Sheen-Cao/Ballooance/Pics/image 47.png

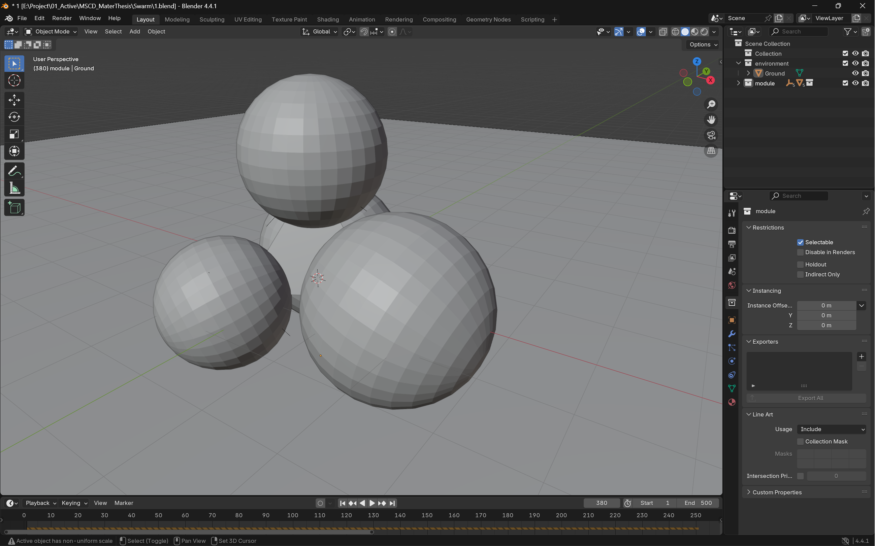
Pics/image 47.png
