Sheen-Cao/Ballooance/Pics/bg_sr_1.jpg

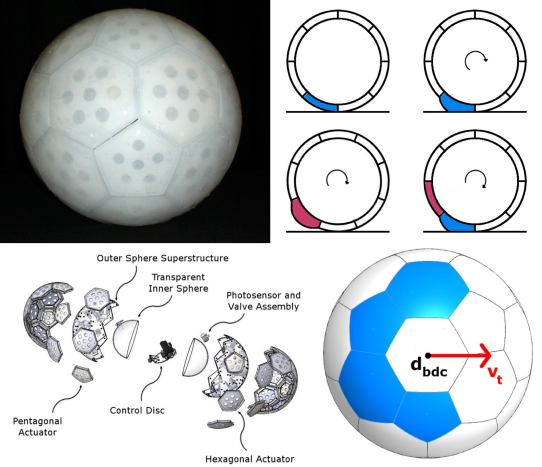
Pics/bg_sr_1.jpg
