Sheen-Cao/Ballooance/README.md

# Ballooance
This this the developing repo for my thesis research project of the inflatable modular robot
