Sheen-Cao/Ballooance/paper_notes/wait_2010_spherical_pneumatic_rolling.md

# Wait, Jackson, Smoot 2010 — Self Locomotion of a Spherical Rolling Robot Using a Novel Deformable Pneumatic Method

**Type:** Conference paper, *2010 IEEE International Conference on Robotics and Automation (ICRA)*
**Authors:** Keith W. Wait (Vanderbilt), Philip J. Jackson, Lanny S. Smoot (**Disney Research**)
**Citation key:** `waitSelfLocomotionSpherical2010`

## Core Claim

A spherical rolling robot whose outer surface is composed of **many individually inflatable rubber bladders** (specifically, a truncated icosahedron with 20 hexagonal + 12 pentagonal cells = 32 segments — soccer-ball topology). Locomotion is achieved by inflating cells near the contact point with the ground, creating a moment that rolls the sphere.

## Critical Correction to Initial §2.1 Draft

My §2.1 v1 said: *"a spherical robot covered with many individually inflatable rubber bladders rolls by shifting its center of mass through selective inflation."*

**This is partially wrong.** The actual mechanism is described in the paper as:

> "Deforming the robot's surface close to its point of contact with the substrate provides the motive force." (Abstract / Introduction)

> "The segment deforms radially outward so that, in addition to touching the ground, it also exerts a moment about the instantaneous center of rotation of the device. This moment causes the tire to begin to rotate." (Sec. II)

So the primary mechanism is **local surface deformation at the contact point creating a rolling moment**, not CoM shift through asymmetric inflation. (CoM may shift slightly as a secondary effect.) When citing in §2.1, replace "shifting its center of mass" with "deforming its surface at the contact point to apply a rolling moment" — or more loosely, "inflating bladders near the ground produces local contact deformation that rolls the sphere."

## Key Technical Details

- **32 inflatable cells** in truncated-icosahedron arrangement (the same topology as a soccer ball / Buckminsterfullerene)
- **3D requires inflating multiple cells**: "Inflation of a single face... results in an indeterminate direction of motion because of the metastability of the resulting deformed geometry." So the controller inflates a *collection* of cells semi-encircling bottom dead center.
- **Steering criteria**: cells are inflated based on geometric criteria involving the displacement vector to bottom dead center and the desired travel direction (Eqs. 1, 2 in paper).
- **Approximate diameter**: 30 cm.
- **Optical commutation**: a passively rolling inner vehicle with a directional remote light source triggers valves housed within the sphere → bladders inflate based on light signal — clever but specific to this implementation.

## Quotable Passages

> "The proposed actuation system consists of a large number of individually inflatable rubber bladders covering a sphere. Inflation of one or more of these bladders imparts a moment to the sphere and coordinated inflation results in a directed motion." (Abstract)

> "All of the propulsive force must somehow be generated by components all of whom are confined within a spherical shape." (Introduction)

> "While in the two-dimensional example... a single inflated segment was sufficient for both locomotion and stability, this is not true for the three-dimensional case." (Sec. II) — *useful for arguing that geometric configuration matters even for inflation-based locomotion.*

## Relevance Per Section

### §2.1 (Soft + Pneumatic) — *primary citation here*
- Demonstrates that pneumatic inflation of soft surfaces can drive locomotion of an entire robot body — even one as constrained-shape as a sphere.
- Shows that **selecting which inflatable cells to actuate** is itself a control decision, separate from how each cell behaves. (This is a small but important precursor to the user's "configuration as design variable" argument.)
- Use as the **second** specific system in §2.1 (after Kim's vibration tripod), because the locomotion mechanism is more topologically interesting than Kim's, with multiple cells coordinated.

### §2.2 (Morphological computation / shape) — *secondary*
- The truncated icosahedron is a **fixed polyhedral topology** — Wait et al. don't compare different polyhedra. Mention them as a precedent for "polyhedron + pneumatic = locomotion" but emphasize they did *not* treat configuration as a variable.

### §2.3 (Modular reconfigurable robotics) — *NOT a primary fit*
- The 32 cells are *not* swappable modules in the MRR sense — they are integral to a single rigid spherical superstructure. Don't cite as MRR.

### §2.4 (Emergence / bottom-up) — *not relevant*
- Control is fully top-down: based on bottom dead center + desired travel direction, the controller computes which cells to inflate. No emergent collective behavior.

## Distinction from the Thesis Work

| | Wait 2010 | This thesis |
|---|---|---|
| Body type | Single spherical shell with embedded cells | Discrete inflated modules forming a polyhedral skeleton |
| Cell role | Surface-deformation actuator on a fixed sphere | Vertex module that defines the body's geometry |
| Geometric variability | Fixed truncated icosahedron, no comparison | Cospherical family (tetra/octa/cube...) systematically compared |
| Controller | Top-down: select cells based on direction vector | Bottom-up CA-style local rules |

**Strong positioning move:** Wait's robot is a *single body with inflation embedded in its surface*. The thesis is *modules whose inflation defines the body itself*. Use this contrast to highlight the qualitative difference between "inflation as actuator on a body" and "inflation as the body."

## Watch out for / Nuances

1. The paper is a **conference paper from 2010** — older context. It precedes the modern soft robotics framing (Rus & Tolley 2015 etc.) and doesn't use that vocabulary.
2. The mechanism is *contact-driven moment*, not CoM shift — be precise in §2.1.
3. The Disney Research affiliation is interesting context (entertainment robotics roots) but not load-bearing for the argument.
4. Wait et al. explicitly note their design "can be easily amended to instead use other linear actuators such as voice coils, electric DC motors with ball screw transmissions" — i.e., they don't see pneumatic as essential to the *principle*, just to *their* implementation. This is a useful disclaimer to cite if anyone challenges the claim that "pneumatic actuation is special" — Wait et al. would mostly disagree.
