Sheen-Cao/Ballooance/ch2_zotero_extract.md

# Ch.2 Background — Zotero Library Extract

Source: `C:\Users\Sheen\Zotero\zotero.sqlite` (snapshot 2026-04-29)

---

## Collection: Emergence and Control (16 items)

### [1] Bio-Inspired Distributed Neural Locomotion Controller (D-NLC) for Robust Locomotion and Emergent Behaviors ()
- **Authors:** Zhang, Zhikai; Guo, Siqi; Kou, Henry; Shikhare, Ishayu et al.
- **Venue:** —
- **Abstract:** Despite having fewer neurons than more complex life forms, insects are still capable of producing astonishing locomotive behaviors, such as traversing diverse environments and making rapid gait adaptations after extreme injury or autotomy. Biologists attribute this to a chain of segmental neuron clusters (ganglia) within insect nervous systems, which act as distributed self-organizing sensorimotor control units. Inspired by the neural structure of the Carausius morosus, the common stick insect, this work introduces the Distributed Neural Locomotion Controller (D-NLC), a modular control framewo...

### [2] From Natural to Arti cial Swarm Intelligence (1999)
- **Authors:** Bonabeau, Eric; Dorigo, Marco; Theraulaz, Guy
- **Venue:** —

### [3] Complex behaviors from local rules in modular self-reconfigurable robots (2001)
- **Authors:** Kubica, J.; Casal, A.; Hogg, T.
- **Venue:** 2001 ICRA. IEEE International Conference on Robotics and Automation (Cat. No.01CH37164)
- **Abstract:** We demonstrate how simple local rules, inspired by social insects, produce complex dynamic behaviors required for locomotion and navigation in modular self-reconfigurable robots. We show how systems made up of many modules respond dynamically to their environment, such as obstacles during navigation. We present control algorithms tested on simulation experiments of TeleCube, a new modular robot developed at Xerox PARC.

### [4] Self-Organization in Biological Systems (2001)
- **Authors:** Camazine, Scott; Deneubourg, Jean-Louis; Franks, Nigel R.; Sneyd, James et al.
- **Venue:** Princeton University Press
- **Abstract:** The synchronized flashing of fireflies at night. The spiraling patterns of an aggregating slime mold. The anastomosing network of army-ant trails. The coordinated movements of a school of fish. Researchers are finding in such patterns--phenomena that have fascinated naturalists for centuries--a fertile new approach to understanding biological systems: the study of self-organization. This book, a primer on self-organization in biological systems for students and other enthusiasts, introduces readers to the basic concepts and tools for studying self-organization and then examines numerous exampl...

### [5] An Information-Theoretic Primer on Complexity, Self-Organisation and Emergence (2006)
- **Authors:** Prokopenko, Mikhail; Boschetti, Fabio; Ryan, Alex
- **Venue:** Complexity
- **Abstract:** Complex Systems Science aims to understand concepts like complexity, self-organization, emergence and adaptation, among others. The inherent fuzziness in complex systems definitions is complicated by the unclear relation among these central processes: does self-organisation emerge or does it set the preconditions for emergence? Does complexity arise by adaptation or is complexity necessary for adaptation to arise? The inevitable consequence of the current impasse is miscommunication among scientists within and across disciplines. We propose a set of concepts, together with their information- t...

### [6] How emergence arises (2006)
- **Authors:** de Haan, J.
- **Venue:** Ecological Complexity
- **Abstract:** The concept of emergence is used in a variety of scientific fields and disciplines to denote an even wider variety of phenomena. This has resulted in a plethora of perspectives and treatments. The diversity of phenomena going under the moniker of emergence raises the question of what these phenomena have in common and whether different types of emergence can be distinguished on general grounds. Since emergence is recognised in so many different fields as a relevant concept, it would be useful to have a general conceptual framework that allows a treatment of emergence without explicit reference...

### [7] How the body shapes the way we think: a new view of intelligence (2007)
- **Authors:** Pfeifer, Rolf; Bongard, Josh
- **Venue:** MIT Press

### [8] Complexity: a guided tour (2011)
- **Authors:** Mitchell, Melanie
- **Venue:** Oxford University Press

### [9] Emergent complex behaviors for swarm robotic systems by local rules (2011)
- **Authors:** Chatty, Abdelhak; Kallel, Ilhem; Gaussier, Philippe; Alimi, Adel M.
- **Venue:** 2011 IEEE Workshop on Robotic Intelligence In Informationally Structured Space
- **Abstract:** This paper describes a clustering process taking inspiration from the cemetery organization of ants. The goal of this paper is (i) to show the importance of the local interactions which allow to produces complex and emergent behavior. (ii) To propose a multi-robot systems in the field of clustering objects allowing optimization of: time of convergence, rate of occupation of the objects in the environment and final number of the clusters. And finally (iii) to propose another system with the use of cognitive robots instead of reactive robots in the same field of clustering objects with generic r...

### [10] What is a complex system? (2013)
- **Authors:** Ladyman, James; Lambert, James; Wiesner, Karoline
- **Venue:** European Journal for Philosophy of Science
- **Abstract:** Complex systems research is becoming ever more important in both the natural and social sciences. It is commonly implied that there is such a thing as a complex system across the disciplines. However, there is no concise definition of a complex system, let alone a definition that all disciplines agree on. We review various attempts to characterize a complex system, and consider a core set of features that are widely associated with complex systems by scientists in the field. We argue that some of these features are neither necessary nor sufficient for complexity, and that some of them are too ...

### [11] Programmable self-assembly in a thousand-robot swarm (2014)
- **Authors:** Rubenstein, Michael; Cornejo, Alejandro; Nagpal, Radhika
- **Venue:** Science
- **Abstract:** Self-assembly enables nature to build complex forms, from multicellular organisms to complex animal structures such as flocks of birds, through the interaction of vast numbers of limited and unreliable individuals. Creating this ability in engineered systems poses challenges in the design of both algorithms and physical systems that can operate at such scales. We report a system that demonstrates programmable self-assembly of complex two-dimensional shapes with a thousand-robot swarm. This was enabled by creating autonomous robots designed to operate in large groups and to cooperate through lo...

### [12] Programmable self-assembly (2015)
- **Authors:** Cademartiri, Ludovico; Bishop, Kyle J. M.
- **Venue:** Nature Materials
- **Abstract:** Two conceptual strategies for encoding information into self-assembling building blocks highlight opportunities and challenges in the realization of programmable colloidal nanostructures.

### [13] The Surprising Creativity of Digital Evolution: A Collection of Anecdotes from the Evolutionary Computation and Artificial Life Research Communities (2020)
- **Authors:** Lehman, Joel; Clune, Jeff; Misevic, Dusan; Adami, Christoph et al.
- **Venue:** Artificial Life
- **Abstract:** Evolution provides a creative fount of complex and subtle adaptations that often surprise the scientists who discover them. However, the creativity of evolution is not limited to the natural world: Artificial organisms evolving in computational environments have also elicited surprise and wonder from the researchers studying them. The process of evolution is an algorithmic process that transcends the substrate in which it occurs. Indeed, many researchers in the field of digital evolution can provide examples of how their evolving algorithms and organisms have creatively subverted their expecta...

### [14] Learning Modular Robot Control Policies (2023)
- **Authors:** Whitman, Julian; Travers, Matthew; Choset, Howie
- **Venue:** IEEE Transactions on Robotics
- **Abstract:** Modular robots can be rearranged into a new design, perhaps each day, to handle a wide variety of tasks by forming a customized robot for each new task. However, reconfiguring just the mechanism is not sufficient: each design also requires its own unique control policy. One could craft a policy from scratch for each new design, but such an approach is not scalable, especially given the large number of designs that can be generated from even a small set of modules. Instead, we create a modular policy framework where the policy structure is conditioned on the hardware arrangement, and use just o...

### [15] Robo-Matter towards reconfigurable multifunctional smart materials (2024)
- **Authors:** Wang, Jing; Wang, Gao; Chen, Huaicheng; Liu, Yanping et al.
- **Venue:** Nature Communications
- **Abstract:** Maximizing materials utilization efficiency via enhancing their reconfigurability and multifunctionality offers a promising avenue in addressing the global challenges in sustainability. To this end, significant efforts have been made in developing reconfigurable multifunctional smart materials, which can exhibit remarkable behaviors such as morphing and self-healing. However, the difficulty in efficiently manipulating and controlling matter at the building block level with manageable cost and complexity, which is crucial to achieving superior responsiveness to environmental clues and stimuli, ...

### [16] Discovery and Deployment of Emergent Robot Swarm Behaviors via Representation Learning and Real2Sim2Real Transfer (2025)
- **Authors:** Mattson, Connor; Raveendra, Varun; Vega, Ricardo; Nowzari, Cameron et al.
- **Venue:** International Foundation for Autonomous Agents and Multiagent Systems
- **Abstract:** Given a swarm of limited-capability robots, we seek to automatically discover the set of possible emergent behaviors. Prior approaches to behavior discovery rely on human feedback or hand-crafted behavior metrics to represent and evolve behaviors and only discover behaviors in simulation, without testing or considering the deployment of these new behaviors on real robot swarms. In this work, we present Real2Sim2Real Behavior Discovery via Self-Supervised Representation Learning, which combines representation learning and novelty search to discover possible emergent behaviors automatically in s...

---

## Collection: Robotic Embodiment (32 items)

### [1] Agile legged locomotion in reconfigurable modular robots ()
- **Authors:** —
- **Venue:** —

### [2] Multifunctional Fluidic Units for Emergent, Responsive Robotic Behaviors ()
- **Authors:** Mousa, Mostafa; Comoretto, Alberto; Overvelde, Johannes T.B.; Forte, Antonio E.
- **Venue:** Advanced Materials
- **Abstract:** Fluidic circuits have shown significant promise in enabling complex functionality in soft robots with a minimal number of input signals. However, implementing complex behaviors typically involves numerous specialized components, resulting in intricate and nonversatile circuits. To address this challenge, a multifunctional fluidic unit designed to operate flexibly as a valve, sensor, or actuator is introduced. This unit provides an extensive design space that allows precise tuning to achieve the desired functionality. In particular, one configuration integrates all three functions simultaneousl...

### [3] troubleshooting_translator_issues [Zotero Documentation] ()
- **Authors:** —
- **Venue:** —

### [4] New Robotics: Design Principles for Intelligent Systems (2005)
- **Authors:** Pfeifer, Rolf; Iida, Fumiya; Bongard, Josh
- **Venue:** Artificial life
- **Abstract:** New robotics is an approach to robotics that, in contrast to traditional robotics, employs ideas and principles from biology. While in the traditional approach there are generally accepted methods (e. g., from control theory), designing agents in the new robotics approach is still largely considered an art. In recent years, we have been developing a set of heuristics, or design principles, that on the one hand capture theoretical insights about intelligent (adaptive) behavior, and on the other provide guidance in actually designing and building systems. In this article we provide an overview o...

### [5] Self locomotion of a spherical rolling robot using a novel deformable pneumatic method (2010)
- **Authors:** Wait, Keith W.; Jackson, Philip J.; Smoot, Lanny S.
- **Venue:** 2010 IEEE International Conference on Robotics and Automation
- **Abstract:** The authors have designed and constructed a new type of actuation for a spherical robot. The proposed actuation system consists of a large number of individually inflatable rubber bladders covering a sphere. Inflation of one or more of these bladders imparts a moment to the sphere and coordinated inflation results in a directed motion. Further, the authors introduce a scheme for steering the robot by correctly selecting the proper bladders to inflate so that motive force is developed in a specified direction. The control scheme utilizes a passively rolling inner vehicle with a directional, rem...

### [6] Design, fabrication and control of soft robots (2015)
- **Authors:** Rus, Daniela; Tolley, Michael T.
- **Venue:** Nature
- **Abstract:** Conventionally, engineers have employed rigid materials to fabricate precise, predictable robotic systems, which are easily modeled as rigid members connected at discrete joints. Natural systems, however, often match or exceed the performance of robotic systems with deformable bodies. Cephalopods, for example, achieve amazing feats of manipulation and locomotion without a skeleton; even vertebrates like humans achieve dynamic gaits by storing elastic energy in their compliant bones and soft tissues. Inspired by nature, engineers have begun to explore the design and control of soft-bodied robot...

### [7] Modular robotic systems: Methods and algorithms for abstraction, planning, control, and synchronization (2015)
- **Authors:** Ahmadzadeh, Hossein; Masehian, Ellips
- **Venue:** Artificial Intelligence
- **Abstract:** While expected applications of Modular Robotic Systems (MRS) span various workspaces, scales, and structures, practical implementations of such systems lag behind their potentials in performing real-world tasks. Challenges of enhancing MRS capabilities not only are limited to designing reliable, responsive, and robust hardware, but also include developing software and algorithms that can effectively fulfill tasks through performing fundamental functions like shape-formation, locomotion, manipulation, etc. Thus, MRS solution methods must be able to resolve problems arising from the tightly-coup...

### [8] A review on locomotion robophysics: the study of movement at the intersection of robotics, soft matter and dynamical systems (2016)
- **Authors:** Aguilar, Jeffrey; Zhang, Tingnan; Qian, Feifei; Kingsbury, Mark et al.
- **Venue:** Reports on Progress in Physics
- **Abstract:** In this review we argue for the creation of a physics of moving systems -- a locomotion "robophysics" -- which we define as the pursuit of the discovery of principles of self generated motion. Robophysics can provide an important intellectual complement to the discipline of robotics, largely the domain of researchers from engineering and computer science. The essential idea is that we must complement study of complex robots in complex situations with systematic study of simplified robophysical devices in controlled laboratory settings and simplified theoretical models. We must thus use the met...

### [9] TEI 2016 Studio: Inflated Curiosity (2016)
- **Authors:** Ou, Jifei; Heibeck, Felix; Ishii, Hiroshi
- **Venue:** Association for Computing Machinery
- **Abstract:** This studio introduces methods of making and controlling inflatable fabric. We provide materials and simple fabrication processes that enable designers to rapidly prototype inflatables with simple hinging transformations or texture change. Furthermore, we introduce a customized hardware that enables designers to rapidly prototype inflatable fabric. The goal of this studio is to provide hands-on experiences of designing inflatable fabric as shape-changing materials and research on shape-changing artifacts. Basic knowledge of programming in Arduino is required. Participants should bring their ow...

### [10] 3D printing of robotic soft actuators with programmable bioinspired architectures (2018)
- **Authors:** Schaffner, Manuel; Faber, Jakob A.; Pianegonda, Lucas; Rühs, Patrick A. et al.
- **Venue:** Nature Communications
- **Abstract:** Soft actuation allows robots to interact safely with humans, other machines, and their surroundings. Full exploitation of the potential of soft actuators has, however, been hindered by the lack of simple manufacturing routes to generate multimaterial parts with intricate shapes and architectures. Here, we report a 3D printing platform for the seamless digital fabrication of pneumatic silicone actuators exhibiting programmable bioinspired architectures and motions. The actuators comprise an elastomeric body whose surface is decorated with reinforcing stripes at a well-defined lead angle. Simila...

### [11] M-Blocks : three dimensional modular self-reconfigurable robots (2018)
- **Authors:** Romanishin, John (John William)
- **Venue:** —
- **Abstract:** This thesis details the development of the 3D M-Blocks modular robot system. Modular self-reconfigurable robots (MSRR) are robotic systems which contain many modules that can form and break connections with other modules, and move on a lattice of other modules in order to form different configurations. The 3D M-Blocks is a new system which attempts to investigate the feasibility of using inertial actuation from reaction wheels in order to pivot modules on a 3D lattice. Many existing systems described in related literature are able to exhibit reconfiguration, but usually these systems are only ...

### [12] A Simple Tripod Mobile Robot Using Soft Membrane Vibration Actuators (2019)
- **Authors:** Kim, DongWook; Kim, Jae In; Park, Yong-Lae
- **Venue:** IEEE Robotics and Automation Letters
- **Abstract:** Recent research on mobile robots has focused on increasing their adaptability to unpredictable and unstructured environments using soft materials and structures, and pneumatic actuators have been widely used in soft mobile robots. In spite of their advantages, existing pneumatic actuators have limitations with regard to control and speed. We propose soft membrane vibration actuators for a simple tripod robot. The proposed actuators are composed of a rigid housing and a soft membrane that creates vibration based on the input air pressure. The mobile robot proposed here has three vibration actua...

### [13] FifoBots: Foldable Soft Robots for Flipping Locomotion (2019)
- **Authors:** Wang, Jiangbei; Fei, Yanqiong; Liu, Zhaoyu
- **Venue:** Soft Robotics
- **Abstract:** In this work, we design a type of soft robots for flipping locomotion, called the FifoBots. Different from most of the current soft robots that perform crawling, rolling, or jumping locomotion, the proposed FifoBots can flip forward and backward like a piece of self-foldable paper. The FifoBots have simple actuation and avoid complicated balance control. This article presents the principle and analysis of the flipping locomotion as well as the prototypes and experiments of the FifoBots. Two schemes of the flipping locomotion are proposed, and each scheme has the linear and quadrilateral morpho...

### [14] Particle robotics based on statistical mechanics of loosely coupled components (2019)
- **Authors:** Li, Shuguang; Batra, Richa; Brown, David; Chang, Hyun-Dong et al.
- **Venue:** Nature
- **Abstract:** Biological organisms achieve robust high-level behaviours by combining and coordinating stochastic low-level components1–3. By contrast, most current robotic systems comprise either monolithic mechanisms4,5 or modular units with coordinated motions6,7. Such robots require explicit control of individual components to perform specific functions, and the failure of one component typically renders the entire robot inoperable. Here we demonstrate a robotic system whose overall behaviour can be successfully controlled by exploiting statistical mechanics phenomena. We achieve this by incorporating ma...

### [15] ShapeBots: Shape-changing Swarm Robots (2019)
- **Authors:** Suzuki, Ryo; Zheng, Clement; Kakehi, Yasuaki; Yeh, Tom et al.
- **Venue:** Association for Computing Machinery
- **Abstract:** We introduce shape-changing swarm robots. A swarm of self-transformable robots can both individually and collectively change their configuration to display information, actuate objects, act as tangible controllers, visualize data, and provide physical affordances. ShapeBots is a concept prototype of shape-changing swarm robots. Each robot can change its shape by leveraging small linear actuators that are thin (2.5 cm) and highly extendable (up to 20cm) in both horizontal and vertical directions. The modular design of each actuator enables various shapes and geometries of self-transformation. W...

### [16] An untethered isoperimetric soft robot (2020)
- **Authors:** Usevitch, Nathan S.; Hammond, Zachary M.; Schwager, Mac; Okamura, Allison M. et al.
- **Venue:** Science Robotics
- **Abstract:** For robots to be useful for real-world applications, they must be safe around humans, be adaptable to their environment, and operate in an untethered manner. Soft robots could potentially meet these requirements; however, existing soft robotic architectures are limited by their ability to scale to human sizes and operate at these scales without a tether to transmit power or pressurized air from an external source. Here, we report an untethered, inflated robotic truss, composed of thin-walled inflatable tubes, capable of shape change by continuously relocating its joints, while its total edge l...

### [17] Surface Actuation and Sensing of a Tensegrity Structure Using Robotic Skins (2021)
- **Authors:** Booth, Joran W.; Cyr-Choinière, Olivier; Case, Jennifer C.; Shah, Dylan et al.
- **Venue:** Soft Robotics
- **Abstract:** Tensegrity robots comprising solid rods connected by tensile cables are of interest due to their flexible and robust nature, which potentially makes them suitable for uneven and unpredictable environments where traditional robots often struggle. Much progress has been made toward attaining locomotion with tensegrity robots. However, measuring the shape of a dynamic tensegrity without the use of external hardware remains a challenge. Here we show how robotic skins may be attached around the exterior of a tensegrity structure, to both control and measure its shape from its surface. The robotic s...

### [18] FreeSN: A Freeform Strut-node Structured Modular Self-reconfigurable Robot - Design and Implementation (2022)
- **Authors:** Tu, Yuxiao; Liang, Guanqi; Lam, Tin Lun
- **Venue:** 2022 International Conference on Robotics and Automation (ICRA)
- **Abstract:** This paper proposes a novel freeform strut-node structured modular self-reconfigurable robot (MSRR) called FreeSN, consisting of strut and node modules. A node module is mainly a low-carbon steel spherical shell. A strut module contains two freeform connectors, which provide strong magnetic connections and flexible spherical motions. The FreeSN system shares the benefits of freeform connection and strut-node structures. The freeform connection brings good adaptability to the environment. The triangle substructures inside the system configuration significantly improve the structural stability. ...

### [19] Modular Robot Design Optimization with Generative Adversarial Networks (2022)
- **Authors:** Hu, Jiaheng; Whitman, Julian; Travers, Matthew; Choset, Howie
- **Venue:** 2022 International Conference on Robotics and Automation (ICRA)
- **Abstract:** Modular robots are made up of a set of components which can be configured and reconfigured to form customized robots for a wide range of tasks. Fully utilizing the flexibility of modular robots is challenging, as it requires the identification of optimal modular designs for each given task, often with limited computation and time. Previous works in design automation achieve efficient run-times by utilizing machine learning to create a one-to-one mapping from task to design. However, the problem of robot design is often multimodal, where multiple distinct designs can be similarly or equally goo...

### [20] New programmable materials can sense their own movements (2022)
- **Authors:** admin
- **Venue:** —
- **Abstract:** MIT researchers have developed a method for 3D printing materials with tunable mechanical properties, that sense how they are moving and interacting with the environment. The researchers create these sensing structures using just one material and a single run on a 3D printer. To accomplish this, the researchers began with 3D-printed lattice materials and incorporated […]

### [21] PneuBots: Modular Inflatables for Playful Exploration of Soft Robotics (2022)
- **Authors:** Youn, Hye Jun; Shtarbanov, Ali
- **Venue:** Association for Computing Machinery
- **Abstract:** PneuBots is a modular soft robotics construction kit consisting of seven types of self-foldable segments with high tensile strength, three types of pneumatic connectors and splitters, and a custom-designed box. The kit enables various assemblies to be made with the modular pieces, allowing creators to explore the world of soft robotics in playful ways. When combined with a FlowIO device, PneuBots allows seamless programmability of the different assemblies, enabling artists, designers, engineers, and makers to create dynamic, shape-changing, and interactive works that can be used for education,...

### [22] A Method for 3D Printing and Rapid Prototyping of Fieldable Untethered Soft Robots (2023)
- **Authors:** Patterson, Zach J.; Patel, Dinesh K.; Bergbreiter, Sarah; Yao, Lining et al.
- **Venue:** Soft Robotics
- **Abstract:** Because they are made of elastically deformable and compliant materials, soft robots can passively change shape and conform to their environment, providing potential advantages over traditional robotics approaches. However, existing manufacturing workflows are often labor intensive and limited in their ability to create highly integrated three-dimensional (3D) heterogeneous material systems. In this study, we address this with a streamlined workflow to produce field-deployable soft robots based on 3D printing with digital light processing (DLP) of silicone-like soft materials. DLP-based 3D pri...

### [23] Flipper-Style Locomotion Through Strong Expanding Modular Robots (2023)
- **Authors:** Chin, Lillian; Burns, Max; Xie, Gregory; Rus, Daniela
- **Venue:** IEEE Robotics and Automation Letters
- **Abstract:** Volume-changing robotic units presents an exciting pathway for modular robotics. However, current attempts have been relatively limited, requiring tethers, complex fabrication or slow cycle times. In this work, we present AuxBots: an auxetic-based approach to create high force, fast cycle time selfcontained modules. By driving the auxetic shell’s expansion with a motor and leadscrew, these robots are capable of expanding their volume by 274% in 0.8 seconds with a maximum strength to weight ratio of 76x. These force and expansion properties enable us to use these modules in conjunction with ﬂex...

### [24] Function Follows Form: An Exploration of Robotic Embodiment through Geometry (2023)
- **Authors:** Chin, Lillian Tiffany
- **Venue:** —
- **Abstract:** Current robot designers often treat a robot’s body as merely a vessel to transport the brain, limiting the potential scope of “embodied intelligence” that is unique to robotics. This cognitivist approach to robot design is in-line with critiques from disability studies, which argues that assuming a single normative body ignores the diversity of human body-environment interactions, unfairly limiting human potential.

This thesis aims to use framings from disability studies to better inform robotic design practice. By examining interactions between a body and its environment — whether a human bo...

### [25] PneuFab: Designing Low-Cost 3D-Printed Inflatable Structures for Blow Molding Artifacts (2023)
- **Authors:** Wang, Guanyun; Zhu, Kuangqi; Zhou, Lingchuan; Guo, Mengyan et al.
- **Venue:** Association for Computing Machinery
- **Abstract:** Access to computer-aided fabrication tools, such as 3D printing, empowers various craft techniques to democratize the creation of artifacts. To afford new blow molding techniques in the field of Human-Computer Interaction, we make efforts to simplify this challenging handy fabrication and enrich the design space of blow molding by taking advantage of the thermoformability and heat deformability of 3D printed thermoplastics. We propose a novel and democratized blow molding technique, PneuFab, enabled by FDM 3D-printed custom structures and temporal triggering methods. Then we implement and eval...

### [26] Reconfigurable Robot Control Using Flexible Coupling Mechanisms (2023)
- **Authors:** Yi, Sha; Sycara, Katia; Temel, Zeynep
- **Venue:** Robotics: Science and Systems 2023
- **Abstract:** Reconfigurable robot swarms are capable of connecting with each other to form complex structures. Current mechanical or magnetic connection mechanisms can be complicated to manufacture, consume high power, have a limited load-bearing capacity, or can only form rigid structures. In this paper, we present our low-cost soft anchor design that enables flexible coupling and decoupling between robots. Our asymmetric anchor requires minimal force to be pushed into the opening of another robot while having a strong pulling force so that the connection between robots can be secured. To maintain this fl...

### [27] Hexagonal electrohydraulic modules for rapidly reconfigurable high-speed robots (2024)
- **Authors:** Yoder, Zachary; Rumley, Ellen H.; Schmidt, Ingemar; Rothemund, Philipp et al.
- **Venue:** Science Robotics
- **Abstract:** Robots made from reconfigurable modular units feature versatility, cost efficiency, and improved sustainability compared with fixed designs. Reconfigurable modules driven by soft actuators provide adaptable actuation, safe interaction, and wide design freedom, but existing soft modules would benefit from high-speed and high-strain actuation, as well as driving methods well-suited to untethered operation. Here, we introduce a class of electrically actuated robotic modules that provide high-speed (a peak contractile strain rate of 4618% per second, 15.8-hertz bandwidth, and a peak specific power...

### [28] Robo-Matter towards reconfigurable multifunctional smart materials (2024)
- **Authors:** Wang, Jing; Wang, Gao; Chen, Huaicheng; Liu, Yanping et al.
- **Venue:** Nature Communications
- **Abstract:** Maximizing materials utilization efficiency via enhancing their reconfigurability and multifunctionality offers a promising avenue in addressing the global challenges in sustainability. To this end, significant efforts have been made in developing reconfigurable multifunctional smart materials, which can exhibit remarkable behaviors such as morphing and self-healing. However, the difficulty in efficiently manipulating and controlling matter at the building block level with manageable cost and complexity, which is crucial to achieving superior responsiveness to environmental clues and stimuli, ...

### [29] SnapInflatables: Designing Inflatables with Snap-through Instability for Responsive Interaction (2024)
- **Authors:** Yang, Yue; Ren, Lei; Chen, Chuang; Hu, Bin et al.
- **Venue:** Association for Computing Machinery
- **Abstract:** Snap-through instability, like the rapid closure of the Venus flytrap, is gaining attention in robotics and HCI. It offers rapid shape reconfiguration, self-sensing, actuation, and enhanced haptic feedback. However, conventional snap-through structures face limitations in fabrication efficiency, scale, and tunability. We introduce SnapInflatables, enabling safe, multi-scale interaction with adjustable sensitivity and force reactions, utilizing the snap-through instability of inflatables. We designed six types of heat-sealing structures enabling versatile snap-through passive motion of inflatab...

### [30] FluidicSwarm: Embodiment of Swarm Robots Using Fluid Behavior Imitation (2025)
- **Authors:** Eguchi, Michikuni; Yoshida, Shigeo; Nishimura, Mai; Hiraki, Takefumi
- **Venue:** Association for Computing Machinery
- **Abstract:** This paper introduces “FluidicSwarm”, a swarm robot control system that enhances the operability of swarm robots by embodying fluid-like swarm robots as an extension of the user’s body. In FluidicSwarm, users can easily manipulate the characteristics of the fluid through hand movements, changing the shape and flexibility of the swarm robot formation. This capability enables the efficient execution of various tasks, such as obstacle avoidance and object transportation, and simplifies the swarm robot arrangement problem in shape representation. Consequently, users can operate swarm robots with g...

### [31] Embodying physical computing into soft robots (2026)
- **Authors:** Wang, Jun; Zhou, Ziyang; Kahak, Ardalan; Li, Suyi
- **Venue:** Nature Communications
- **Abstract:** Softening and onboarding computers and controllers is one of the final frontiers in soft robotics towards their robustness and intelligence for everyday use. In this regard, embodying soft and physical computing presents exciting potential. Physical computing seeks to encode inputs into a mechanical computing kernel and leverage the internal interactions among this kernel’s constituent elements to compute the output. Moreover, such input-to-output evolution can be re-programmable. This perspective paper proposes a framework for embodying physical computing into soft robots and discusses three ...

### [32] Modular reconfigurable robots: Toward on-demand multifunctional applications (2026)
- **Authors:** Liang, Guanqi; Ijspeert, Auke Jan; Yim, Mark; Lam, Tin Lun
- **Venue:** Science Robotics
- **Abstract:** Modular reconfigurable robot (MRR) systems have attracted growing attention because of their versatility and ability to operate across diverse domains. Research on MRR systems has made notable progress, evolving from laboratory settings to real-world applications. However, a gap remains in aligning MRR technologies with specific needs, and a comprehensive review of challenges in practical applications is still lacking. To address these issues, this Review adopts an application-oriented perspective. Focusing on locomotion, manipulation, and construction, it proposes a previously unreported pers...

---

## Collection: Rubber and Rubber Balloons (9 items)

### [1] 1 Stability of Two Rubber Balloons (2004)
- **Authors:** Müller, Ingo; Strehlow, Peter; Müller, Ingo; Strehlow, Peter
- **Venue:** Rubber and Rubber Balloons: Paradigms of Thermodynamics
- **Abstract:** Rubber balloons, that usually adorn children’s parties, can also enchant the scientist. Indeed, there is much more than fun and games to be had with balloons; they form a suitable subject for mathematical studies and an interesting paradigm of methods of modeling in physics and chemistry.

### [2] 2 Kinetic Theory of Rubber (2004)
- **Authors:** Müller, Ingo; Strehlow, Peter; Müller, Ingo; Strehlow, Peter
- **Venue:** Rubber and Rubber Balloons: Paradigms of Thermodynamics
- **Abstract:** We start by considering an elastic bar of any solid material, be it steel, aluminium, wood - or rubber. The bar is fixed to the bottom at one end and a tensile load Pλis applied to the other end slowly, or as we say, quasistatically. This means that the deformation of the bar caused by the tensile load Pλis homogeneous and that the load itself is always equilibrated by the retractive elastic force of the bar. Accelerations are negligible and so is the kinetic energy of the bar and the dissipation, or entropy production. The undistorted length of the bar is Lλ0 and the deformed length under the...

### [3] 3 Non-linear Elasticity (2004)
- **Authors:** Müller, Ingo; Strehlow, Peter; Müller, Ingo; Strehlow, Peter
- **Venue:** Rubber and Rubber Balloons: Paradigms of Thermodynamics
- **Abstract:** In Fig. 3.1 we illustrate the motion of a body from a stress-free reference state, in which a material particle lies at xi0, to a deformed state, - occupied at time t - where the particle lies at xi. We may describe the motion of the particle by the function xi=xi(xj0,t). (3.1)

### [4] 4 Biaxial Stretching of a Rubber Membrane – A Paradigm of Stability, Symmetry-Breaking, and Hysteresis (2004)
- **Authors:** Müller, Ingo; Strehlow, Peter; Müller, Ingo; Strehlow, Peter
- **Venue:** Rubber and Rubber Balloons: Paradigms of Thermodynamics
- **Abstract:** An elastic bar shortens under compression. But, if the compressive force surpasses a critical value, the bar buckles and so does an elastic sheet. This happens for all elastic materials, also for rubber. We learn about this phenomenon as students in a course usually called Strength of Materials, and we have thus come to associate buckling with compression. In rubber, however, buckling can occur in tension, and that is what we shall investigate in this chapter. The instability of an elastic rubber sheet under tension was first discovered by Kearsley.

### [5] 5 Stability of a Single Balloon (2004)
- **Authors:** Müller, Ingo; Strehlow, Peter; Müller, Ingo; Strehlow, Peter
- **Venue:** Rubber and Rubber Balloons: Paradigms of Thermodynamics
- **Abstract:** We recall the pressure-radius characteristic given in (3.24) and its graph which is represented by the solid curve of Fig. 3.4. We assume the elastic constants to be given by (3.16) - at room temperature - and consider the radius r0 and the membrane thickness to have the values

### [6] 6 Stepwise Inflation of a Balloon (2004)
- **Authors:** Müller, Ingo; Strehlow, Peter; Müller, Ingo; Strehlow, Peter
- **Venue:** Rubber and Rubber Balloons: Paradigms of Thermodynamics
- **Abstract:** When we inflate a balloon in the usual manner, namely by blowing air into it by mouth, we first inhale deeply by expanding our lungs. After that we let the lungs relax, building up pressure, and then we push the compressed air into the balloon. Usually we must repeat the process several times to fill the balloon properly. We rely upon the device of Fig. 5.4leftfor a simulation of the process. However, we consider the piston as weightless; after all, gravity plays no role in the function of the lungs.

### [7] 7 Two Balloons – Revisited (2004)
- **Authors:** Müller, Ingo; Strehlow, Peter; Müller, Ingo; Strehlow, Peter
- **Venue:** Rubber and Rubber Balloons: Paradigms of Thermodynamics
- **Abstract:** Let us consider two identical balloons - with radii r1 and r2 respectively - connected in a manner that they can exchange air; and let them be in equilibrium, so that both have the same pressure. If that pressure is small - smaller than , cf. Fig. 5.1 - both balloons must have the same small radii. Similarly for pressures the balloons must both have the same very large radii.

### [8] 8 Many Balloons – The Emergence of a Pseudoelastic Hysteresis (2004)
- **Authors:** Müller, Ingo; Strehlow, Peter; Müller, Ingo; Strehlow, Peter
- **Venue:** Rubber and Rubber Balloons: Paradigms of Thermodynamics
- **Abstract:** The hysteresis represented in Fig. 7.9 for an inflation-deflation process of two communicating balloons is only the beginning. Figure 8.1 shows the pressure during simultaneous inflation and deflation of 4 balloons versus the equivalent stretch which - for n balloons - is defined by

### [9] 9 Stability of the Spherical Shape (2004)
- **Authors:** Müller, Ingo; Strehlow, Peter; Müller, Ingo; Strehlow, Peter
- **Venue:** Rubber and Rubber Balloons: Paradigms of Thermodynamics
- **Abstract:** Ever so often we observe that a balloon, which is spherical in the undistorted state, becomes elongated upon inflation so that we obtain a rotationally symmetric ellipsoid-like shape with the axis of rotation connecting the nipple and its opposite point, the apex.

---

## Collection: Robotics (57 items)

### [1] (PDF) Robotic concrete surface finishing: a moldless approach to creating thermally tuned surface geometry for architectural building components using Profile-3D-Printing ()
- **Authors:** —
- **Venue:** ResearchGate
- **Abstract:** PDF | This paper focuses on describing a novel hybrid concrete printing/casting process we term Profile-3D-Printing. Profile-3D-Printing is an... | Find, read and cite all the research you need on ResearchGate

### [2] Inkspire- Supporting Design Exploration with Generative AI through Analogical Sketching.pdf ()
- **Authors:** —
- **Venue:** —

### [3] Multifunctional Fluidic Units for Emergent, Responsive Robotic Behaviors ()
- **Authors:** Mousa, Mostafa; Comoretto, Alberto; Overvelde, Johannes T.B.; Forte, Antonio E.
- **Venue:** Advanced Materials
- **Abstract:** Fluidic circuits have shown significant promise in enabling complex functionality in soft robots with a minimal number of input signals. However, implementing complex behaviors typically involves numerous specialized components, resulting in intricate and nonversatile circuits. To address this challenge, a multifunctional fluidic unit designed to operate flexibly as a valve, sensor, or actuator is introduced. This unit provides an extensive design space that allows precise tuning to achieve the desired functionality. In particular, one configuration integrates all three functions simultaneousl...

### [4] Sparsh: Self-supervised touch representations for vision-based tactile sensing ()
- **Authors:** Higuera, Carolina; Sharma, Akash; Bodduluri, Chaithanya Krishna; Fan, Taosha et al.
- **Venue:** —

### [5] StylizedGS: Controllable Stylization for 3D Gaussian Splatting | IEEE Journals & Magazine | IEEE Xplore ()
- **Authors:** —
- **Venue:** —

### [6] Tactile sensing for Robot Learning: Development to Deployment ()
- **Authors:** Bhirangi, Raunaq Mahesh
- **Venue:** —

### [7] SOFT ROBOTICS (2011)
- **Authors:** —
- **Venue:** —
- **Abstract:** SOFT ROBOTICS is a project of IaaC, Institute for Advanced Architecture of Catalonia developed at Master in Advanced Architecture in 2016/2017, for Programming Seminar by: Students:Guoliang Zhang, Nasser Ghannam, Mohamad Alchawa, Dongliang Ye Senior Faculty: Areti Markopoulou Fabrication expert:...

### [8] M-blocks: Momentum-driven, magnetic modular robots (2013)
- **Authors:** Romanishin, John W.; Gilpin, Kyle; Rus, Daniela
- **Venue:** 2013 IEEE/RSJ International Conference on Intelligent Robots and Systems
- **Abstract:** In this paper, we describe a novel self-assembling, self-reconfiguring cubic robot that uses pivoting motions to change its intended geometry. Each individual module can pivot to move linearly on a substrate of stationary modules. The modules can use the same operation to perform convex and concave transitions to change planes. Each module can also move independently to traverse planar unstructured environments. The modules achieve these movements by quickly transferring angular momentum accumulated in a self-contained flywheel to the body of the robot. The system provides a simplified realiza...

### [9] Programmable self-assembly in a thousand-robot swarm (2014)
- **Authors:** Rubenstein, Michael; Cornejo, Alejandro; Nagpal, Radhika
- **Venue:** Science
- **Abstract:** Self-assembly enables nature to build complex forms, from multicellular organisms to complex animal structures such as flocks of birds, through the interaction of vast numbers of limited and unreliable individuals. Creating this ability in engineered systems poses challenges in the design of both algorithms and physical systems that can operate at such scales. We report a system that demonstrates programmable self-assembly of complex two-dimensional shapes with a thousand-robot swarm. This was enabled by creating autonomous robots designed to operate in large groups and to cooperate through lo...

### [10] Design, fabrication and control of soft robots (2015)
- **Authors:** Rus, Daniela; Tolley, Michael T.
- **Venue:** Nature
- **Abstract:** Conventionally, engineers have employed rigid materials to fabricate precise, predictable robotic systems, which are easily modelled as rigid members connected at discrete joints. Natural systems, however, often match or exceed the performance of robotic systems with deformable bodies. Cephalopods, for example, achieve amazing feats of manipulation and locomotion without a skeleton; even vertebrates such as humans achieve dynamic gaits by storing elastic energy in their compliant bones and soft tissues. Inspired by nature, engineers have begun to explore the design and control of soft-bodied r...

### [11] A review on locomotion robophysics: the study of movement at the intersection of robotics, soft matter and dynamical systems (2016)
- **Authors:** Aguilar, Jeffrey; Zhang, Tingnan; Qian, Feifei; Kingsbury, Mark et al.
- **Venue:** Reports on Progress in Physics
- **Abstract:** In this review we argue for the creation of a physics of moving systems -- a locomotion "robophysics" -- which we define as the pursuit of the discovery of principles of self generated motion. Robophysics can provide an important intellectual complement to the discipline of robotics, largely the domain of researchers from engineering and computer science. The essential idea is that we must complement study of complex robots in complex situations with systematic study of simplified robophysical devices in controlled laboratory settings and simplified theoretical models. We must thus use the met...

### [12] Soft robotics: Technologies and systems pushing the boundaries of robot abilities (2016)
- **Authors:** Laschi, Cecilia; Mazzolai, Barbara; Cianchetti, Matteo
- **Venue:** Science Robotics
- **Abstract:** The proliferation of soft robotics research worldwide has brought substantial achievements in terms of principles, models, technologies, techniques, and prototypes of soft robots. Such achievements are reviewed here in terms of the abilities that they provide robots that were not possible before. An analysis of the evolution of this field shows how, after a few pioneering works in the years 2009 to 2012, breakthrough results were obtained by taking seminal technological and scientific challenges related to soft robotics from actuation and sensing to modeling and control. Further progress in so...

### [13] GelSight: High-Resolution Robot Tactile Sensors for Estimating Geometry and Force (2017)
- **Authors:** Yuan, Wenzhen; Dong, Siyuan; Adelson, Edward
- **Venue:** Diversity
- **Abstract:** Tactile sensing is an important perception mode for robots, but the existing tactile technologies have multiple limitations. What kind of tactile information robots need, and how to use the information, remain open questions. We believe a soft sensor surface and high-resolution sensing of geometry should be important components of a competent tactile sensor. In this paper, we discuss the development of a vision-based optical tactile sensor, GelSight. Unlike the traditional tactile sensors which measure contact force, GelSight basically measures geometry, with very high spatial resolution. The ...

### [14] Printflatables: Printing Human-Scale, Functional and Dynamic Inflatable Objects (2017)
- **Authors:** Sareen, Harpreet; Umapathi, Udayan; Shin, Patrick; Kakehi, Yasuaki et al.
- **Venue:** CHI '17: CHI Conference on Human Factors in Computing Systems

### [15] Design of a multi-agent, fiber composite digital fabrication system (2018)
- **Authors:** Kayser, Markus; Cai, Levi; Falcone, Sara; Bader, Christoph et al.
- **Venue:** Science Robotics
- **Abstract:** Swarm-based fabrication of interwoven composite tubes via a fully autonomous, cooperative system can help create architectural-scale structures in effective and efficient ways, including in remote environments.

### [16] GridDrones: A Self-Levitating Physical Voxel Lattice for Interactive 3D Surface Deformations (2018)
- **Authors:** Braley, Sean; Rubens, Calvin; Merritt, Timothy; Vertegaal, Roel
- **Venue:** Association for Computing Machinery
- **Abstract:** We present GridDrones, a self-levitating programmable matter platform that can be used for representing 2.5D voxel grid relief maps capable of rendering unsupported structures and 3D transformations. GridDrones consists of cube-shaped nanocopters that can be placed in a volumetric 1xnxn mid-air grid, which is demonstrated here with 15 voxels. The number of voxels and scale is only limited by the size of the room and budget. Grid deformations can be applied interactively to this voxel lattice by manually selecting a set of voxels, then assigning a continuous topological relationship between vox...

### [17] M-Blocks : three dimensional modular self-reconfigurable robots (2018)
- **Authors:** Romanishin, John (John William)
- **Venue:** —
- **Abstract:** This thesis details the development of the 3D M-Blocks modular robot system. Modular self-reconfigurable robots (MSRR) are robotic systems which contain many modules that can form and break connections with other modules, and move on a lattice of other modules in order to form different configurations. The 3D M-Blocks is a new system which attempts to investigate the feasibility of using inertial actuation from reaction wheels in order to pivot modules on a 3D lattice. Many existing systems described in related literature are able to exhibit reconfiguration, but usually these systems are only ...

### [18] Learning the signatures of the human grasp using a scalable tactile glove (2019)
- **Authors:** Sundaram, Subramanian; Kellnhofer, Petr; Li, Yunzhu; Zhu, Jun-Yan et al.
- **Venue:** Nature
- **Abstract:** Humans can feel, weigh and grasp diverse objects, and simultaneously infer their material properties while applying the right amount of force—a challenging set of tasks for a modern robot1. Mechanoreceptor networks that provide sensory feedback and enable the dexterity of the human grasp2 remain difficult to replicate in robots. Whereas computer-vision-based robot grasping strategies3–5 have progressed substantially with the abundance of visual data and emerging machine-learning tools, there are as yet no equivalent sensing platforms and large-scale datasets with which to probe the use of the ...

### [19] Venous Materials: Towards Interactive Fluidic Mechanisms (2020)
- **Authors:** Mor, Hila; Yu, Tianyu; Nakagaki, Ken; Miller, Benjamin Harvey et al.
- **Venue:** CHI '20: CHI Conference on Human Factors in Computing Systems

### [20] Learning human–environment interactions using conformal tactile textiles (2021)
- **Authors:** Luo, Yiyue; Li, Yunzhu; Sharma, Pratyusha; Shou, Wan et al.
- **Venue:** Nature Electronics
- **Abstract:** Recording, modelling and understanding tactile interactions is important in the study of human behaviour and in the development of applications in healthcare and robotics. However, such studies remain challenging because existing wearable sensory interfaces are limited in terms of performance, flexibility, scalability and cost. Here, we report a textile-based tactile learning platform that can be used to record, monitor and learn human–environment interactions. The tactile textiles are created via digital machine knitting of inexpensive piezoresistive fibres, and can conform to arbitrary three...

### [21] Material characterization of workability and process imaging for robotic concrete finishing (2021)
- **Authors:** Liu, Jingyang; Lee, Yi-chin; Bard, Joshua
- **Venue:** Construction Robotics
- **Abstract:** In this paper, we discuss a robotic-assisted concrete finishing method for fabricating architectural panels. Concrete finishing is an important process for producing architectural elements with acceptable surface quality. It is also a challenging process conventionally relying on skillful laborers. We describe a hybrid framework incorporating both human skill and robotics in the concrete finishing process and a multi-phase sensing strategy to assist in part touch-up and to validate final surface quality. The paper discusses a general approach to finishing from three perspectives: (1) Material ...

### [22] Joint Action, Adaptation, and Entrainment in Human-Robot Interaction (2022)
- **Authors:** Fourie, Christopher; Figueroa, Nadia; Shah, Julie; Bieńkiewicz, Marta et al.
- **Venue:** IEEE Press
- **Abstract:** Research in joint action focuses on the psychological, neurological, and physical mechanisms by which humans collaborate with other agents, and overlaps with several domains related to human-robot interaction. The development of artificial systems that can support or emulate the requisite aspects of joint action could lead to improved human-robot team performance as well as improvements in subjective metrics (e.g., trust). This workshop highlights theoretical and technical considerations about human-robot joint action and real-time adaptation, with a particular focus on socio-motor entrainment...

### [23] Layer by Layer, Patterned Valves Enable Programmable Soft Surfaces (2022)
- **Authors:** Gonzalez, Jesse T.; Hudson, Scott E.
- **Venue:** Proc. ACM Interact. Mob. Wearable Ubiquitous Technol.
- **Abstract:** Programmable surfaces, which can be instructed to alter their shape or texture, may one day serve as a platform for tangible interfaces and adaptive environments. But so far, these structures have been constrained in scale by a challenging fabrication process, as the numerous constituent actuators must be built and assembled individually. We look towards emerging trends in mechanical engineering and consider an alternate framework --- layer-driven design, which enables the production of dynamic, discretely-actuated surfaces at multiple scales. By centering the construction around patterning an...

### [24] PneuBots: Modular Inflatables for Playful Exploration of Soft Robotics (2022)
- **Authors:** Youn, Hye Jun; Shtarbanov, Ali
- **Venue:** Association for Computing Machinery
- **Abstract:** PneuBots is a modular soft robotics construction kit consisting of seven types of self-foldable segments with high tensile strength, three types of pneumatic connectors and splitters, and a custom-designed box. The kit enables various assemblies to be made with the modular pieces, allowing creators to explore the world of soft robotics in playful ways. When combined with a FlowIO device, PneuBots allows seamless programmability of the different assemblies, enabling artists, designers, engineers, and makers to create dynamic, shape-changing, and interactive works that can be used for education,...

### [25] Autonomous self-burying seed carriers for aerial seeding (2023)
- **Authors:** Luo, Danli; Maheshwari, Aditi; Danielescu, Andreea; Li, Jiaji et al.
- **Venue:** Nature
- **Abstract:** Aerial seeding can quickly cover large and physically inaccessible areas1 to improve soil quality and scavenge residual nitrogen in agriculture2, and for postfire reforestation3–5 and wildland restoration6,7. However, it suffers from low germination rates, due to the direct exposure of unburied seeds to harsh sunlight, wind and granivorous birds, as well as undesirable air humidity and temperature1,8,9. Here, inspired by Erodium seeds10–14, we design and fabricate self-drilling seed carriers, turning wood veneer into highly stiff (about 4.9 GPa when dry, and about 1.3 GPa when wet) and hygromo...

### [26] Computational Design of Closed-Chain Linkages: Hopping Robot Driven by Morphological Computation (2023)
- **Authors:** Nasonov, Kirill V.; Ivolga, Dmitriy V.; Borisov, Ivan I.; Kolyubin, Sergey A.
- **Venue:** 2023 IEEE International Conference on Robotics and Automation (ICRA)
- **Abstract:** The main advantages of legged robots over wheeled ones are their abilities to traverse on uneven terrain due to the use of intermittent contacts and an ability to shift the center of mass relative to the contact location. A robot's leg design can be implemented by using an open-chain mechanism actuated with high-density torque actuators though this solution needs a vast energy budget. An alternative way to design a leg mechanism is the application of morphological computation principle. According to the principle, most of the desired robot's behavior can be delegated to the mechanics with mini...

### [27] Exploring Shape Designs for Soft Robotics and Users’ Associations with Them (2023)
- **Authors:** Brocker, Anke; Nedorubkova, Ekaterina; Voelker, Simon; Borchers, Jan
- **Venue:** Association for Computing Machinery
- **Abstract:** Soft robotics provides flexible structures and materials that move in natural and organic ways. They facilitate creating safe and tolerant mechanisms for human–machine interaction. This makes soft robotics attractive for tasks that rigid robots are unable to carry out. Users may also display a higher acceptance of soft robots compared to rigid robots because their natural way of movement helps users to relate to scenarios they know from everyday life, making the interaction with the soft robot feel more intuitive. However, the variety of soft robotics shape designs, and how to integrate them i...

### [28] Function Follows Form: An Exploration of Robotic Embodiment through Geometry (2023)
- **Authors:** Chin, Lillian Tiffany
- **Venue:** —
- **Abstract:** Current robot designers often treat a robot’s body as merely a vessel to transport the brain, limiting the potential scope of “embodied intelligence” that is unique to robotics. This cognitivist approach to robot design is in-line with critiques from disability studies, which argues that assuming a single normative body ignores the diversity of human body-environment interactions, unfairly limiting human potential.

This thesis aims to use framings from disability studies to better inform robotic design practice. By examining interactions between a body and its environment — whether a human bo...

### [29] Industry 5.0: Enhancing Human-Robot Collaboration through Collaborative Robots – A Review (2023)
- **Authors:** R, Raffik; Sathya, Rithish Ramamoorthy; V, Vaishali; S, Balavedhaa et al.
- **Venue:** 2023 2nd International Conference on Advancements in Electrical, Electronics, Communication, Computing and Automation (ICAECA)
- **Abstract:** Modern production systems are currently changing, moving from mass production to mass customization logic, as described in Industry 5.0. The aim of Industry 5.0 is to outperform conventional manufacturing techniques by creating interconnected systems that include everything from machinery, robots, and workers to goods and consumers. This is accomplished by fully integrating the physical and virtual worlds. It focuses on building intelligent hybrid workspaces where robots share labour-intensive duties to increase productivity and safety in a range of industrial sectors. Cobots, or collaborative...

### [30] Machine learning–driven self-discovery of the robot body morphology (2023)
- **Authors:** Díaz Ledezma, Fernando; Haddadin, Sami
- **Venue:** Science Robotics
- **Abstract:** The morphology of a robot is typically assumed to be known, and data from external measuring devices are used mainly for its kinematic calibration. In contrast, we take an agent-centric perspective and ponder the vaguely explored question of whether a robot could learn elements of its morphology by itself, relying on minimal prior knowledge and depending only on unorganized proprioceptive signals. To answer this question, we propose a mutual information–based representation of the relationships between the proprioceptive signals of a robot, which we call proprioceptive information graphs (π-gr...

### [31] Robots That Ask For Help: Uncertainty Alignment for Large Language Model Planners (2023)
- **Authors:** Ren, Allen Z.; Dixit, Anushri; Bodrova, Alexandra; Singh, Sumeet et al.
- **Venue:** —
- **Abstract:** Large language models (LLMs) exhibit a wide range of promising capabilities -- from step-by-step planning to commonsense reasoning -- that may provide utility for robots, but remain prone to confidently hallucinated predictions. In this work, we present KnowNo, which is a framework for measuring and aligning the uncertainty of LLM-based planners such that they know when they don't know and ask for help when needed. KnowNo builds on the theory of conformal prediction to provide statistical guarantees on task completion while minimizing human help in complex multi-step planning settings. Experim...

### [32] A Playground for Soft Robot Design (2024)
- **Authors:** Boer, Laurens; Bewley, Harvey
- **Venue:** Association for Computing Machinery
- **Abstract:** Human-Robot Interaction researchers and design researchers increasingly recognize that they can benefit from each other's tools, methods, and approaches. However, there are practical and epistemological barriers to productively do so. In this demonstration we show how we, as design researchers, developed a playground for making distinctive soft robotic surfaces that can quickly be assembled and experienced first-hand. As such, the playground and our process serves as an exemplar of a designerly way of working with HRI.

### [33] Advanced Design of Soft Robots with Artificial Intelligence (2024)
- **Authors:** Cao, Ying; Xu, Bingang; Li, Bin; Fu, Hong
- **Venue:** Nano-Micro Letters
- **Abstract:** A comprehensive review focused on the whole systems of the soft robotics with artificial intelligence, which can feel, think, react and interact with humans, is presented.The design strategies concerning about various aspects of the soft robotics, like component materials, device structures, prepared technologies, integrated method, and potential applications, are summarized.A broad outlook on the future considerations for the soft robots is proposed.

### [34] An agile monopedal hopping quadcopter with synergistic hybrid locomotion (2024)
- **Authors:** Bai, Songnan; Pan, Qiqi; Ding, Runze; Jia, Huaiyuan et al.
- **Venue:** Science Robotics
- **Abstract:** Nature abounds with examples of superior mobility through the fusion of aerial and ground movement. Drawing inspiration from such multimodal locomotion, we introduce a high-performance hybrid hopping and flying robot. The proposed robot seamlessly integrates a nano quadcopter with a passive telescopic leg, overcoming limitations of previous jumping mechanisms that rely on stance phase leg actuation. Based on the identified dynamics, a thrust-based control method and detachable active aerodynamic surfaces were devised for the robot to perform continuous jumps with and without position feedback....

### [35] AnySkin: Plug-and-play Skin Sensing for Robotic Touch (2024)
- **Authors:** Bhirangi, Raunaq; Pattabiraman, Venkatesh; Erciyes, Enes; Cao, Yifeng et al.
- **Venue:** —
- **Abstract:** While tactile sensing is widely accepted as an important and useful sensing modality, its use pales in comparison to other sensory modalities like vision and proprioception. AnySkin addresses the critical challenges that impede the use of tactile sensing -- versatility, replaceability, and data reusability. Building on the simplistic design of ReSkin, and decoupling the sensing electronics from the sensing interface, AnySkin simplifies integration making it as straightforward as putting on a phone case and connecting a charger. Furthermore, AnySkin is the first uncalibrated tactile-sensor with...

### [36] Doodlebot: An Educational Robot for Creativity and AI Literacy (2024)
- **Authors:** Williams, Randi; Ali, Safinah; Alcantara, Raúl; Burghleh, Tasneem et al.
- **Venue:** Association for Computing Machinery
- **Abstract:** Today, Artificial Intelligence (AI) is prevalent in everyday life, with emerging technologies like AI companions, autonomous vehicles, and AI art tools poised to significantly transform the future. The development of AI curricula that shows people how AI works and what they can do with it is a powerful way to prepare everyone, and especially young learners, for an increasingly AI-driven world. Educators often employ robotic toolkits in the classroom to boost engagement and learning. However, these platforms are generally unsuitable for young learners and learners without programming expertise....

### [37] Hexagonal electrohydraulic modules for rapidly reconfigurable high-speed robots (2024)
- **Authors:** Yoder, Zachary; Rumley, Ellen H.; Schmidt, Ingemar; Rothemund, Philipp et al.
- **Venue:** Science Robotics
- **Abstract:** Robots made from reconfigurable modular units feature versatility, cost efficiency, and improved sustainability compared with fixed designs. Reconfigurable modules driven by soft actuators provide adaptable actuation, safe interaction, and wide design freedom, but existing soft modules would benefit from high-speed and high-strain actuation, as well as driving methods well-suited to untethered operation. Here, we introduce a class of electrically actuated robotic modules that provide high-speed (a peak contractile strain rate of 4618% per second, 15.8-hertz bandwidth, and a peak specific power...

### [38] Multi-agent robotic systems and exploration algorithms: Applications for data collection in construction sites (2024)
- **Authors:** Prieto, Samuel A.; Giakoumidis, Nikolaos; Soto, Borja Garcia de
- **Venue:** Journal of Field Robotics
- **Abstract:** The construction industry has been notoriously slow to adopt new technology and embrace automation. This has resulted in lower efficiency and productivity compared to other industries where automation has been widely adopted. However, recent advancements in robotics and artificial intelligence offer a potential solution to this problem. In this study, a methodology is proposed to integrate multi-robotic systems in construction projects with the aim of increasing efficiency and productivity. The proposed approach involves the use of multiple robot and human agents working collaboratively to com...

### [39] Multimodal Human–Robot Interaction for Human-Centric Smart Manufacturing: A Survey (2024)
- **Authors:** Wang, Tian; Zheng, Pai; Li, Shufei; Wang, Lihui
- **Venue:** Advanced Intelligent Systems
- **Abstract:** Human–robot interaction (HRI) has escalated in notability in recent years, and multimodal communication and control strategies are necessitated to guarantee a secure, efficient, and intelligent HRI experience. In spite of the considerable focus on multimodal HRI, comprehensive disquisitions delineating various modalities and intricately analyzing their combinations remain elusive, consequently limiting holistic understanding and future advancements. This article aspires to bridge this inadequacy by conducting a profound exploration of multimodal HRI, predominantly concentrating on four princip...

### [40] Recent Trends of Multi-Agent AI Systems in Robotics Control (2024)
- **Authors:** Swarms
- **Venue:** —
- **Abstract:** As we delve deeper into the intersection of artificial intelligence (AI) and robotics, we are faced with an array of complex challenges…

### [41] Robotic Metamaterials: A Modular System for Hands-On Configuration of Ad-Hoc Dynamic Applications (2024)
- **Authors:** Cui, Zhitong; Wang, Shuhong; Han, Violet Yinuo; Rae-Grant, Tucker et al.
- **Venue:** Association for Computing Machinery
- **Abstract:** We propose augmenting initially passive structures built from simple repeated cells, with novel active units to enable dynamic, shape-changing, and robotic applications. Inspired by metamaterials that can employ mechanisms, we build a framework that allows users to configure cells of this passive structure to allow it to perform complex tasks. A key benefit is that our structures can be repeatedly (re)configured by users inserting our configuration units to turn the passive material into, e.g., locomotion robots, integrated motion platforms, or interactive interfaces, as we demonstrate in this...

### [42] The Heart and the Chip: Our Bright Future with Robots Download (2024)
- **Authors:** Daniela Rus, Gregory Mone
- **Venue:** —
- **Abstract:** Download Book "The Heart and the Chip: Our Bright Future with Robots" by Author "Daniela Rus" in [PDF] [EPUB]. Original Title ISBN # "9781324050230" and ASIN # "1324050233" published on "March 5, 2024" in Edition Language: "English". Get Full eBook File name "The_Heart_and_the_Chip_Our_Bright_Future_with_Robots_-_Daniela_rus.pdf .epub" Format Complete Free. Genres: "Artificial Intelligence, Business, Nonfiction, Science, Technology".

### [43] Universal Manipulation Interface: In-The-Wild Robot Teaching Without In-The-Wild Robots (2024)
- **Authors:** Chi, Cheng; Xu, Zhenjia; Pan, Chuer; Cousineau, Eric et al.
- **Venue:** Robotics: Science and Systems 2024
- **Abstract:** We present Universal Manipulation Interface (UMI) – a data collection and policy learning framework that allows direct skill transfer from in-the-wild human demonstrations to deployable robot policies. UMI employs hand-held grippers coupled with careful interface design to enable portable, lowcost, and information-rich data collection for challenging bimanual and dynamic manipulation demonstrations. To facilitate deployable policy learning, UMI incorporates a carefully designed policy interface with inference-time latency matching and a relative-trajectory action representation. The resulting ...

### [44] Using 3-D LiDAR Data for Safe Physical Human-Robot Interaction (2024)
- **Authors:** Arora, Sarthak; Subramanian, Karthik; Adamides, Odysseus; Sahin, Ferat
- **Venue:** —
- **Abstract:** This paper explores the use of 3D lidar in a physical Human-Robot Interaction (pHRI) scenario. To achieve the aforementioned, experiments were conducted to mimic a modern shop-floor environment. Data was collected from a pool of seventeen participants while performing pre-determined tasks in a shared workspace with the robot. To demonstrate an end-to-end case; a perception pipeline was developed that leverages reflectivity, signal, near-infrared, and point-cloud data from a 3-D lidar. This data is then used to perform safety based control whilst satisfying the speed and separation monitoring (...

### [45] ASAP: Aligning Simulation and Real-World Physics for Learning Agile Humanoid Whole-Body Skills (2025)
- **Authors:** He, Tairan; Gao, Jiawei; Xiao, Wenli; Zhang, Yuanhang et al.
- **Venue:** —
- **Abstract:** Humanoid robots hold the potential for unparalleled versatility in performing human-like, whole-body skills. However, achieving agile and coordinated whole-body motions remains a significant challenge due to the dynamics mismatch between simulation and the real world. Existing approaches, such as system identification (SysID) and domain randomization (DR) methods, often rely on labor-intensive parameter tuning or result in overly conservative policies that sacrifice agility. In this paper, we present ASAP (Aligning Simulation and Real-World Physics), a two-stage framework designed to tackle th...

### [46] Acrobatics at the insect scale: A durable, precise, and agile micro–aerial robot (2025)
- **Authors:** Kim, Suhan; Hsiao, Yi-Hsuan; Ren, Zhijian; Huang, Jiashu et al.
- **Venue:** Science Robotics
- **Abstract:** Aerial insects are exceptionally agile and precise owing to their small size and fast neuromotor control. They perform impressive acrobatic maneuvers when evading predators, recovering from wind gust, or landing on moving objects. Flapping-wing propulsion is advantageous for flight agility because it can generate large changes in instantaneous forces and torques. During flapping-wing flight, wings, hinges, and tendons of pterygote insects endure large deformation and high stress hundreds of times each second, highlighting the outstanding flexibility and fatigue resistance of biological structu...

### [47] Bridging hard and soft: Mechanical metamaterials enable rigid torque transmission in soft robots (2025)
- **Authors:** Carton, Molly; Kowalewski, Jakub F.; Guo, Jiani; Alpert, Jacob F. et al.
- **Venue:** Science Robotics
- **Abstract:** Torque and continuous rotation are fundamental methods of actuation and manipulation in rigid robots. Soft robot arms use soft materials and structures to mimic the passive compliance of biological arms that bend and extend. This use of compliance prevents soft arms from continuously transmitting and exerting torques to interact with their environment. Here, we show how relying on patterning structures instead of inherent material properties allows soft robotic arms to remain compliant while continuously transmitting torque to their environment. We demonstrate a soft robotic arm made from a pa...

### [48] CompAct: Designing Interconnected Compliant Mechanisms with Targeted Actuation Transmissions (2025)
- **Authors:** Yang, Humphrey; Shen, I-Chao; Martelaro, Nikolas; Zhu, Bo et al.
- **Venue:** Association for Computing Machinery
- **Abstract:** Compliant mechanisms enable the creation of compact and easy-to-fabricate devices for tangible interaction. This work explores interconnected compliant mechanisms consisting of multiple joints and rigid bodies to transmit and process displacements as signals that result from physical interactions. As these devices are difficult to design due to their vast and complex design space, we developed a graph-based design algorithm and computational tool to help users program and customize such computational functions and procedurally model physical designs. When combined with active materials with ac...

### [49] FluidicSwarm: Embodiment of Swarm Robots Using Fluid Behavior Imitation (2025)
- **Authors:** Eguchi, Michikuni; Yoshida, Shigeo; Nishimura, Mai; Hiraki, Takefumi
- **Venue:** Association for Computing Machinery
- **Abstract:** This paper introduces “FluidicSwarm”, a swarm robot control system that enhances the operability of swarm robots by embodying fluid-like swarm robots as an extension of the user’s body. In FluidicSwarm, users can easily manipulate the characteristics of the fluid through hand movements, changing the shape and flexibility of the swarm robot formation. This capability enables the efficient execution of various tasks, such as obstacle avoidance and object transportation, and simplifies the swarm robot arrangement problem in shape representation. Consequently, users can operate swarm robots with g...

### [50] Hybrid locomotion at the insect scale: Combined flying and jumping for enhanced efficiency and versatility (2025)
- **Authors:** Hsiao, Yi-Hsuan; Bai, Songnan; Guan, Zhongtao; Kim, Suhan et al.
- **Venue:** Science Advances
- **Abstract:** Insect-scale robots face two major locomotive challenges: constrained energetics and large obstacles that far exceed their size. Terrestrial locomotion is efficient yet mostly limited to flat surfaces. In contrast, flight is versatile for overcoming obstacles but requires high power to stay aloft. Here, we present a hopping design that combines a subgram flapping-wing robot with a telescopic leg. Our robot can hop continuously while controlling jump height and frequency in the range of 1.5 to 20 centimeters and 2 to 8.4 hertz. The robot can follow positional set points, overcome tall obstacles...

### [51] LLM-driven agent for speech-enabled control of industrial robots: A case study in snow-crab quality inspection (2025)
- **Authors:** Kadri, Ibrahim; Selouani, Sid Ahmed; Ghribi, Mohsen; Ghali, Rayen et al.
- **Venue:** Results in Engineering
- **Abstract:** This study investigates the integration of large language models (LLMs) into a voice- and vision-based robotic control system in autonomous industrial applications. The main objective is to demonstrate that an LLM-based agent can interpret natural instructions, dynamically plan movements, and execute robotic actions without domain-specific supervised learning, thereby enabling autonomous robotic planning. The proposed system relies on a voice interface, an LLM agent, and tools for real-time robot control. A dedicated communication module was developed to ensure the full control of a KUKA indus...

### [52] Large-Expansion Bi-Layer Auxetics Create Compliant Cellular Motion (2025)
- **Authors:** Chin, Lillian; Xie, Gregory; Lipton, Jeffrey; Rus, Daniela
- **Venue:** 2025 IEEE International Conference on Robotics and Automation (ICRA)
- **Abstract:** There is significant interest in creating compliant modular robots that can change their volume. Inspired by how biological cells move, these systems can potentially combine the resilience of modular robotics with the increased environmental interactions of soft robotics. However, current versions have limited speed, expansion, and portability. In this paper, we address these concerns through AuxSwarm, a compliant system composed of auxetic-based robotic voxels. These voxels control their volume through a scissor-like bi-layer auxetic design, growing up to 1.57 times their original size in 0.2...

### [53] Multi-Agent Systems for Robotic Autonomy with LLMs (2025)
- **Authors:** Chen, Junhong; Yang, Ziqi; Xu, Haoyuan G.; Zhang, Dandan et al.
- **Venue:** —
- **Abstract:** Since the advent of Large Language Models (LLMs), various research based on such models have maintained significant academic attention and impact, especially in AI and robotics. In this paper, we propose a multi-agent framework with LLMs to construct an integrated system for robotic task analysis, mechanical design, and path generation. The framework includes three core agents: Task Analyst, Robot Designer, and Reinforcement Learning Designer. Outputs are formatted as multimodal results, such as code files or technical reports, for stronger understandability and usability. To evaluate generali...

### [54] Multi-Robot Motion Planning with Diffusion Models (2025)
- **Authors:** Shaoul, Yorai; Mishani, Itamar; Vats, Shivam; Li, Jiaoyang et al.
- **Venue:** —
- **Abstract:** Diffusion models have recently been successfully applied to a wide range of robotics applications for learning complex multi-modal behaviors from data. However, prior works have mostly been confined to single-robot and small-scale environments due to the high sample complexity of learning multi-robot diffusion models. In this paper, we propose a method for generating collision-free multi-robot trajectories that conform to underlying data distributions while using only single-robot data. Our algorithm, Multi-robot Multi-model planning Diffusion (MMD), does so by combining learned diffusion mode...

### [55] Text to Robotic Assembly of Multi Component Objects using 3D Generative AI and Vision Language Models (2025)
- **Authors:** Kyaw, Alexander Htet; Gupta, Richa; Shah, Dhruv; Sinha, Anoop et al.
- **Venue:** —
- **Abstract:** Advances in 3D generative AI have enabled the creation of physical objects from text prompts, but challenges remain in creating objects involving multiple component types. We present a pipeline that integrates 3D generative AI with vision-language models (VLMs) to enable the robotic assembly of multi-component objects from natural language. Our method leverages VLMs for zero-shot, multi-modal reasoning about geometry and functionality to decompose AI-generated meshes into multi-component 3D models using predefined structural and panel components. We demonstrate that a VLM is capable of determi...

### [56] eFlesh: Highly customizable Magnetic Touch Sensing using Cut-Cell Microstructures (2025)
- **Authors:** Pattabiraman, Venkatesh; Huang, Zizhou; Panozzo, Daniele; Zorin, Denis et al.
- **Venue:** —
- **Abstract:** If human experience is any guide, operating effectively in unstructured environments -- like homes and offices -- requires robots to sense the forces during physical interaction. Yet, the lack of a versatile, accessible, and easily customizable tactile sensor has led to fragmented, sensor-specific solutions in robotic manipulation -- and in many cases, to force-unaware, sensorless approaches. With eFlesh, we bridge this gap by introducing a magnetic tactile sensor that is low-cost, easy to fabricate, and highly customizable. Building an eFlesh sensor requires only four components: a hobbyist 3...

### [57] Electrofluidic fiber muscles (2026)
- **Authors:** Afsar, O. K.; Pupillo, G.; Vitucci, G.; Babatain, W. et al.
- **Venue:** Science Robotics
- **Abstract:** Actuators are to robots what muscles are to humans. They enable motion and determine strength and dexterity. The fiber form factor makes skeletal muscles modular, scalable, and densely integrated (50% of human body weight). In contrast, servo motors that drive today’s robots lack the flexibility and modularity of muscle fibers, limiting integration and dexterity. Here, we report electrofluidic fiber muscles, soft artificial muscles for robotic applications with power density comparable to skeletal muscles (50 watts per kilogram), contraction strains of 20%, and response time of 0.3 second. The...

---

## Collection: Policy Learning (4 items)

### [1] Agile legged locomotion in reconfigurable modular robots ()
- **Authors:** —
- **Venue:** —

### [2] Bio-Inspired Distributed Neural Locomotion Controller (D-NLC) for Robust Locomotion and Emergent Behaviors ()
- **Authors:** Zhang, Zhikai; Guo, Siqi; Kou, Henry; Shikhare, Ishayu et al.
- **Venue:** —
- **Abstract:** Despite having fewer neurons than more complex life forms, insects are still capable of producing astonishing locomotive behaviors, such as traversing diverse environments and making rapid gait adaptations after extreme injury or autotomy. Biologists attribute this to a chain of segmental neuron clusters (ganglia) within insect nervous systems, which act as distributed self-organizing sensorimotor control units. Inspired by the neural structure of the Carausius morosus, the common stick insect, this work introduces the Distributed Neural Locomotion Controller (D-NLC), a modular control framewo...

### [3] Modular Robot Design Optimization with Generative Adversarial Networks (2022)
- **Authors:** Hu, Jiaheng; Whitman, Julian; Travers, Matthew; Choset, Howie
- **Venue:** 2022 International Conference on Robotics and Automation (ICRA)
- **Abstract:** Modular robots are made up of a set of components which can be configured and reconfigured to form customized robots for a wide range of tasks. Fully utilizing the flexibility of modular robots is challenging, as it requires the identification of optimal modular designs for each given task, often with limited computation and time. Previous works in design automation achieve efficient run-times by utilizing machine learning to create a one-to-one mapping from task to design. However, the problem of robot design is often multimodal, where multiple distinct designs can be similarly or equally goo...

### [4] Learning Modular Robot Control Policies (2023)
- **Authors:** Whitman, Julian; Travers, Matthew; Choset, Howie
- **Venue:** IEEE Transactions on Robotics
- **Abstract:** Modular robots can be rearranged into a new design, perhaps each day, to handle a wide variety of tasks by forming a customized robot for each new task. However, reconfiguring just the mechanism is not sufficient: each design also requires its own unique control policy. One could craft a policy from scratch for each new design, but such an approach is not scalable, especially given the large number of designs that can be generated from even a small set of modules. Instead, we create a modular policy framework where the policy structure is conditioned on the hardware arrangement, and use just o...
