Sheen-Cao/Ballooance/doc/thesis_Milestone_1.pdf

# Milestone 1

Checkbox

# Breathing Intelligence: Morphological Computation in Inflatable Robot Systems

Sheen Cao

Advisors: Daragh Byrne, Paul Pangaro

## Context and background

Dialectics conceptual mapping (principles)

Milestone 1 | 1

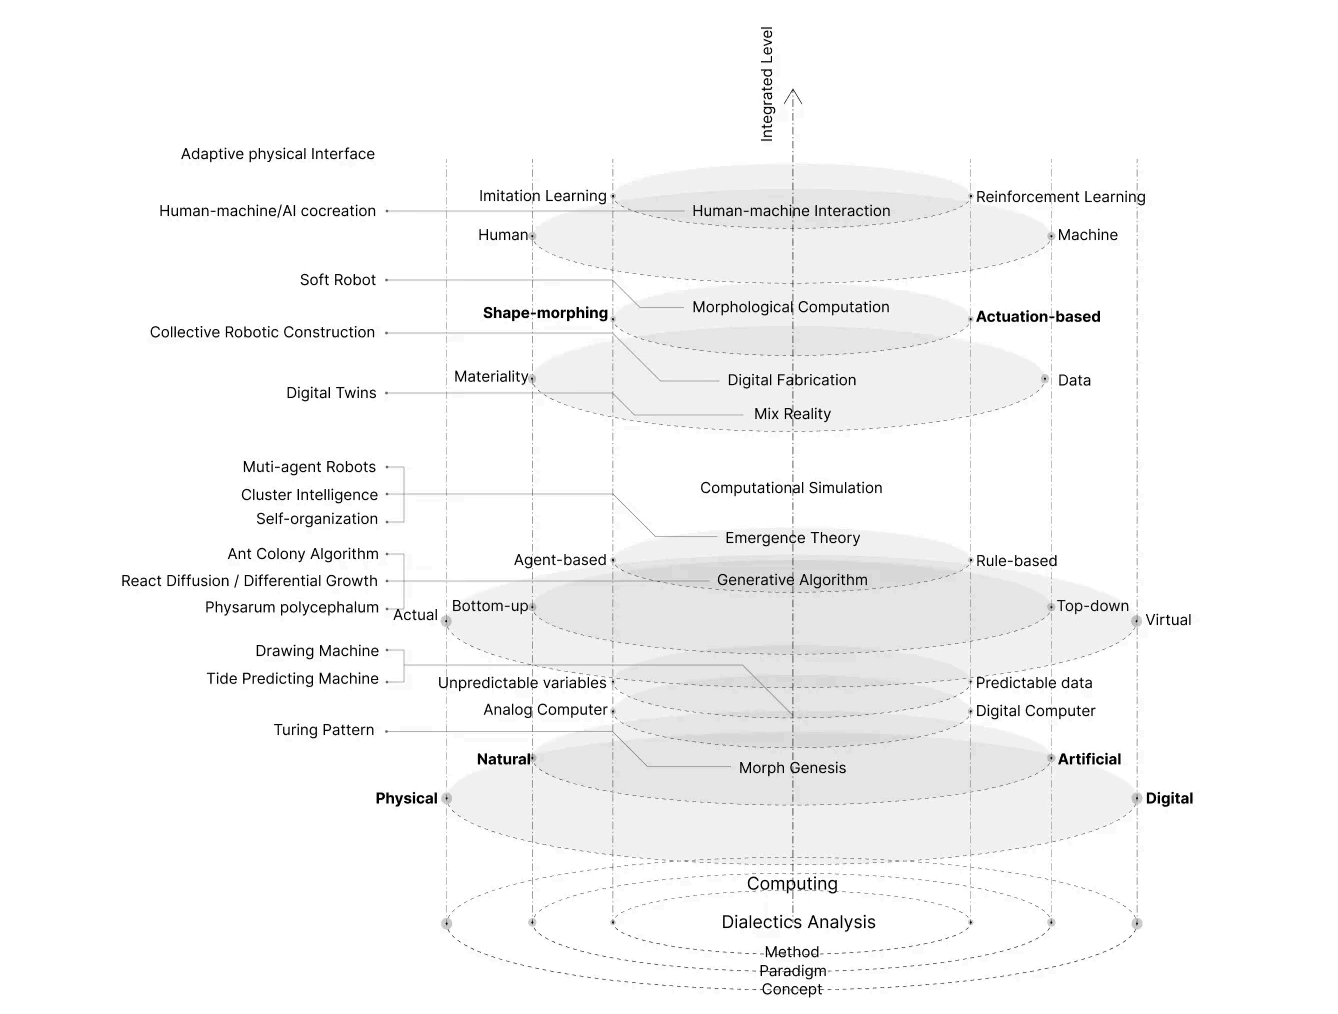
[picture p26: figure]

### Impact Model

Robot —— Behavior

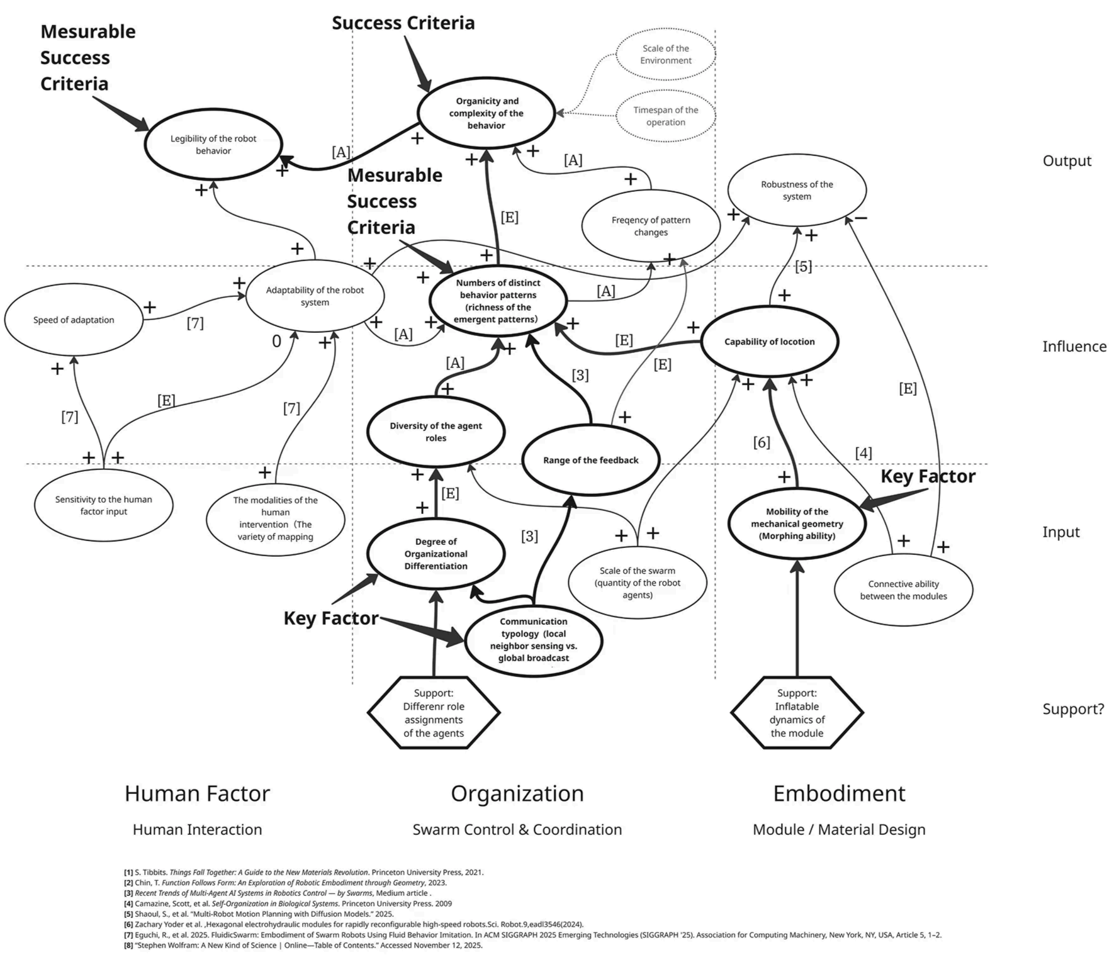
[picture p27: figure]

Factor clusters — From the center to the peripheral

Exploration steps

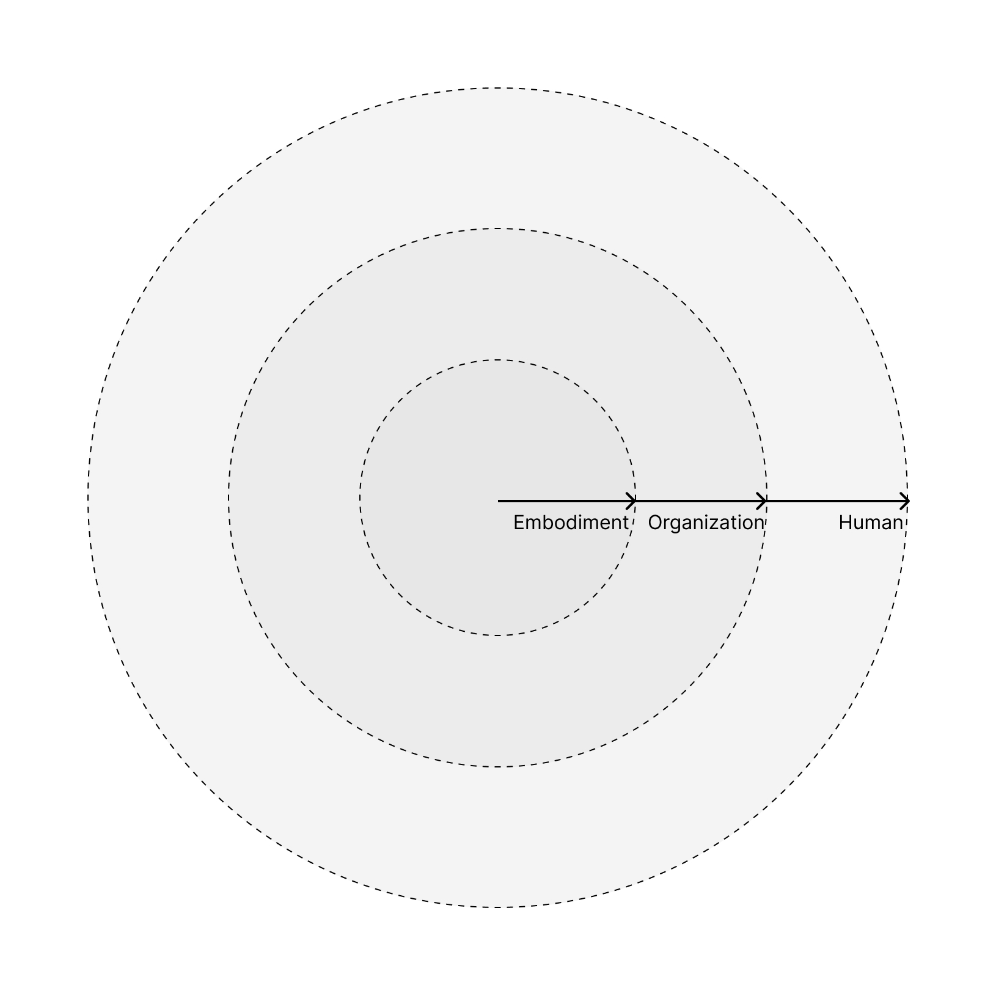
[picture p28: figure]

## Research Questions:

High Level:

Take the soft robot as the “site”, research on the process from simplicity to complexity, from the single to the plural…

Implemental:

How to design a modular robot system that can locomote by deforming?

How to coordinate/control the robot system to enrich the behavior patterns?

Not problem-driven but more experiment oriented?

——>The experiment that I have been working on.

## Simulation as an initial validation

### Low fidelity simulation in Blender:

1. Overall robot module
design:
2. Shape-changing mechanism

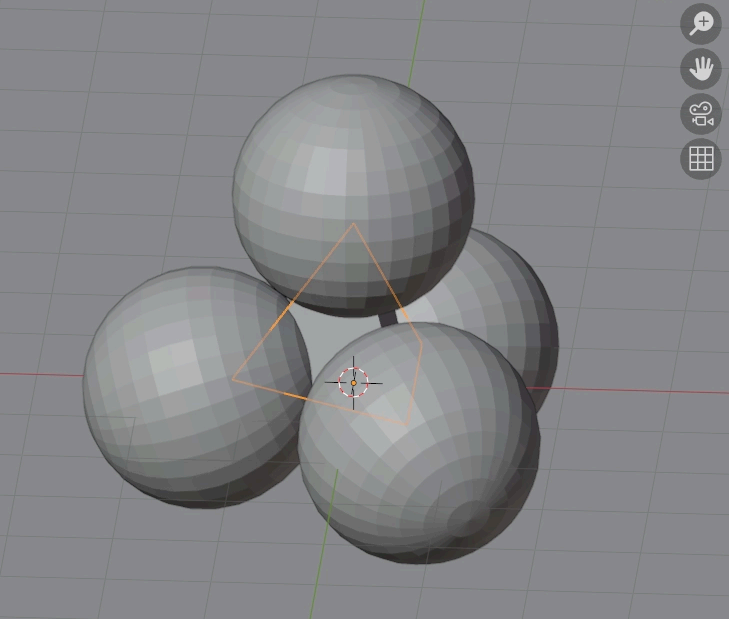
[picture p29: figure]

## Variables to play with

The geometry of the core

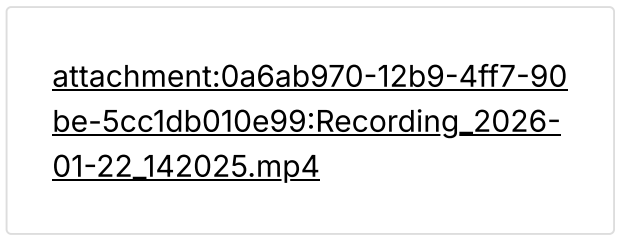
[picture p30: figure]
attachment:0a6ab970-12b9-4ff7-90 be-5cc1db010e99:Recording_2026- 01-22_142025.mp4

How many inflatable modules can be combined - the core connector can be tetrahedron, cube, etc.

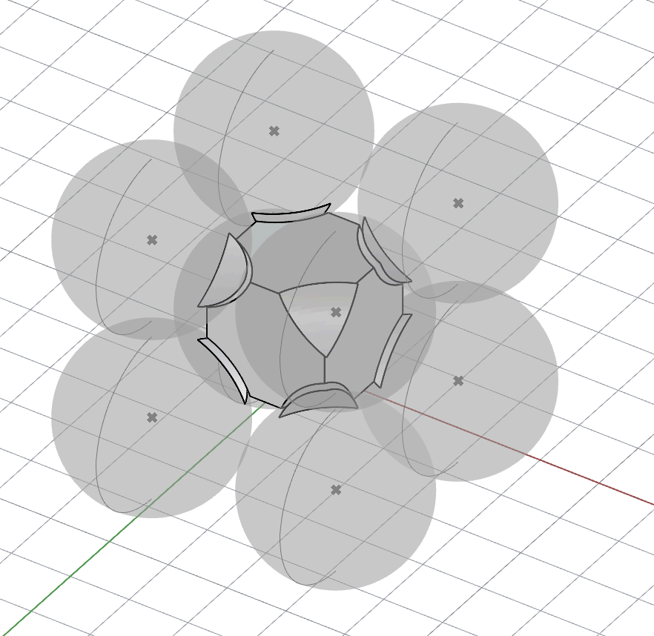
[picture p31: figure]

Shape-changing control mechanism


Learning based or timesteps/speed of the deflating and inflating, phase difference between the inflatable patches - now the demo using sine function to control the changing phases

Configurability (connections conditions)

reconfigurable structure - multiple units can be connected to each other opening up the space for different types of movement and behavior.

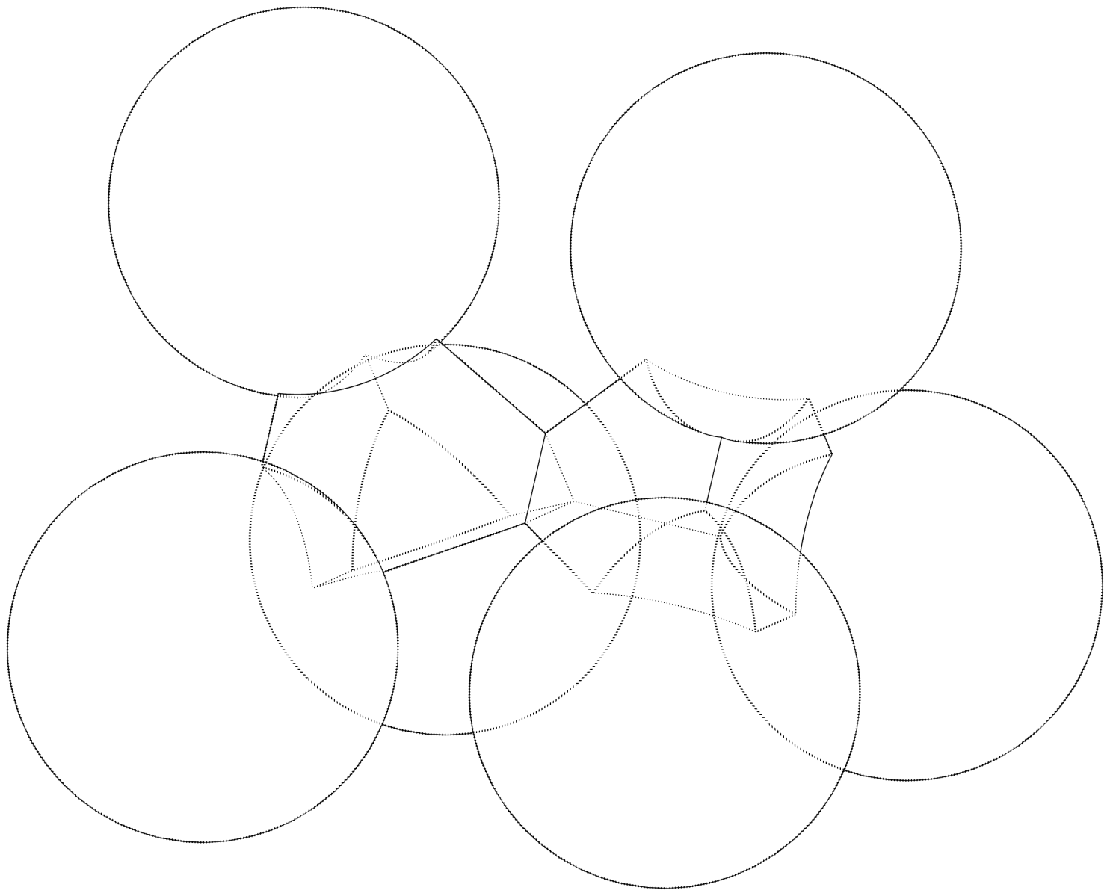
[picture p32: figure]

Weight

Balancing states - liquid pumped into different sections can change the center of the gravity.

Scale

How large the module can be?

Material

The material such as silicone gel or polyethylene plastics has unique attributes that can contribute to the deforming process of the inflatable shape-changing parts.

## Physical Prototype

### Structure Design

inflatable modular holder plate:

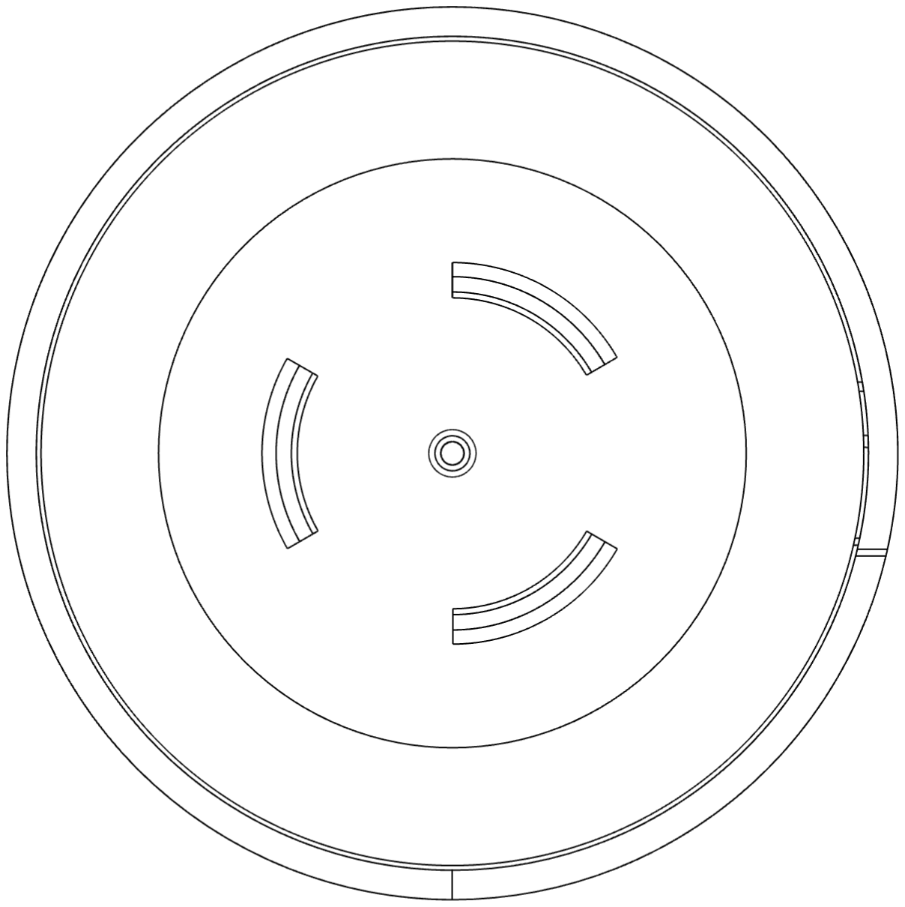
[picture p33: figure]
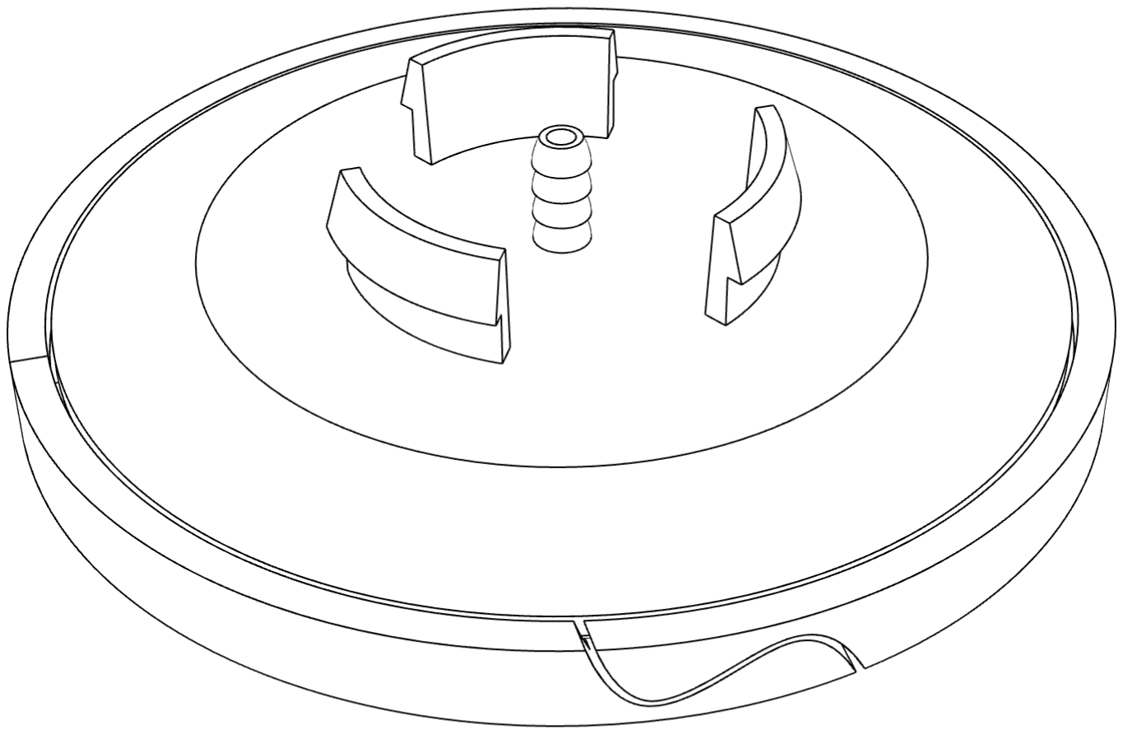
[picture p34: figure]

Snap Fit Joint Design:

https://www.clarwe.com/blog/g to-snap-fit-joints-typesdesign-andmanufacturing.html (https://www.clarwe.com/blog/guide-to-snap-fit-joints-types-design-and-manufacturing.html)

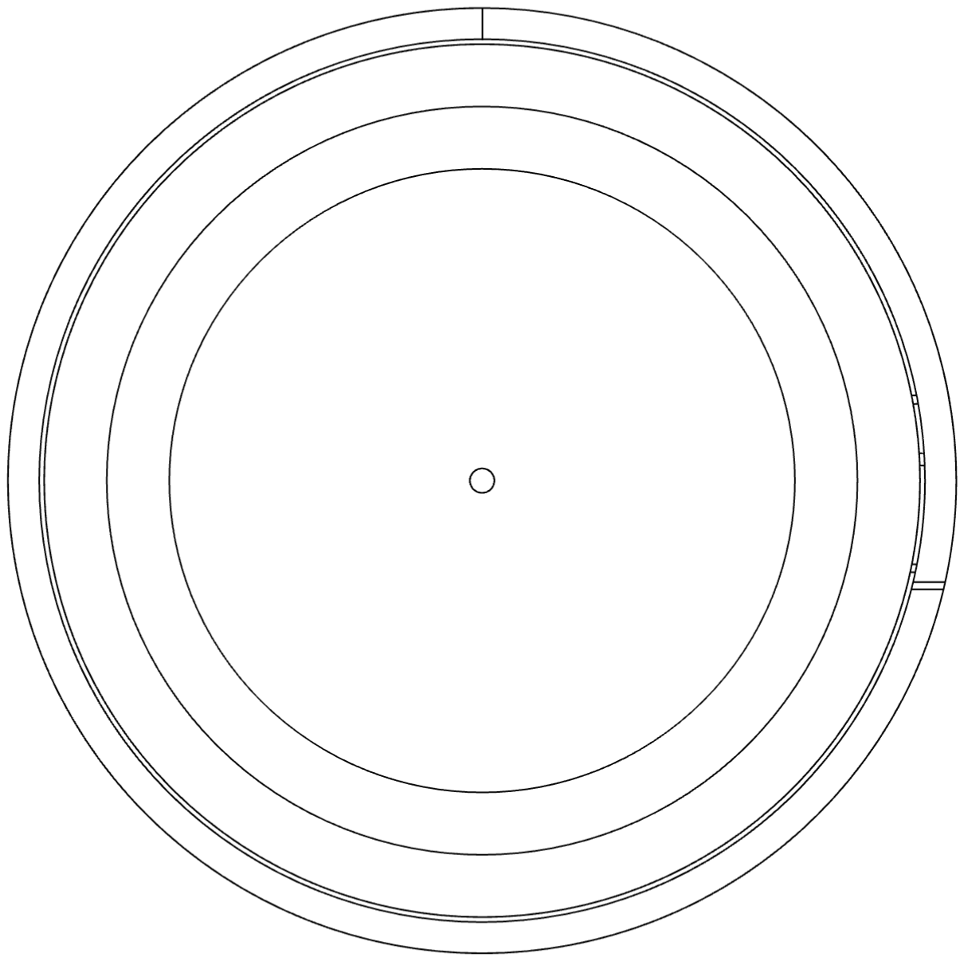
[picture p35: figure]
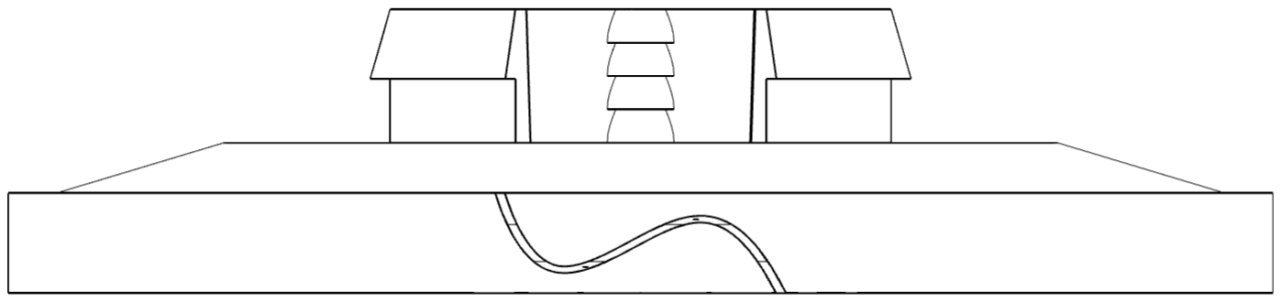
[picture p36: figure]

https://hackaday.io/project/173560/logssort=newest&page=2 (https://hackaday.io/project/173560/logs?sort=newest&page=2)

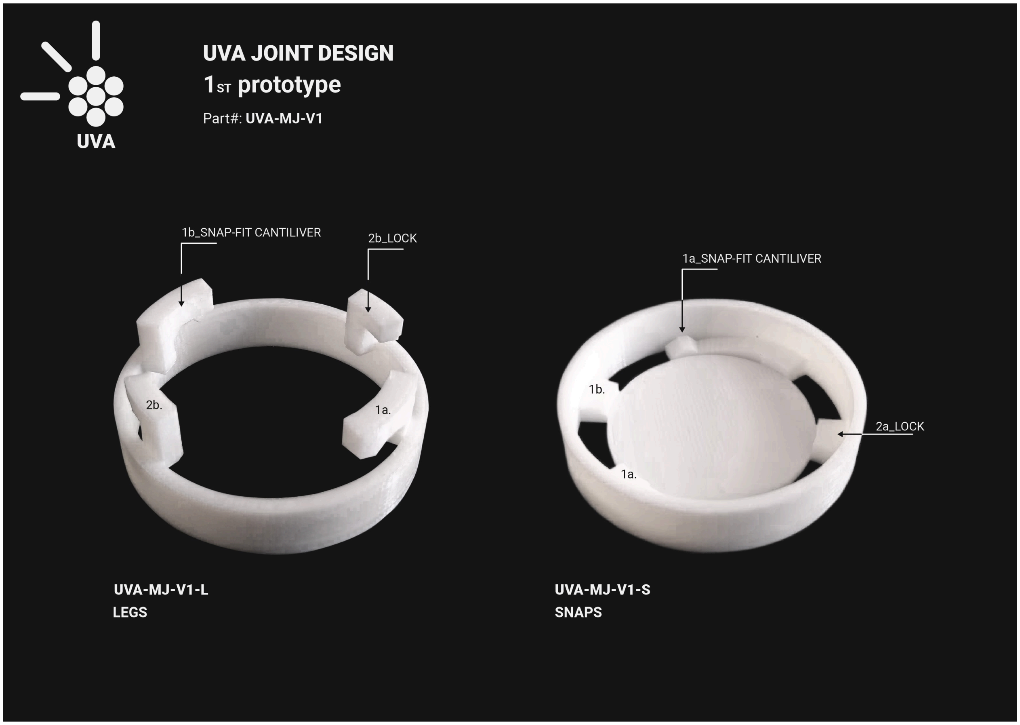
[picture p37: figure]

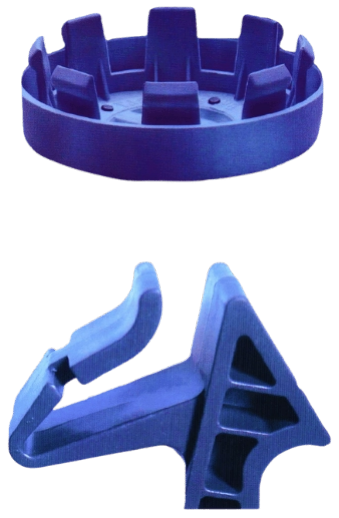
[picture p38: figure]

https://www.madearia.com/blog/snap-fit-design/

https://www.china-machining.com/blog/snap-fit-design-101/

Asembled structure example:

Removable
modular design

Asembled structure example:

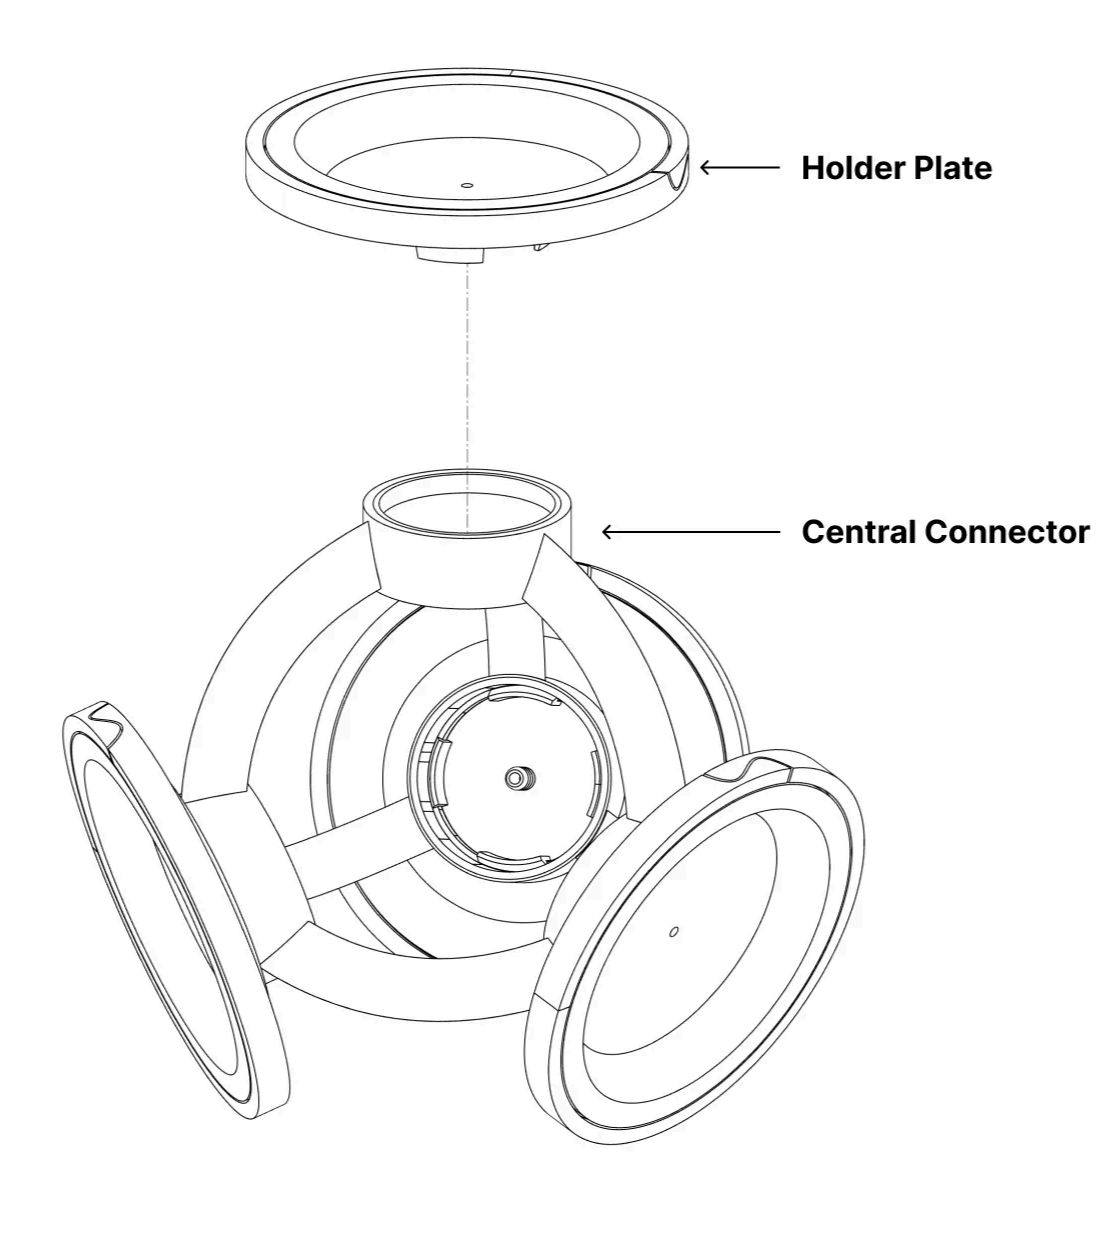
[picture p39: figure]

Removable
modular design

allowing
developing
components
separately

allowing
developing
components
separately

### Preliminary findings:

1. There exists a maximum size the balloon can reach - the maximum inflated scale of the balloon compared to the whole skeleton
2. Active vacuum or
passive leaking -
deflating speed
without additional
active suction

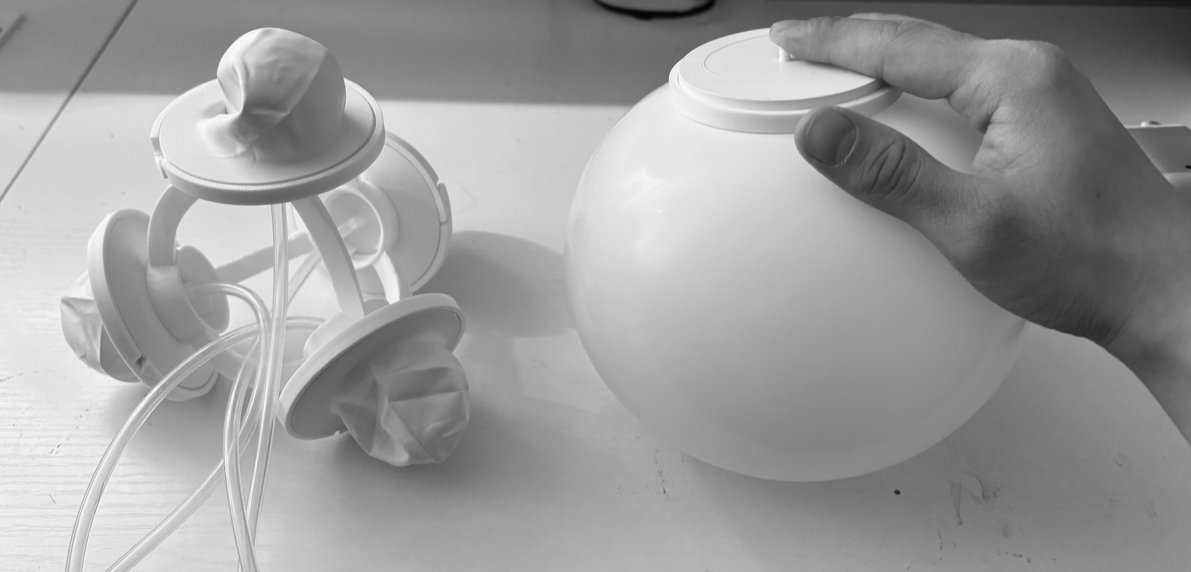
[picture p40: figure]

attachment:737a
d729-b0a6-46c
d-9d28-15a562e
e5fed:IMG_8364.
mov (https://www.notion.so/signed/attachment%3A737ad729-b0a6-46cd-9d28-15a562ee5fed%3AIMG_8364.mov?table=block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)

### Problem Findings:

1. Sealing problem - the air is easy to leak out on the edge and the tube connector
Solution or the 3d printed shell has some tiny unnoticeable cracks if it is too thin
2. Uneven inflating speed - fast in the beginning and gets slower proportionally as it inflates.
The time needed to reach the maximum size is around 40s.

attachment:786080be-72
9b-4b2f-b3ae-66157b16a
9d1:IMG_8445.mov (https://www.notion.so/signed/attachment%3A786080be-729b-4b2f-b3ae-66157b16a9d1%3AIMG_8445.mov?table=block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)

attachment:93b65a47-7a
5a-40f2-b2ab-1cb578bb9
a83:IMG_8450.mov (https://www.notion.so/signed/attachment%3A93b65a47-7a5a-40f2-b2ab-1cb578bb9a83%3AIMG_8450.mov?table=block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)

## Iteration

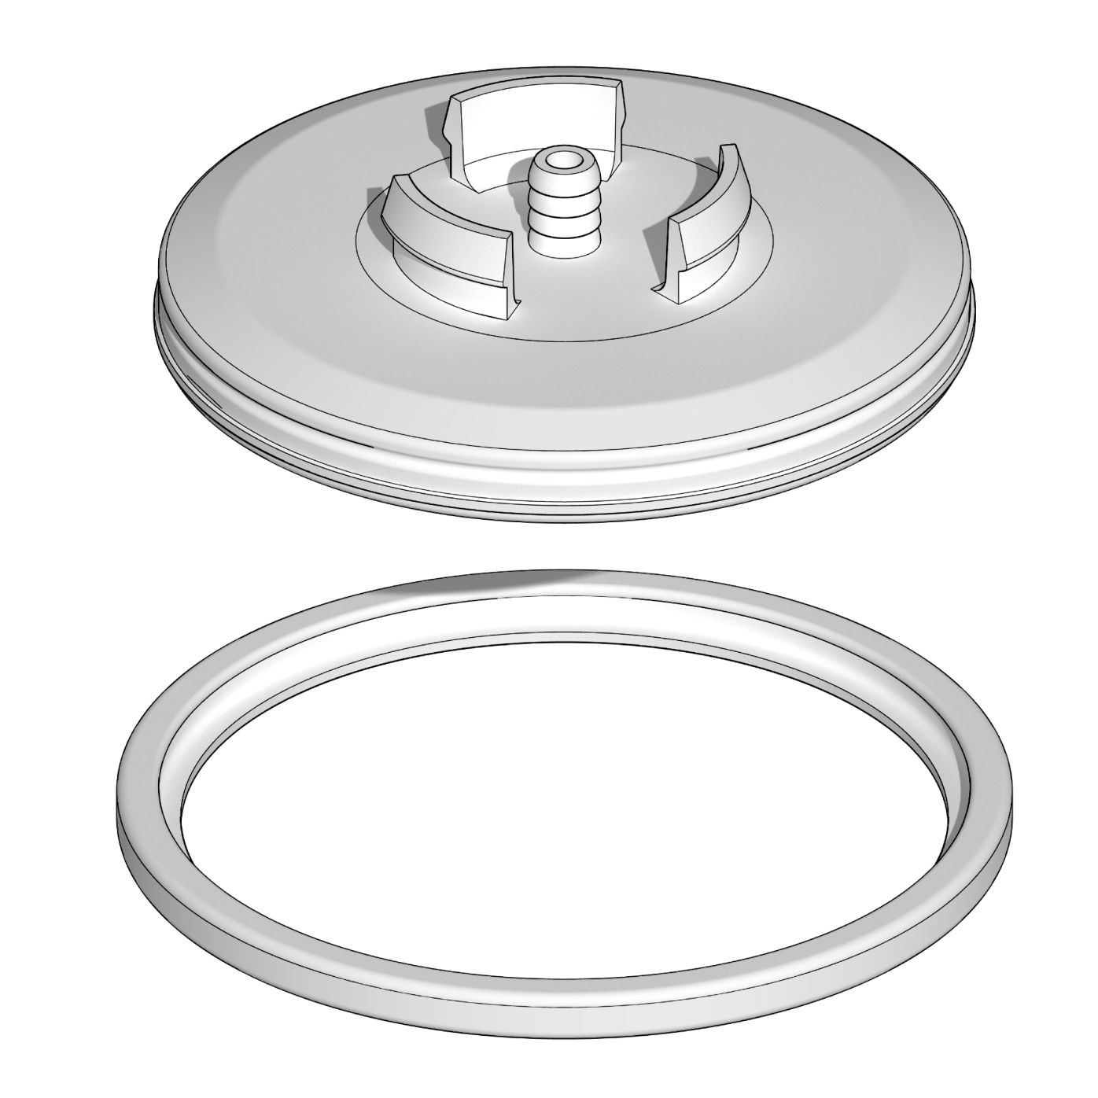
[picture p41: figure]
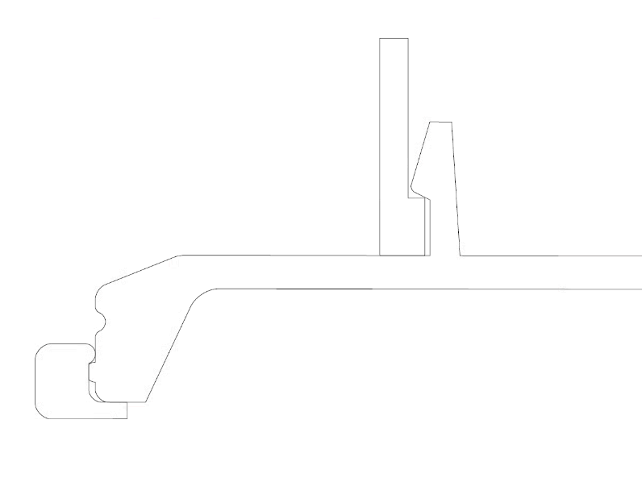
[picture p42: figure]

Snap fit joint - from ring to cap | Better air tightness

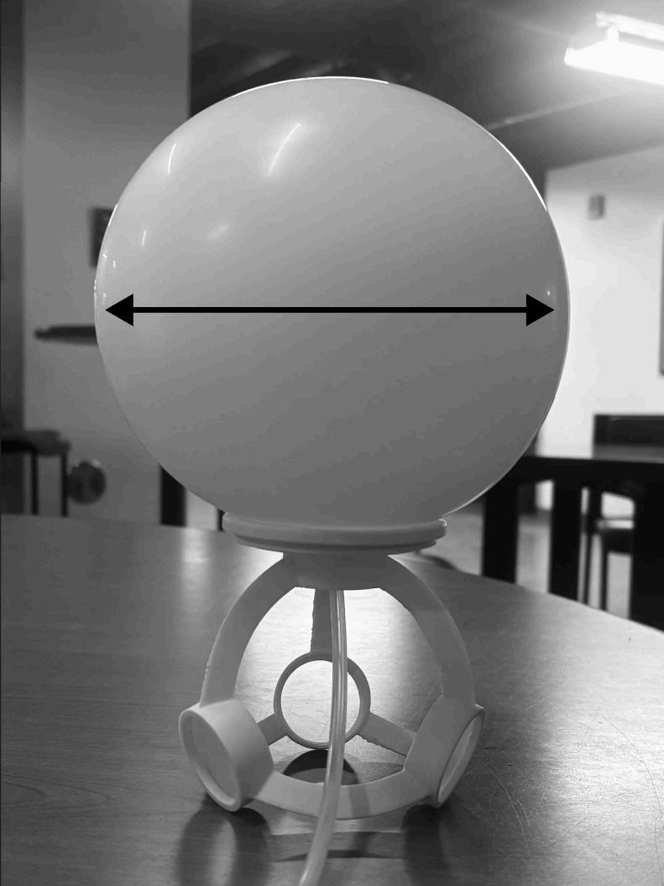
[picture p43: figure]

Wriggle or Flip:

Vectors of the expanding - Horizontal expanding matters more than the vertical for flipping
(The size proportion between the central connector and the maximum inflated size.)

Internal balance:

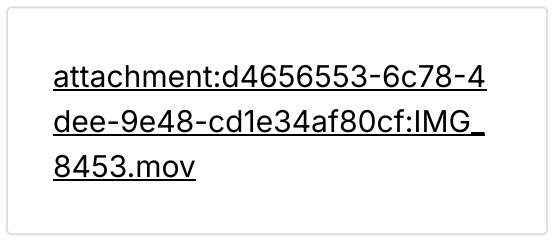
[picture p44: figure]
attachment:d4656553-6c78-4 dee-9e48-cd1e34af80cf:IMG_ 8453.mov

The balloon has a tipping point. At the beginning, the rubber resists expansion and requires additional energy to stretch. Once one balloon passes this tipping point, it becomes easier for it to expand further.

As a result, the airflow follows the path of least resistance and preferentially flows into the balloon that has already expanded past the tipping point.

—Breathing Intelligence?

—Separate the air tubing channels to eliminate the influences?

### Next Steps:

1. Go back to the simulation with higher fidelity to test out the different scale proportions of the inflatable modules and central structure. Verify the parameters that enable flipping gait.
2. Add constraint onto the inflatable module - morphological structure and shape-changing mechanism.
3. On-board vs. off-board

### Questions:

Any other variables in this inflatable robot system you think I missed or value to experiment on?

Balloon, which is made out of elastic material (latex), has inflatable capacity, can be considered as a material and physic-based computational unit. By defining, controlling the connectability, constraints, the system ha

Hypothesis:
By controlling or setting up different connect
