Sheen-Cao/Ballooance/frames_1/frame_0.00s.png

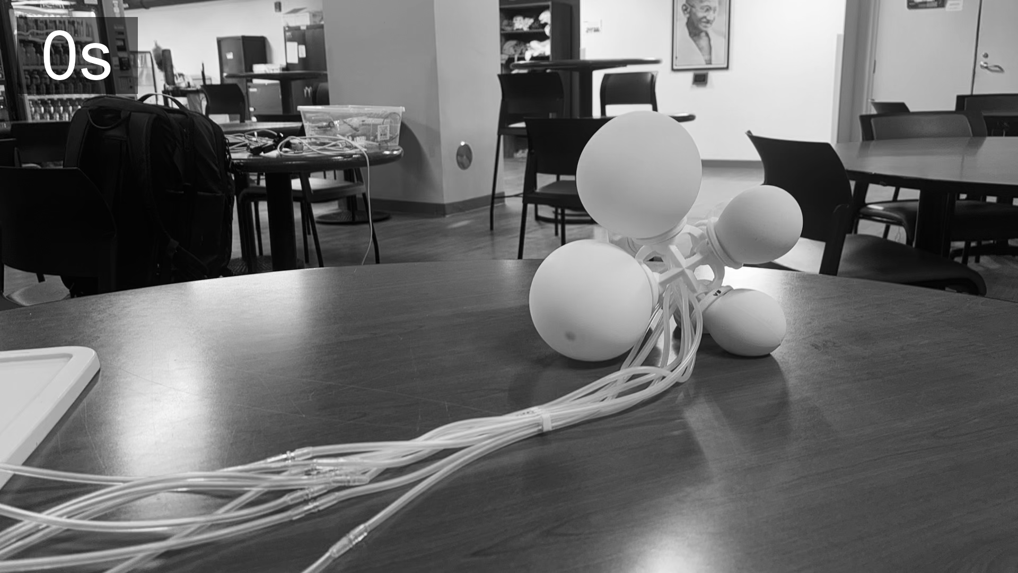
frames_1/frame_0.00s.png
