Sheen-Cao/Ballooance/frames_1/frame_15.00s.png

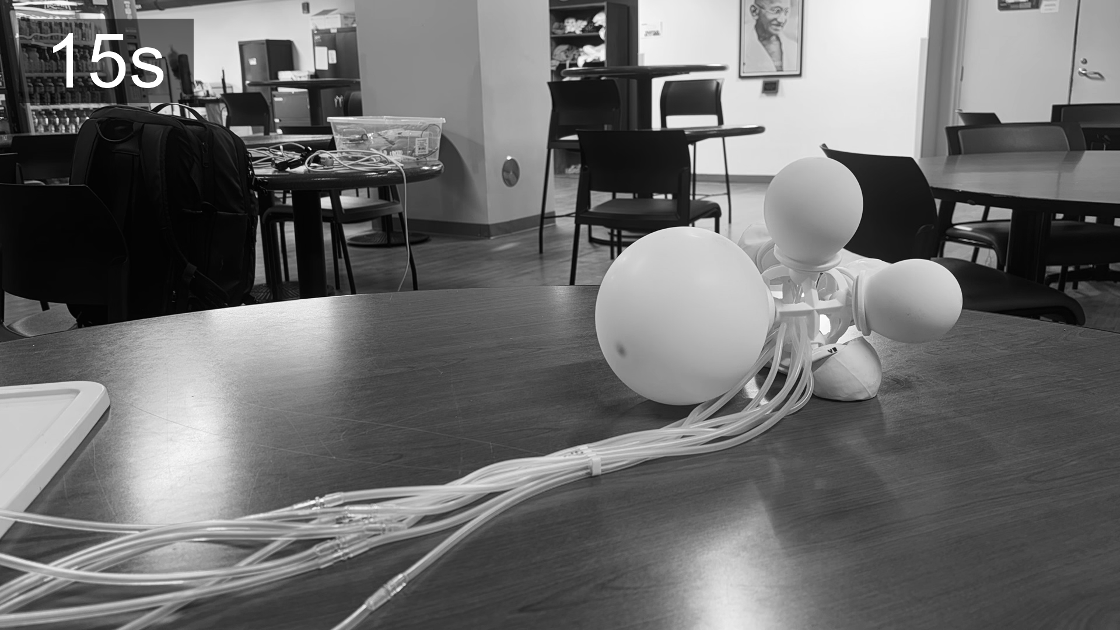
frames_1/frame_15.00s.png
