Sheen-Cao/Ballooance/frames_1/frame_30.00s.png

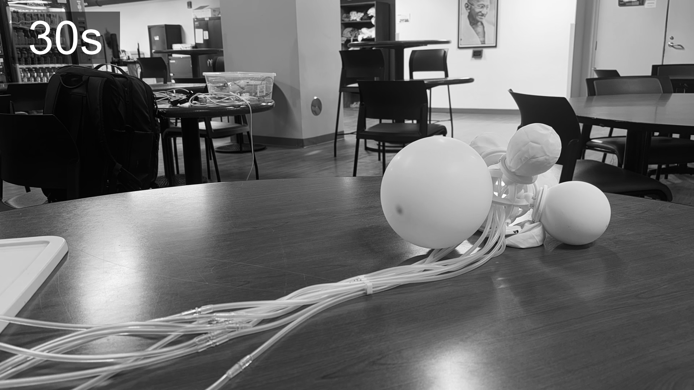
frames_1/frame_30.00s.png
