Sheen-Cao/Ballooance/frames_1/frame_60.00s.png

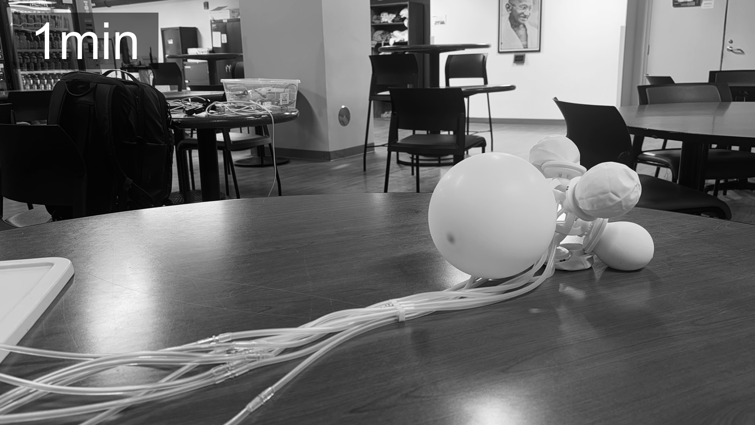
frames_1/frame_60.00s.png
