Sheen-Cao/Ballooance/frames_1/frame_75.00s.png

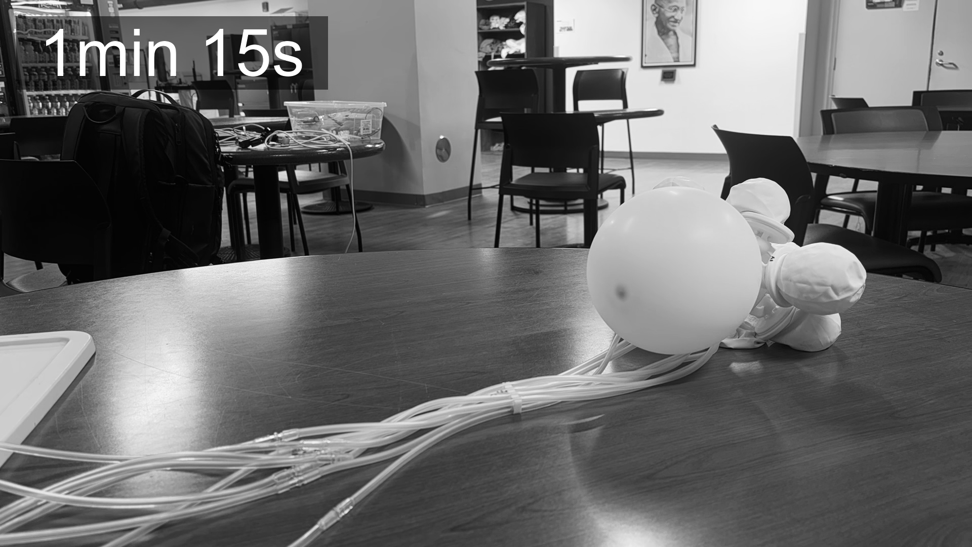
frames_1/frame_75.00s.png
