Sheen-Cao/Ballooance/frames_1/frame_165.00s.png

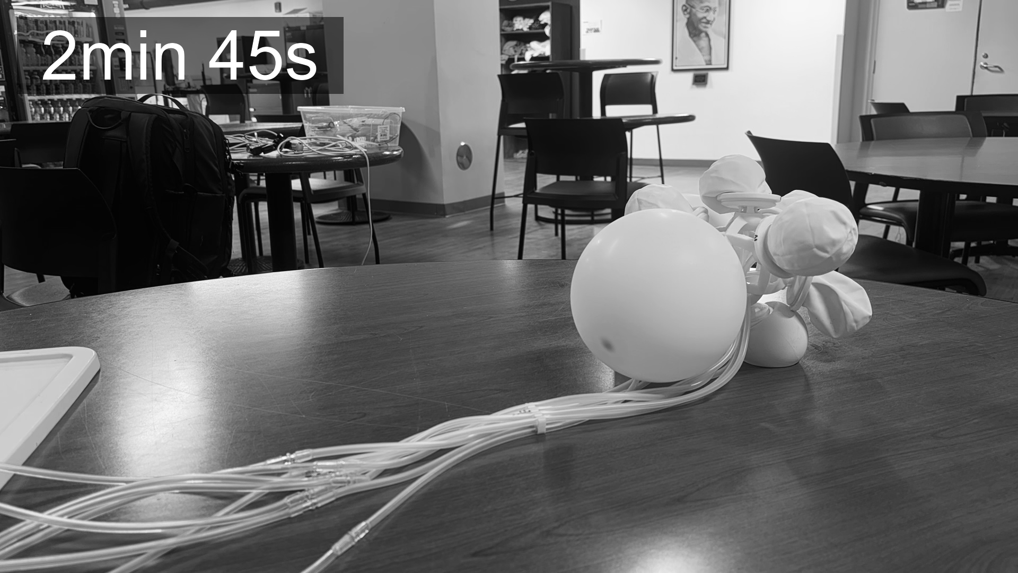
frames_1/frame_165.00s.png
