Sheen-Cao/Ballooance/frames_1/frame_210.00s.png

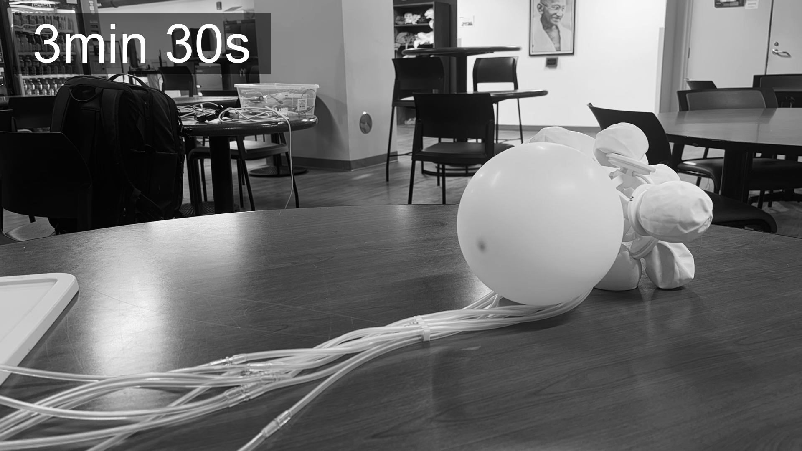
frames_1/frame_210.00s.png
