Sheen-Cao/Ballooance/frames_1/frame_225.00s.png

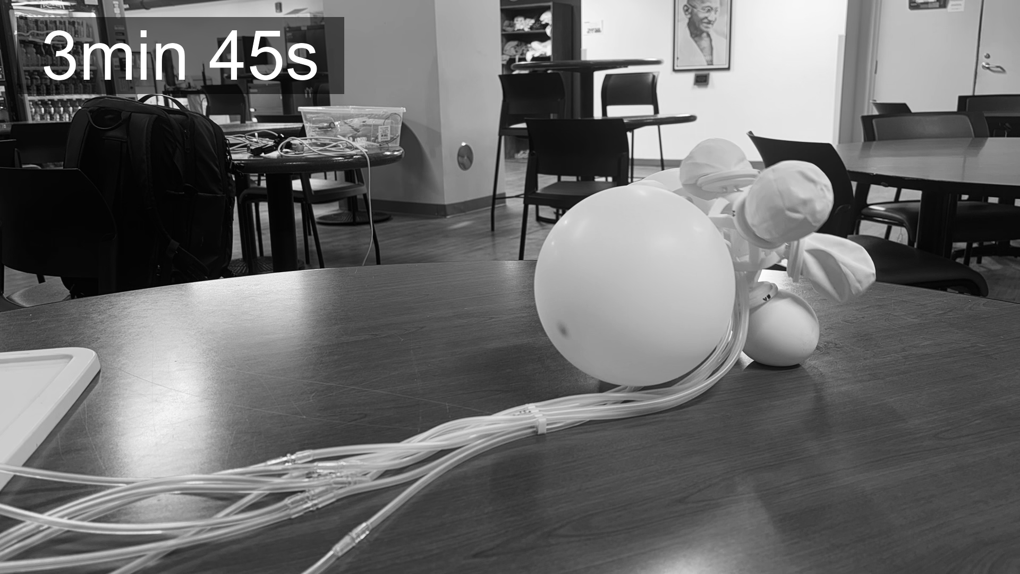
frames_1/frame_225.00s.png
