Sheen-Cao/Ballooance/frames_1/frame_240.00s.png

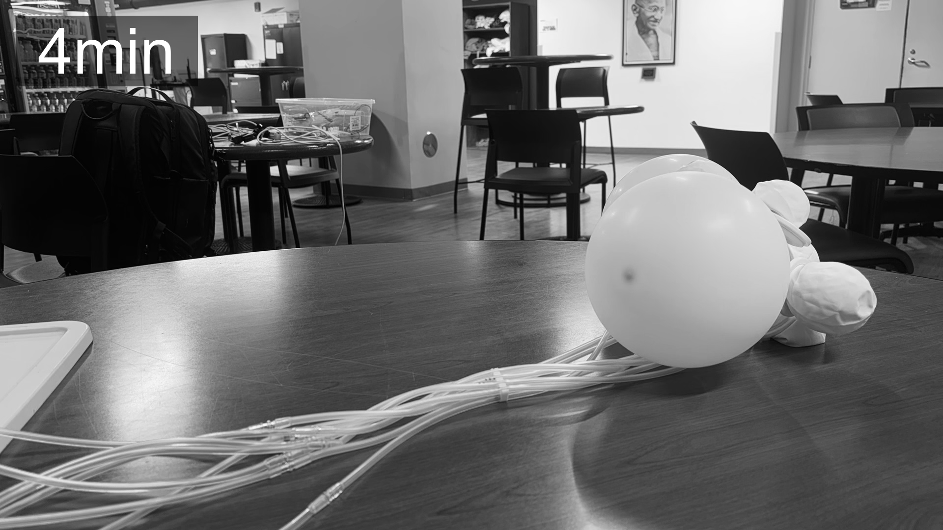
frames_1/frame_240.00s.png
