Sheen-Cao/Ballooance/frames_1/frame_270.00s.png

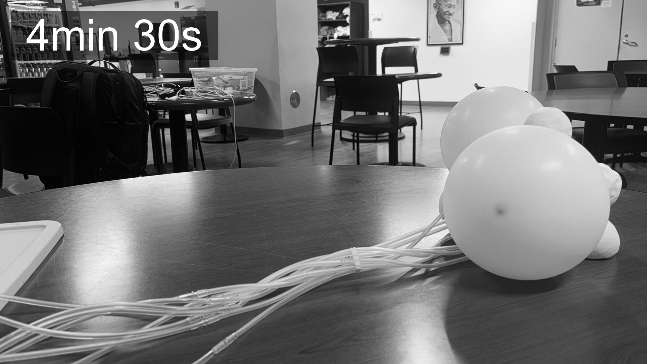
frames_1/frame_270.00s.png
