Sheen-Cao/Ballooance/frames_1/frame_300.00s.png

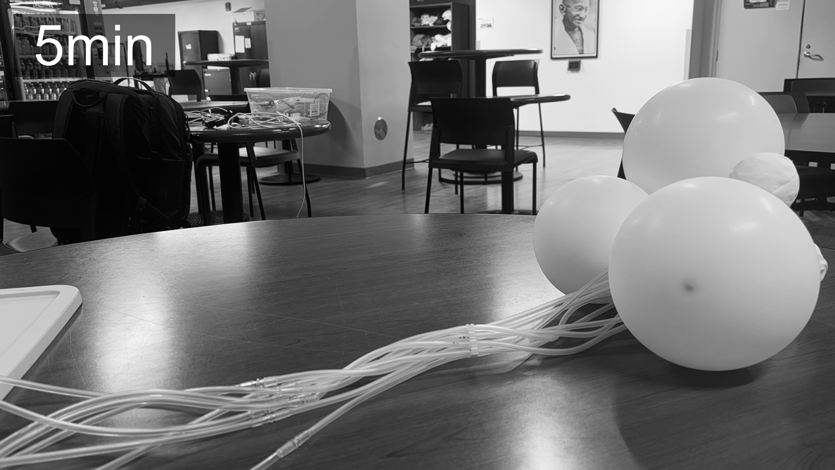
frames_1/frame_300.00s.png
