Sheen-Cao/Ballooance/frames_1/frame_330.00s.png

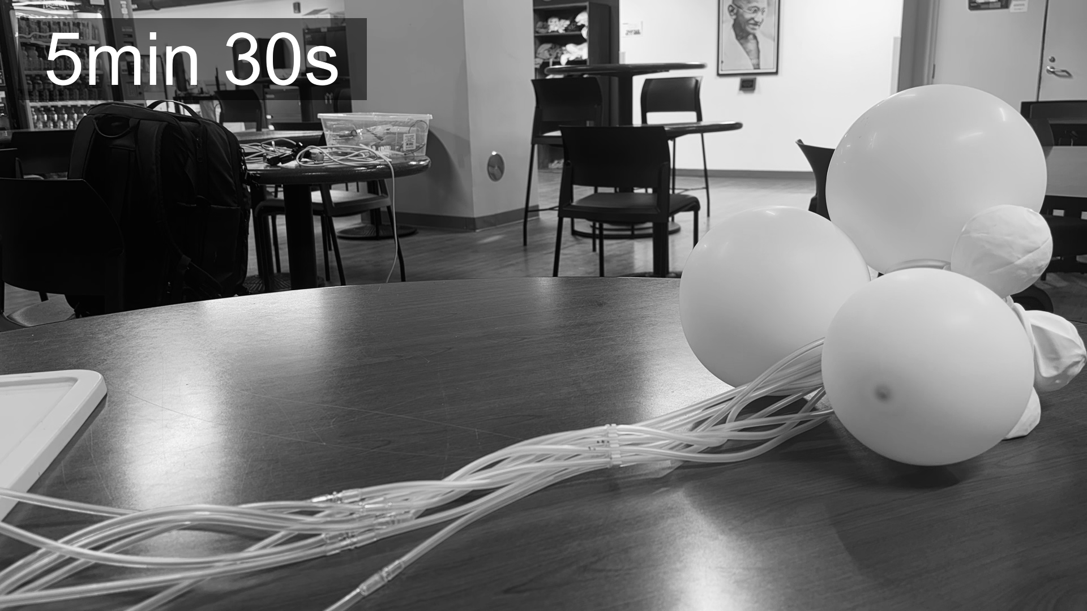
frames_1/frame_330.00s.png
