Sheen-Cao/Ballooance/frames_1/frame_345.00s.png

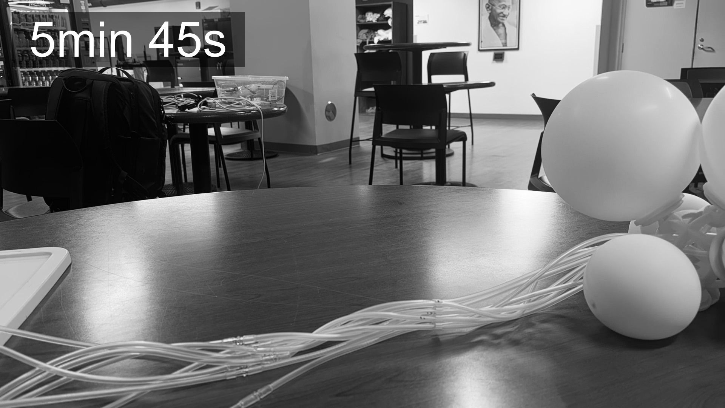
frames_1/frame_345.00s.png
