Sheen-Cao/Ballooance/frames_1/frame_360.00s.png

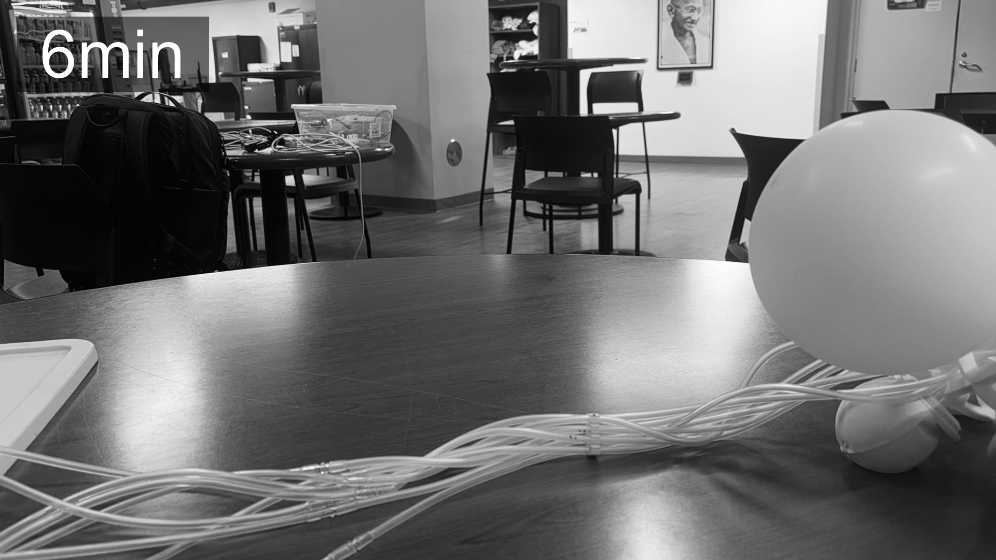
frames_1/frame_360.00s.png
