Sheen-Cao/Ballooance/frames_2/frame_0.00s.png

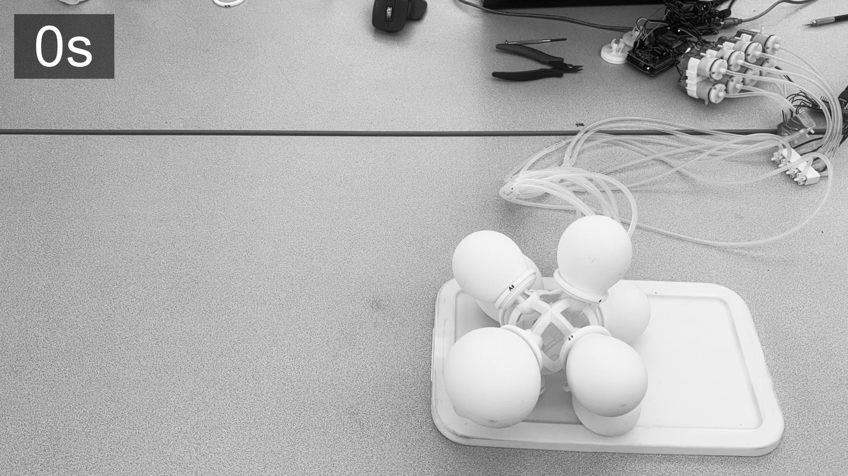
frames_2/frame_0.00s.png
