Sheen-Cao/Ballooance/frames_2/frame_15.00s.png

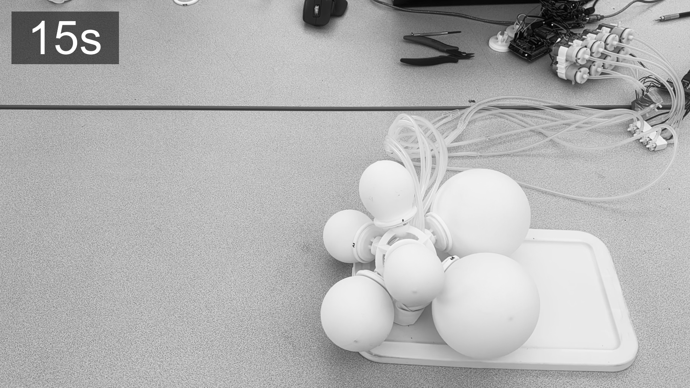
frames_2/frame_15.00s.png
