Sheen-Cao/Ballooance/frames_2/frame_30.00s.png

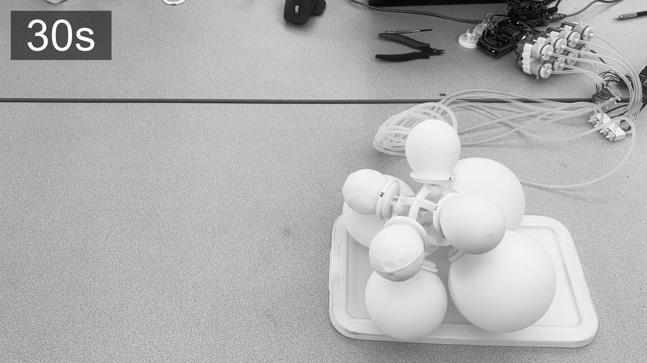
frames_2/frame_30.00s.png
