Sheen-Cao/Ballooance/frames_2/frame_45.00s.png

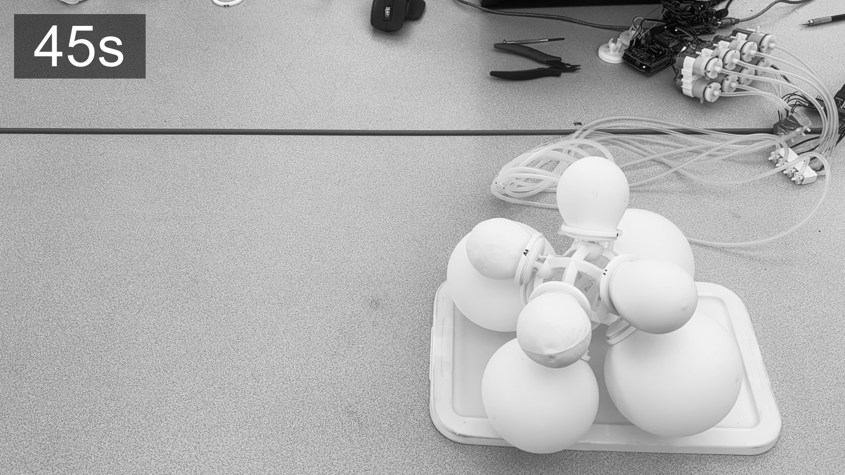
frames_2/frame_45.00s.png
