Sheen-Cao/Ballooance/frames_2/frame_60.00s.png

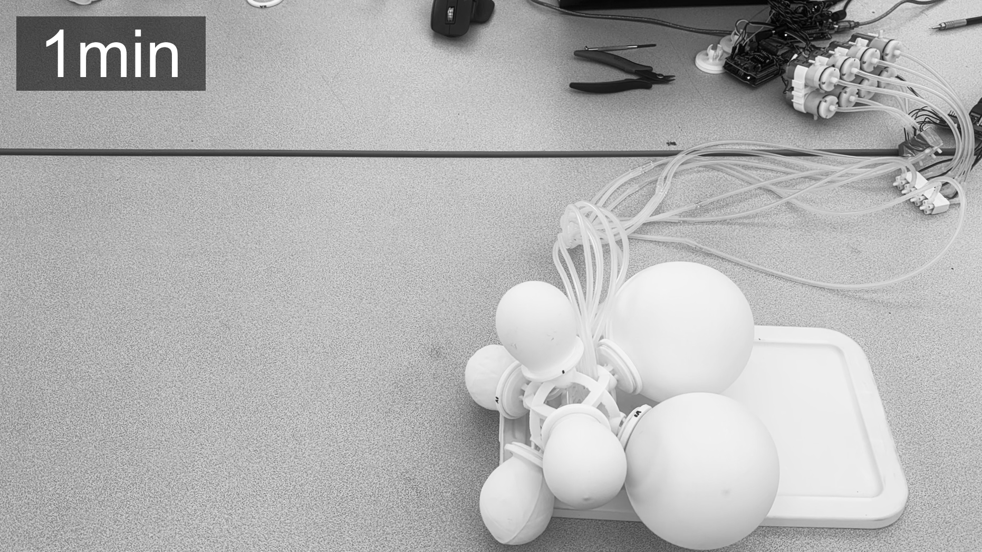
frames_2/frame_60.00s.png
