Sheen-Cao/Ballooance/frames_2/frame_75.00s.png

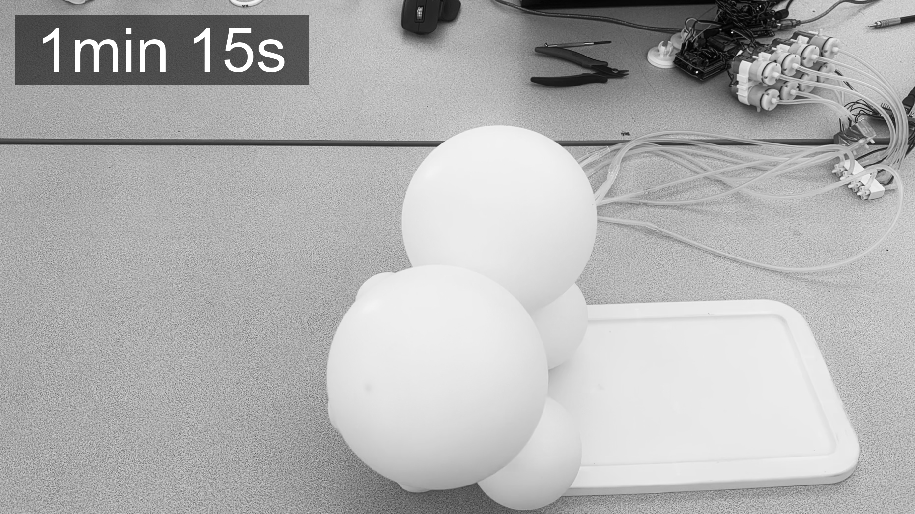
frames_2/frame_75.00s.png
