Sheen-Cao/Ballooance/frames_2/frame_90.00s.png

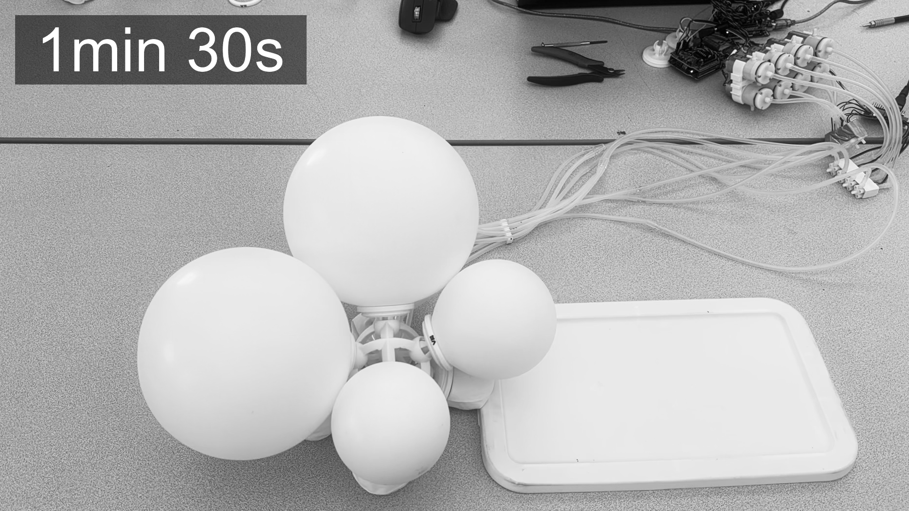
frames_2/frame_90.00s.png
