Sheen-Cao/Ballooance/frames_2/frame_105.00s.png

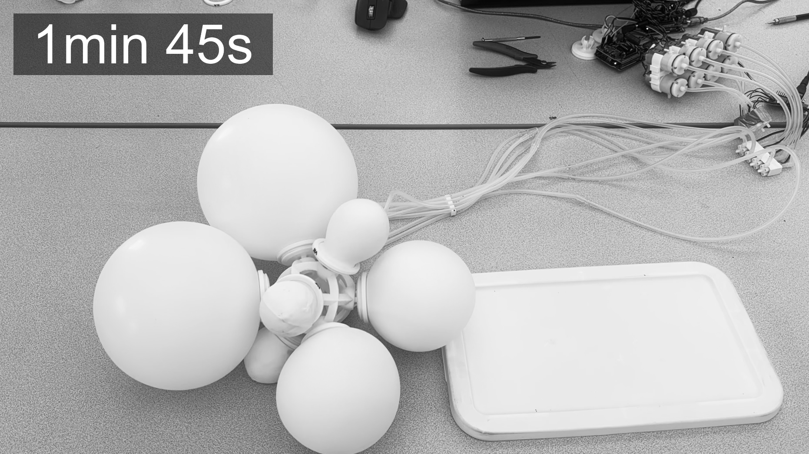
frames_2/frame_105.00s.png
