Sheen-Cao/Ballooance/frames_2/frame_120.00s.png

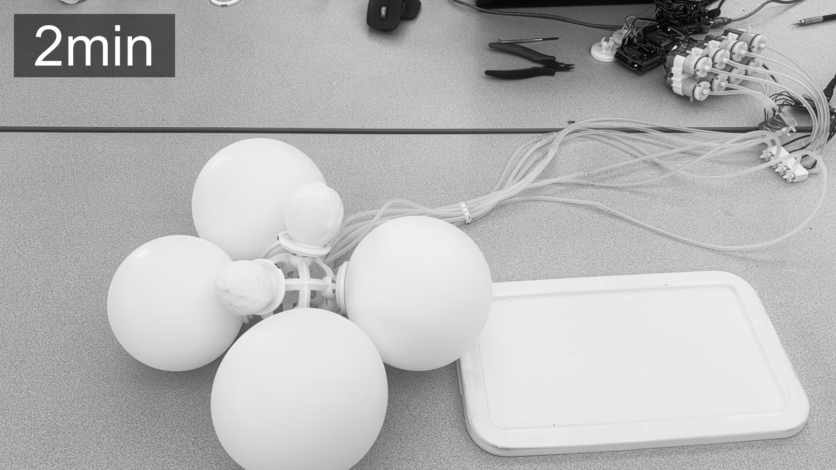
frames_2/frame_120.00s.png
