Sheen-Cao/Ballooance/frames_2/frame_135.00s.png

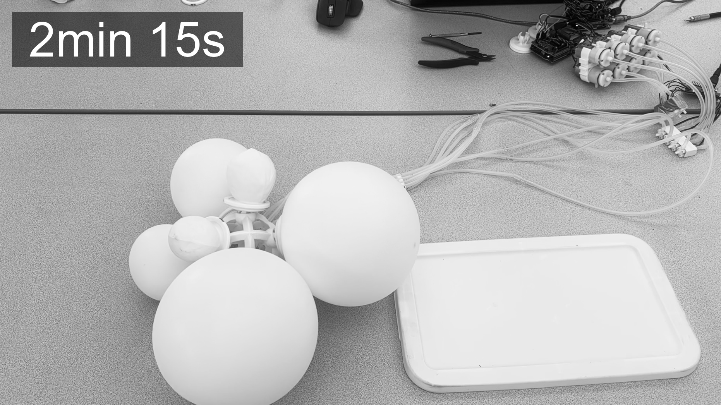
frames_2/frame_135.00s.png
