Sheen-Cao/Ballooance/frames_2/frame_150.00s.png

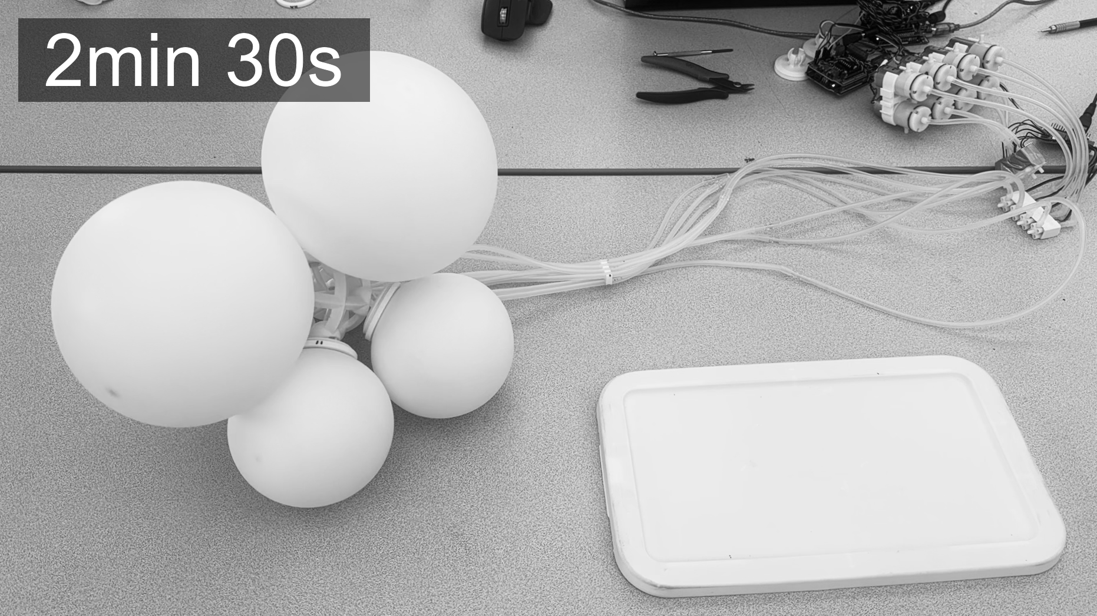
frames_2/frame_150.00s.png
