Sheen-Cao/Ballooance/frames_2/frame_165.00s.png

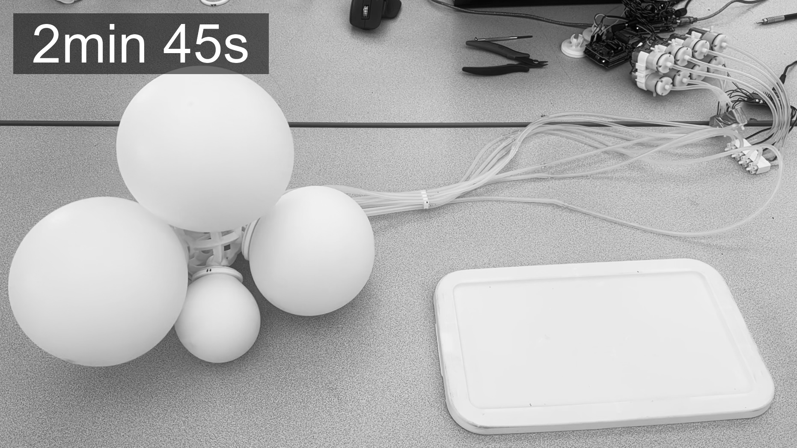
frames_2/frame_165.00s.png
