Sheen-Cao/Ballooance/frames_2/frame_180.00s.png

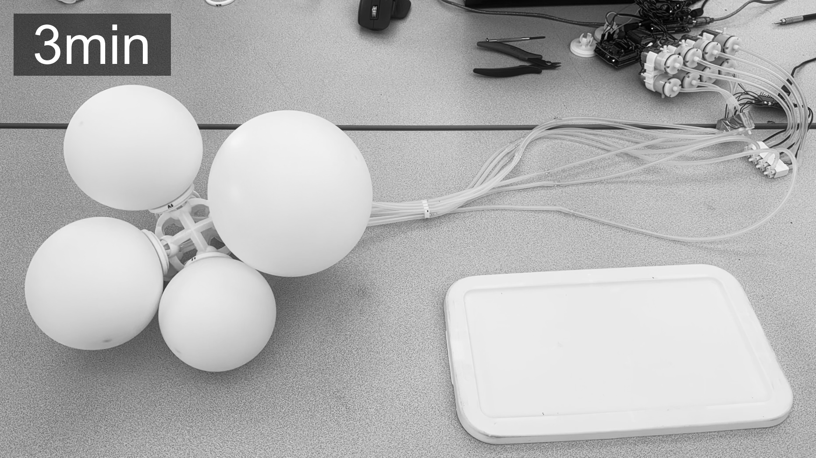
frames_2/frame_180.00s.png
