Sheen-Cao/Ballooance/frames_2/frame_195.00s.png

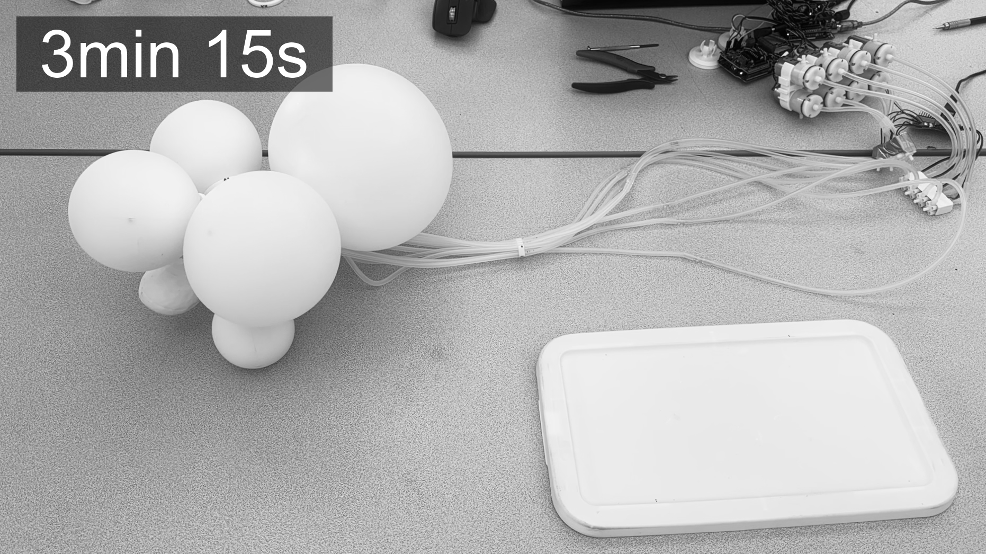
frames_2/frame_195.00s.png
