Sheen-Cao/Ballooance/frames_2/frame_210.00s.png

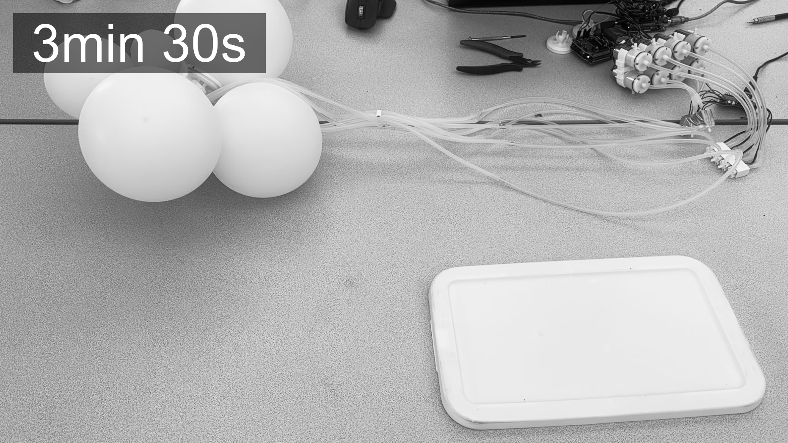
frames_2/frame_210.00s.png
