Sheen-Cao/Ballooance/frames_2/frame_225.00s.png

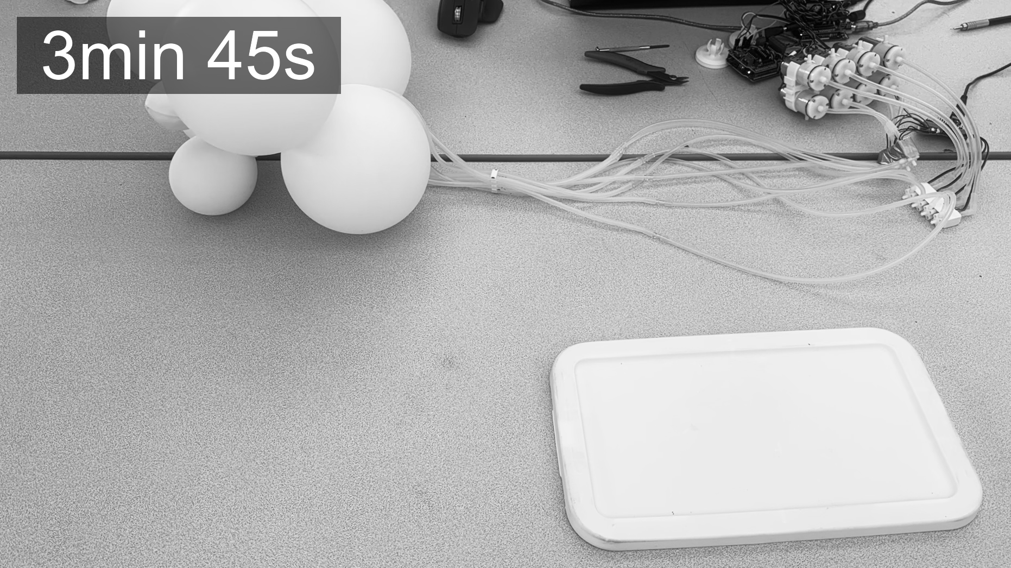
frames_2/frame_225.00s.png
