Sheen-Cao/Ballooance/frames_2/frame_240.00s.png

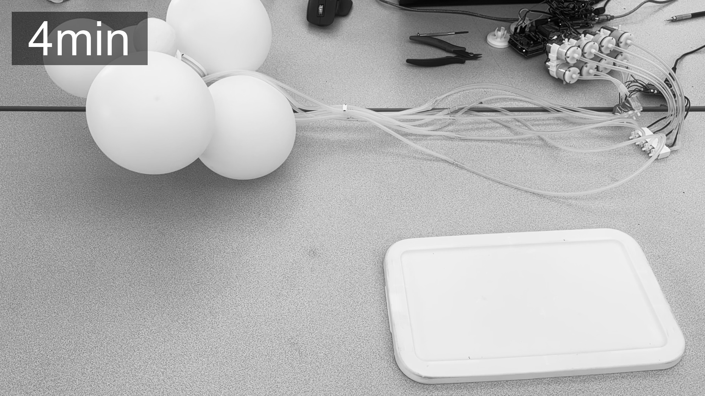
frames_2/frame_240.00s.png
