Sheen-Cao/Ballooance/frames_2/frame_300.00s.png

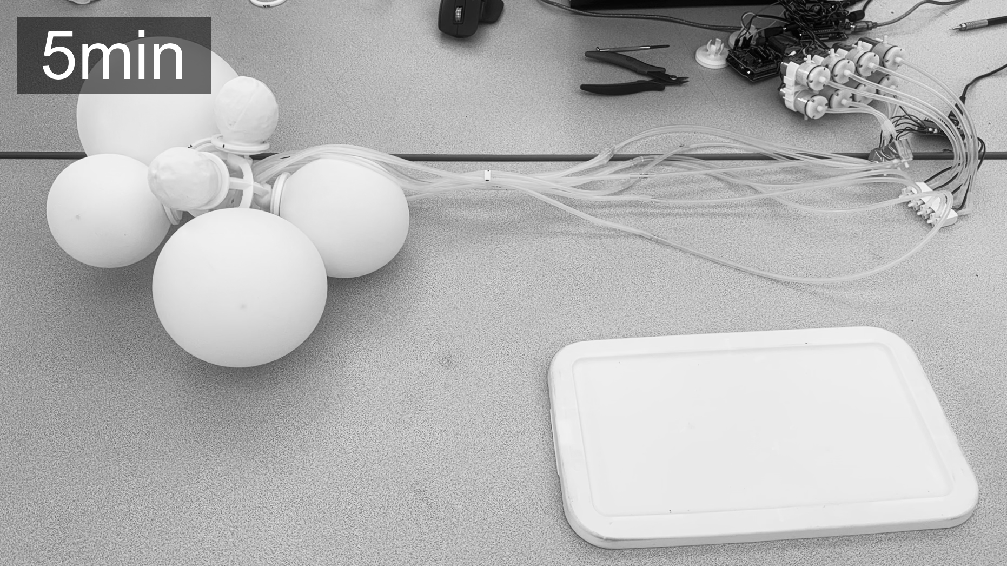
frames_2/frame_300.00s.png
