Sheen-Cao/Ballooance/frames_2/frame_315.00s.png

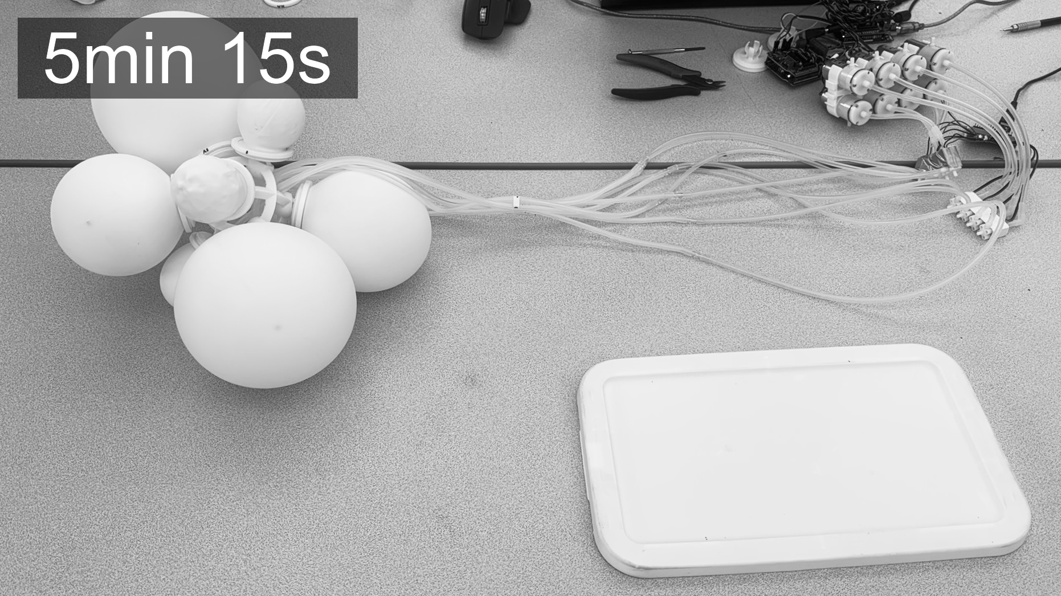
frames_2/frame_315.00s.png
