Sheen-Cao/Ballooance/frames_2/frame_330.00s.png

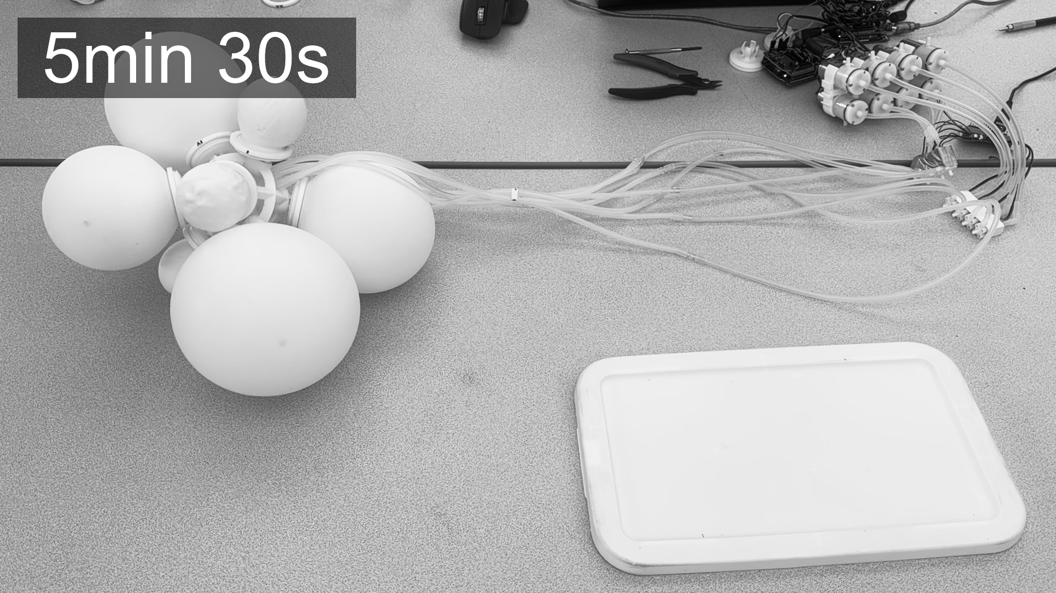
frames_2/frame_330.00s.png
