Sheen-Cao/Ballooance/frames_2/frame_345.00s.png

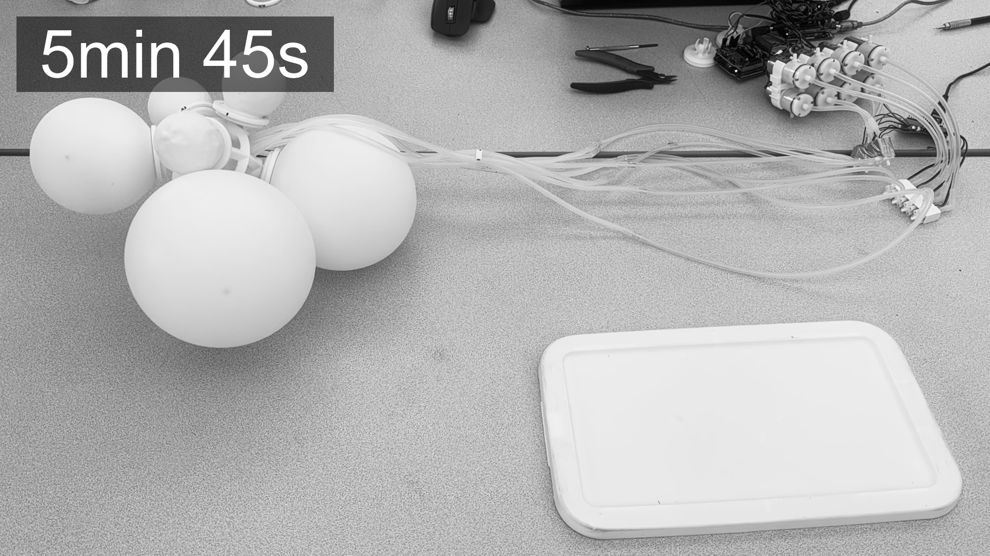
frames_2/frame_345.00s.png
