Sheen-Cao/Ballooance/frames_2/frame_360.00s.png

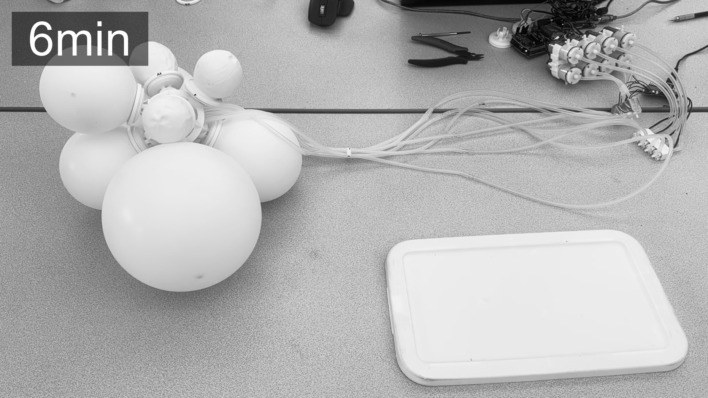
frames_2/frame_360.00s.png
