Sheen-Cao/Ballooance/Pics/4unit_st.png

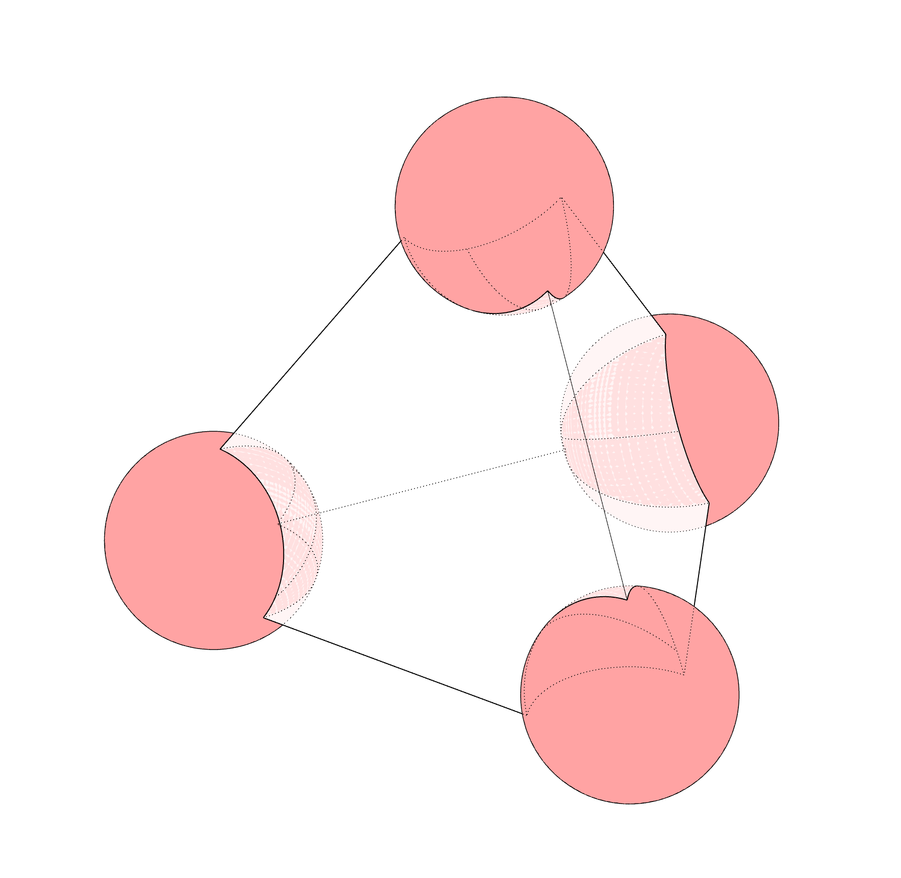
Pics/4unit_st.png
