Sheen-Cao/Ballooance/Pics/5unit_core.png

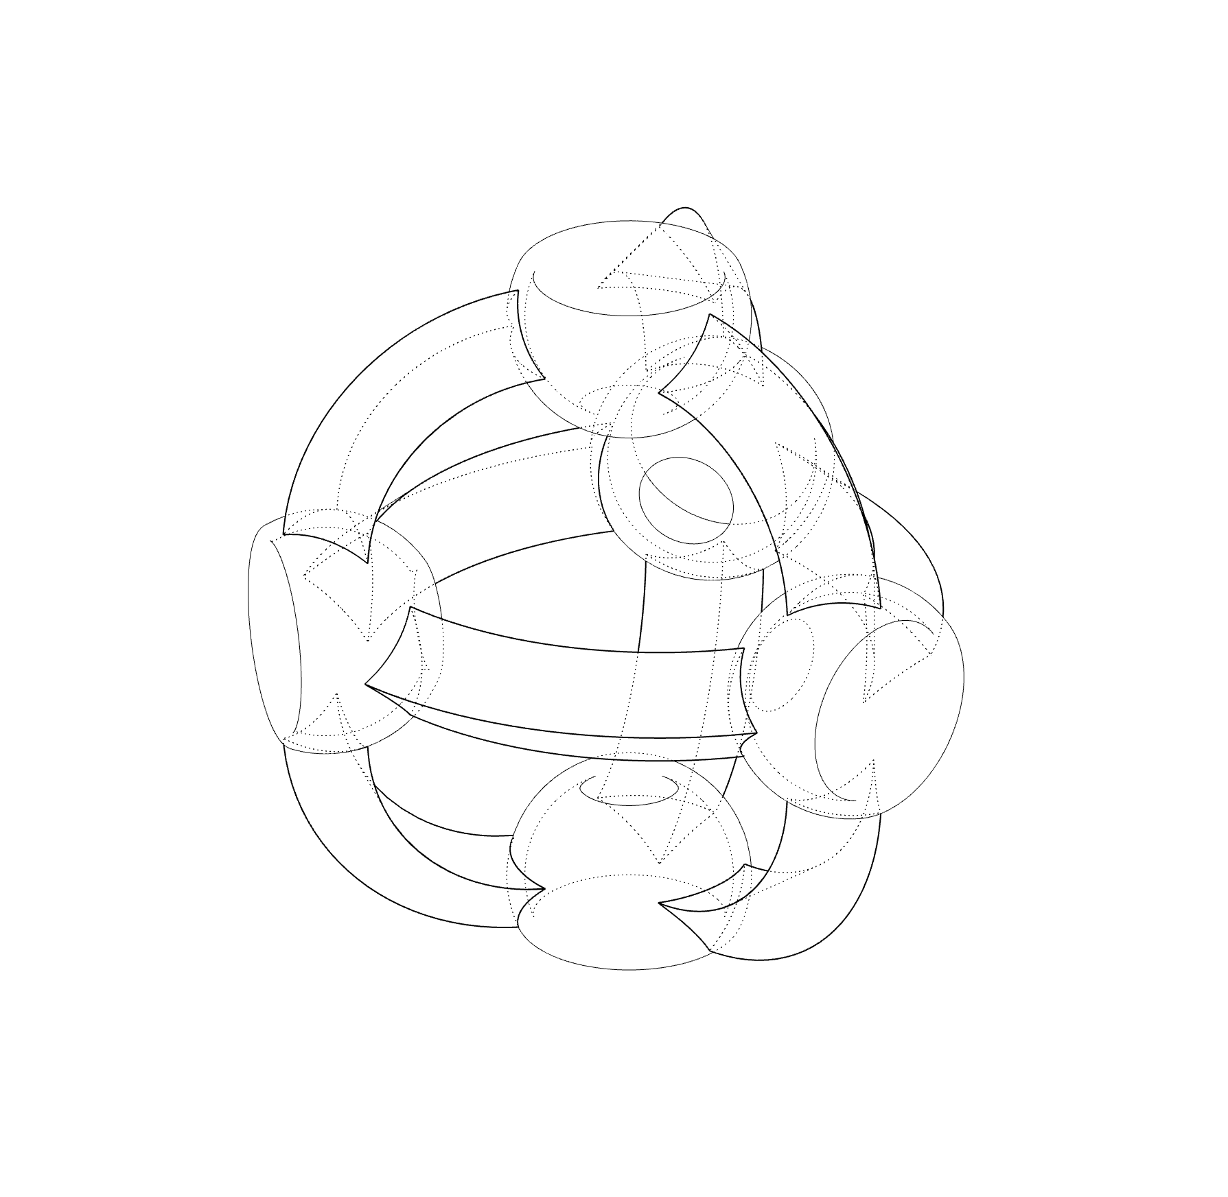
Pics/5unit_core.png
