Sheen-Cao/Ballooance/Pics/5unit_str.png

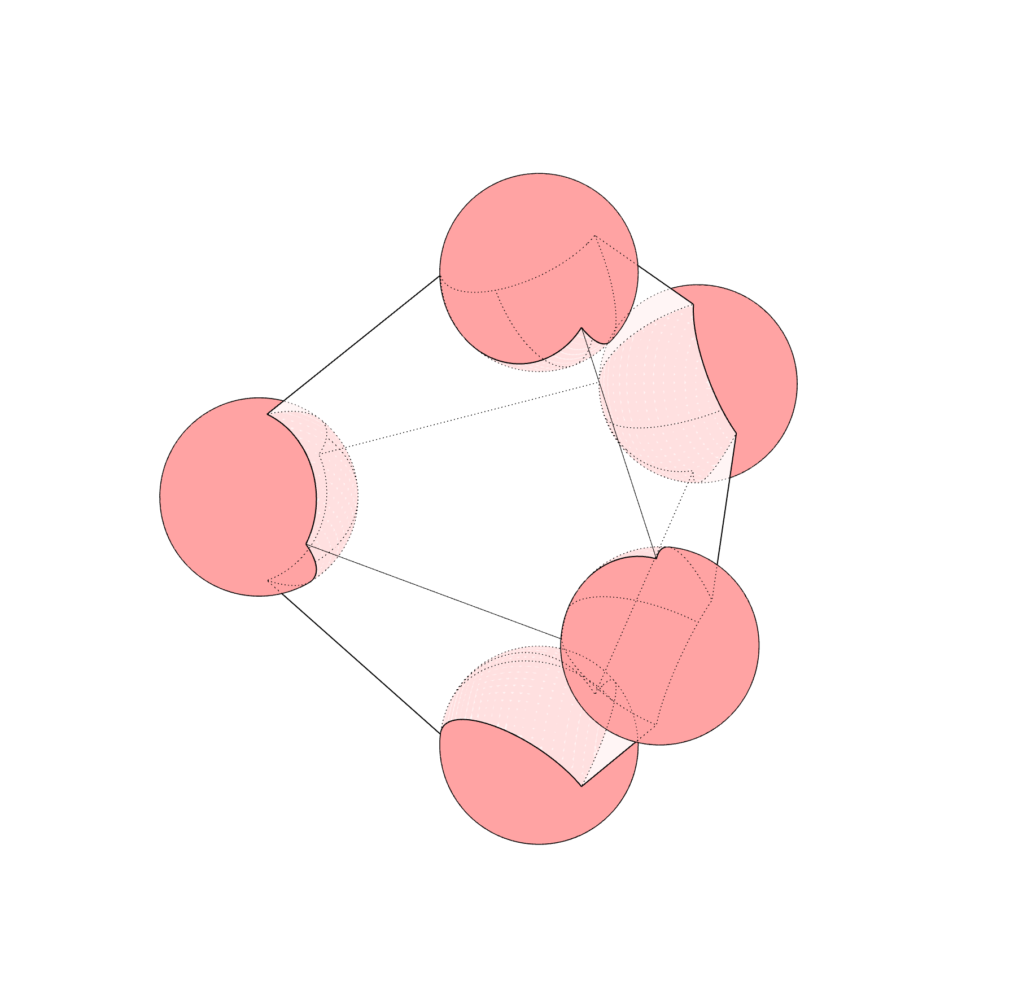
Pics/5unit_str.png
