Sheen-Cao/Ballooance/Pics/6unit_str.png

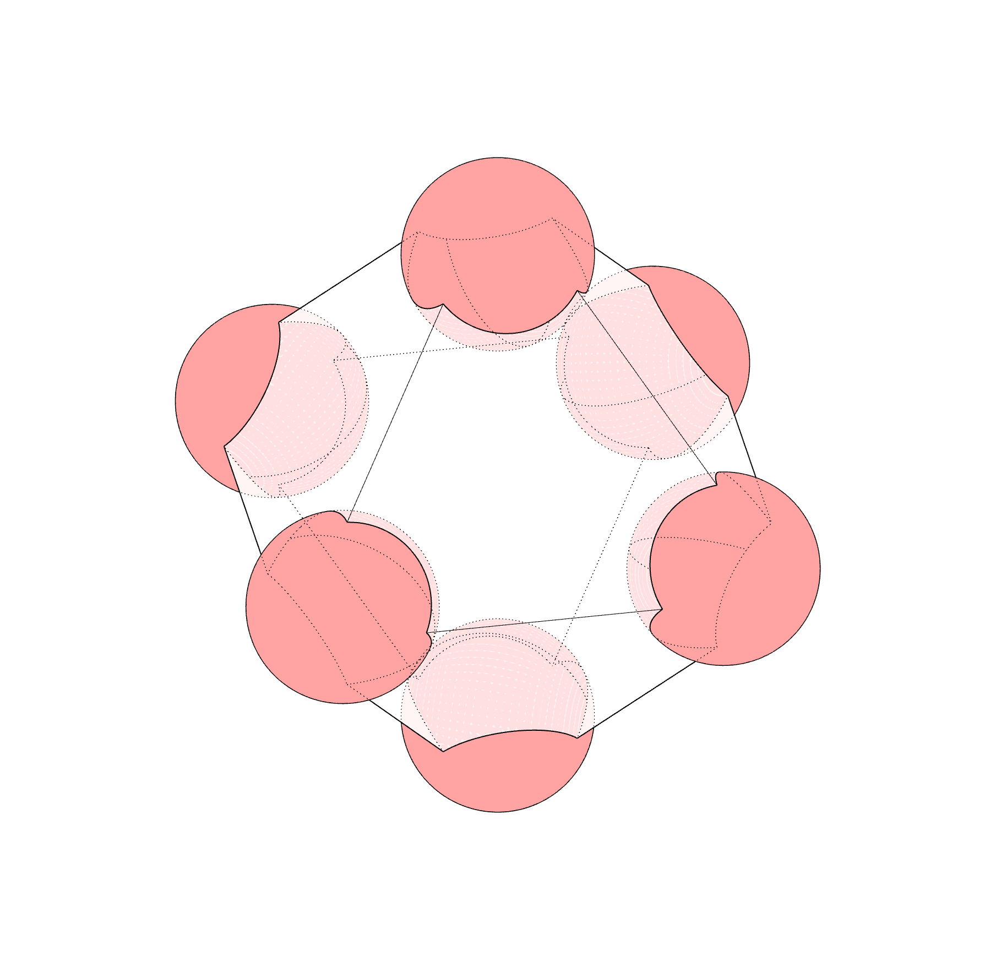
Pics/6unit_str.png
