Sheen-Cao/Ballooance/Pics/8unit.png

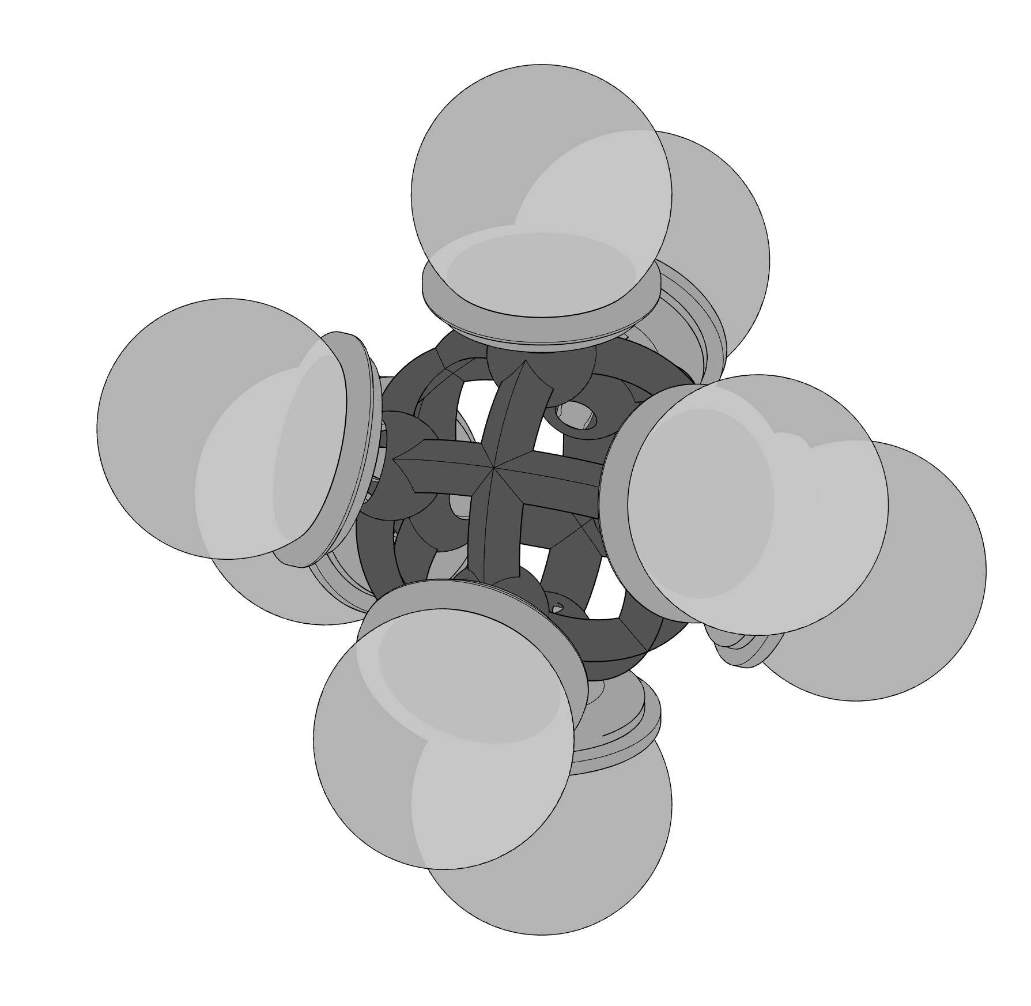
Pics/8unit.png
