Sheen-Cao/Ballooance/Pics/8unit_core.png

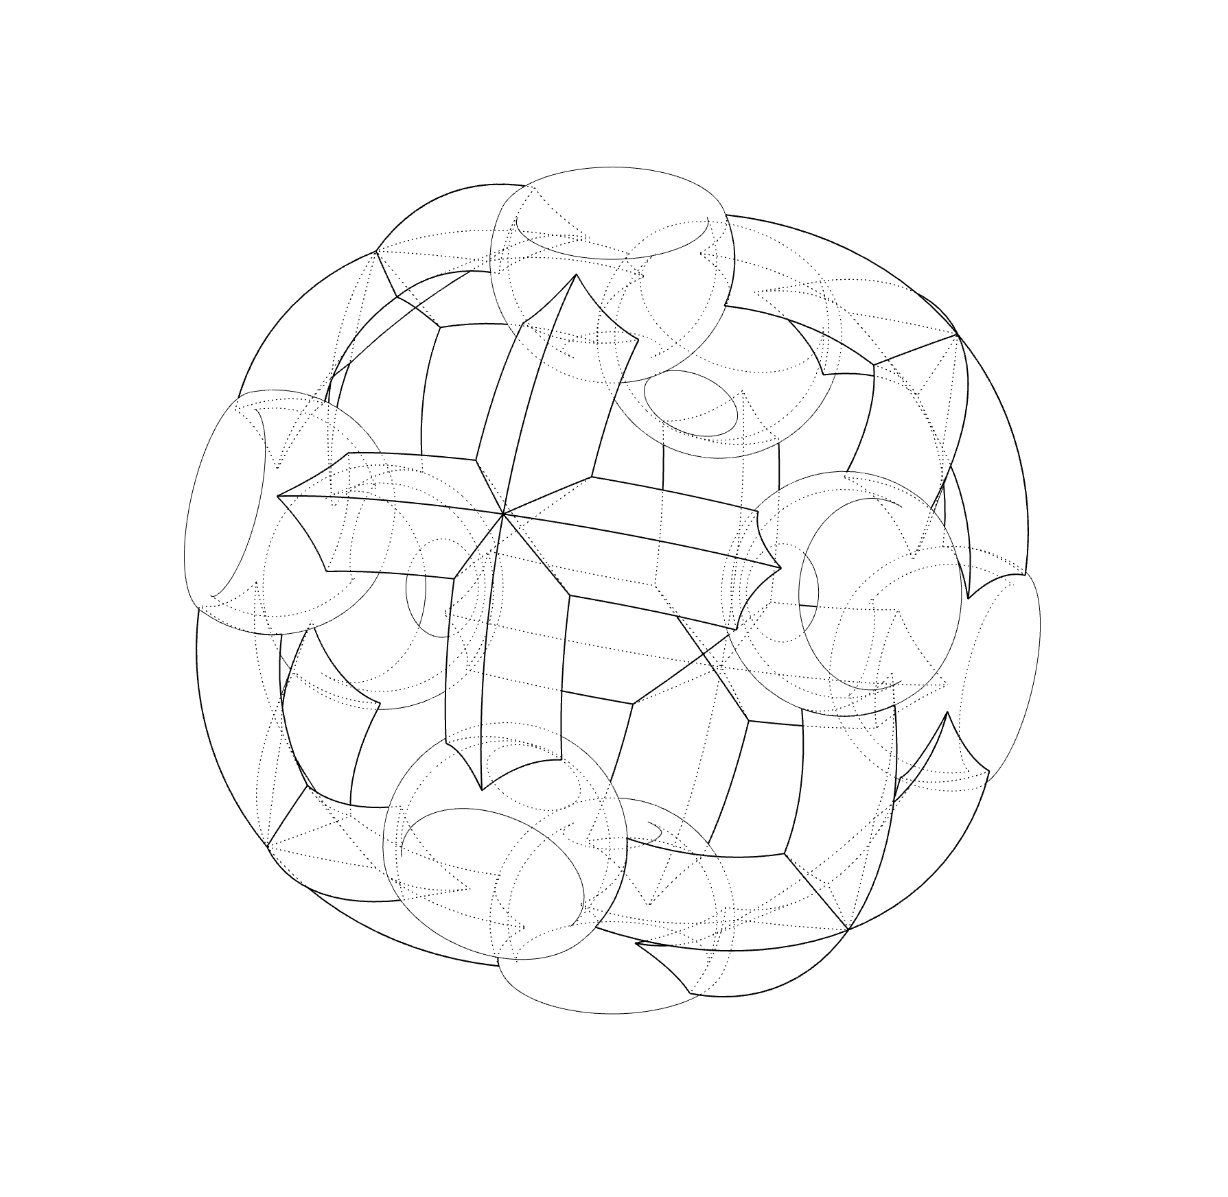
Pics/8unit_core.png
