Sheen-Cao/Ballooance/Pics/8unit_str.png

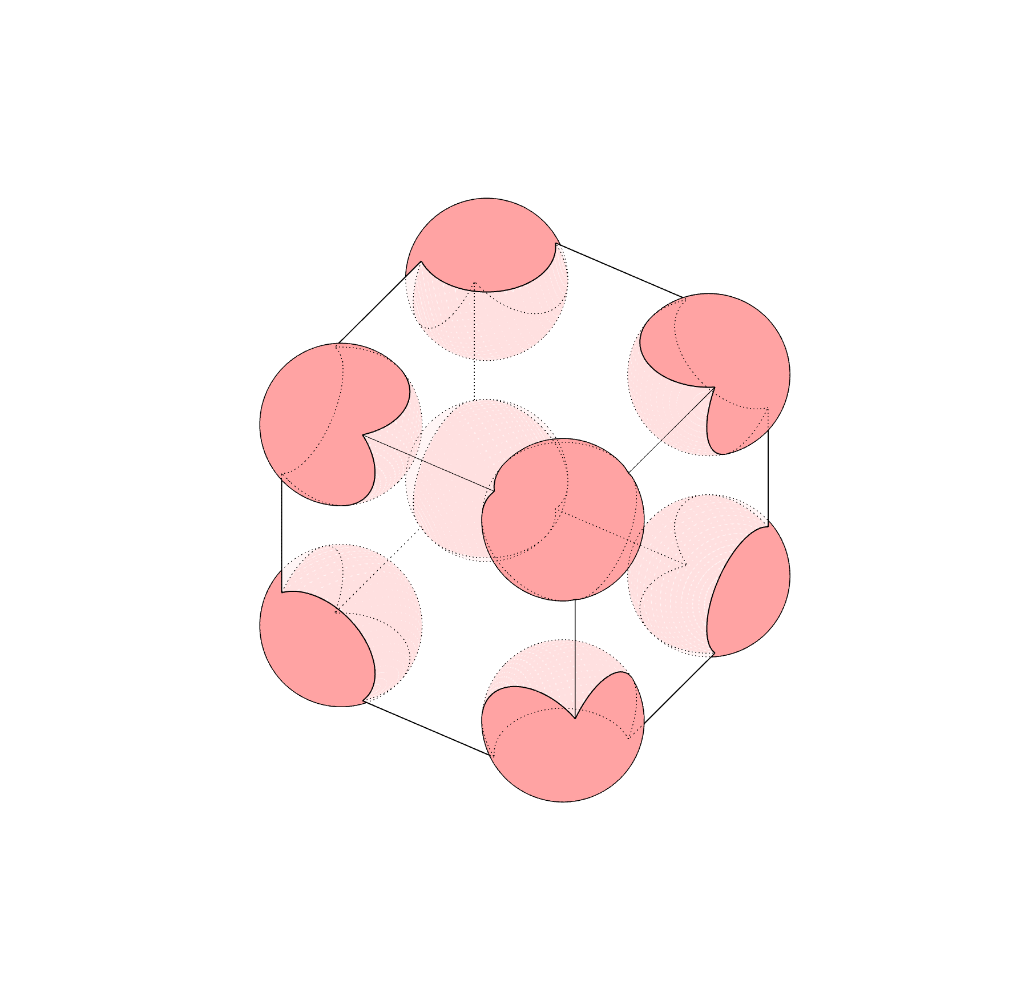
Pics/8unit_str.png
