Sheen-Cao/Ballooance/Pics/bg_em_1.png

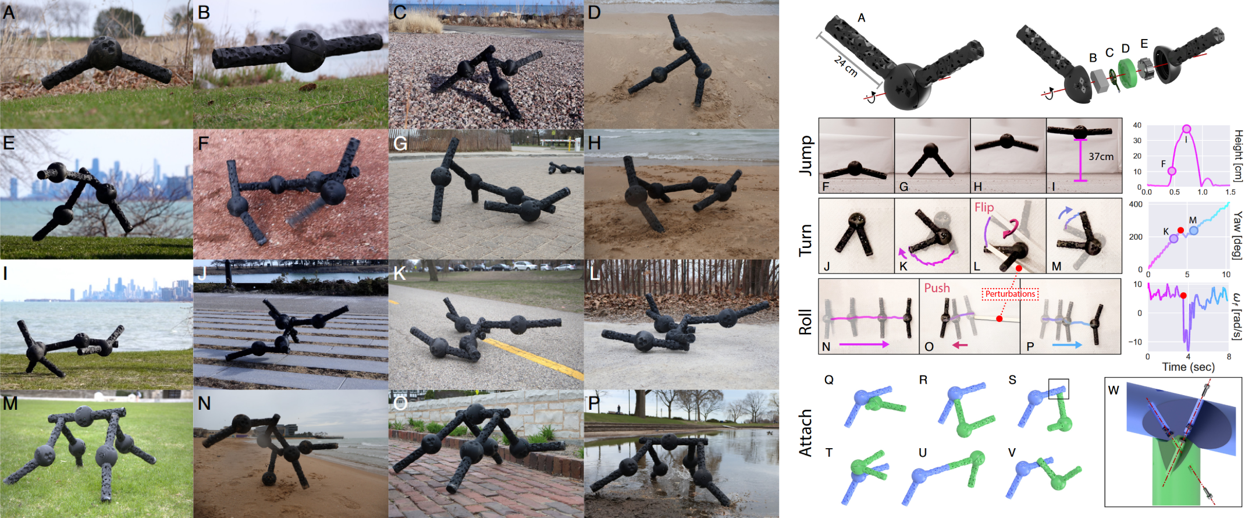
Pics/bg_em_1.png
