Sheen-Cao/Ballooance/Pics/bg_em_2.jpg

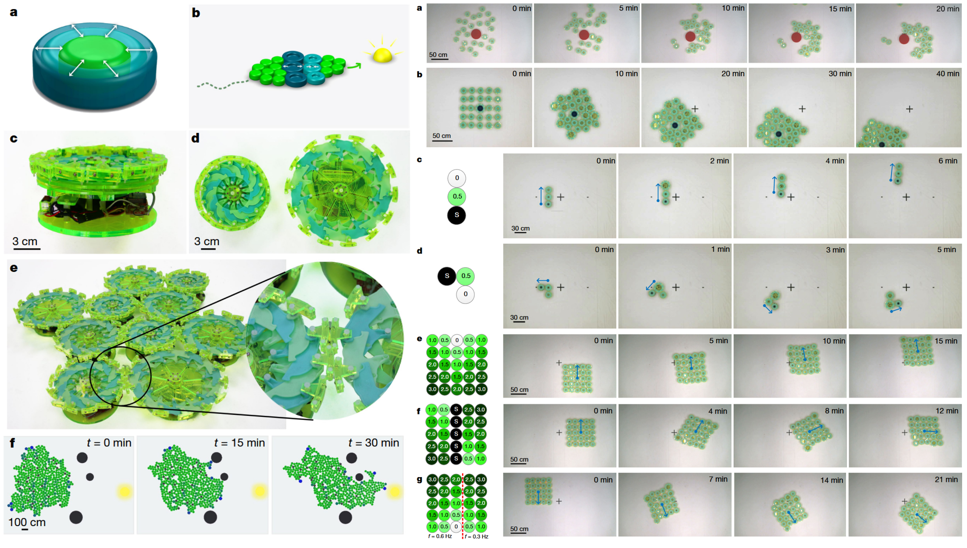
Pics/bg_em_2.jpg
