Sheen-Cao/Ballooance/Pics/bg_mc_1.png

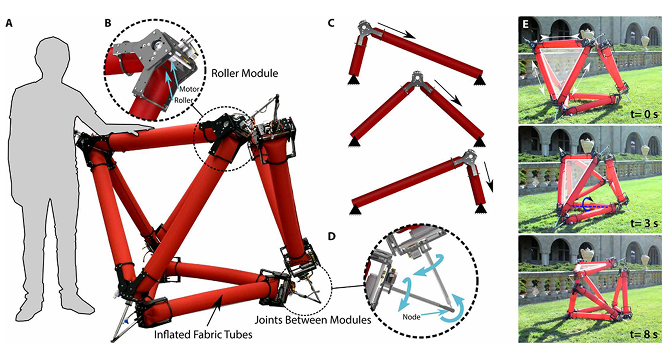
Pics/bg_mc_1.png
