Sheen-Cao/Ballooance/Pics/bg_mrr_1.jpg

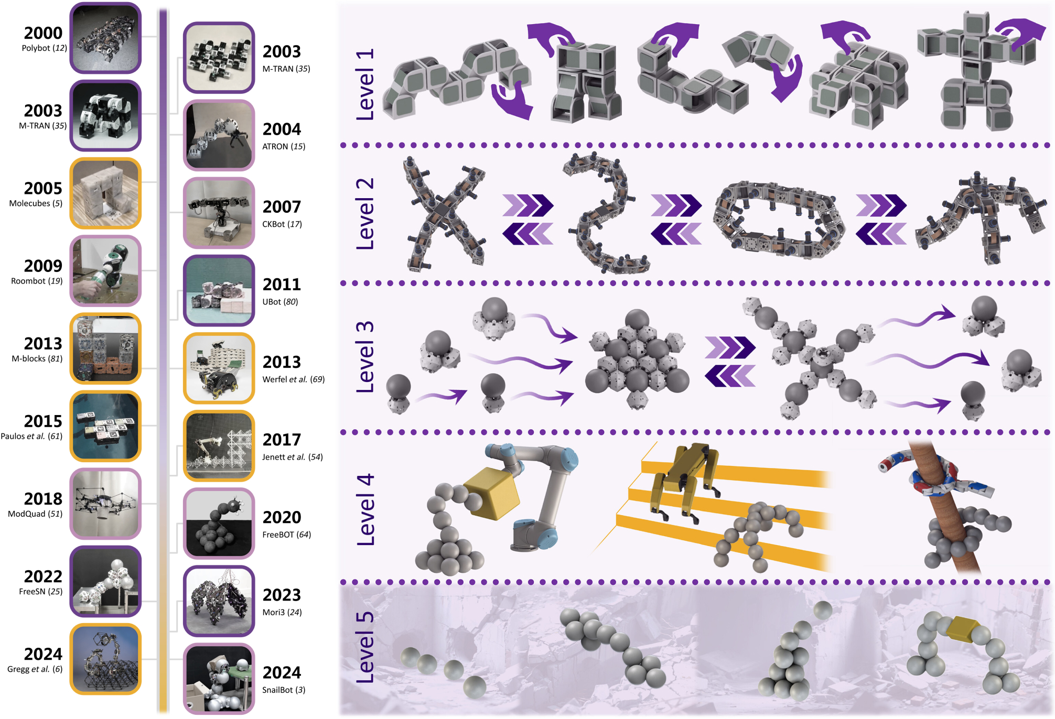
Pics/bg_mrr_1.jpg
