Sheen-Cao/Ballooance/Pics/bg_mrr_2.jpg

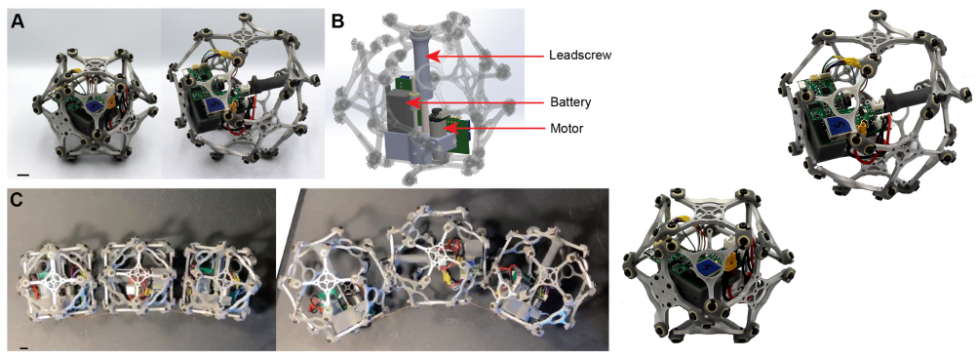
Pics/bg_mrr_2.jpg
