Sheen-Cao/Ballooance/Pics/configuration_types.jpg

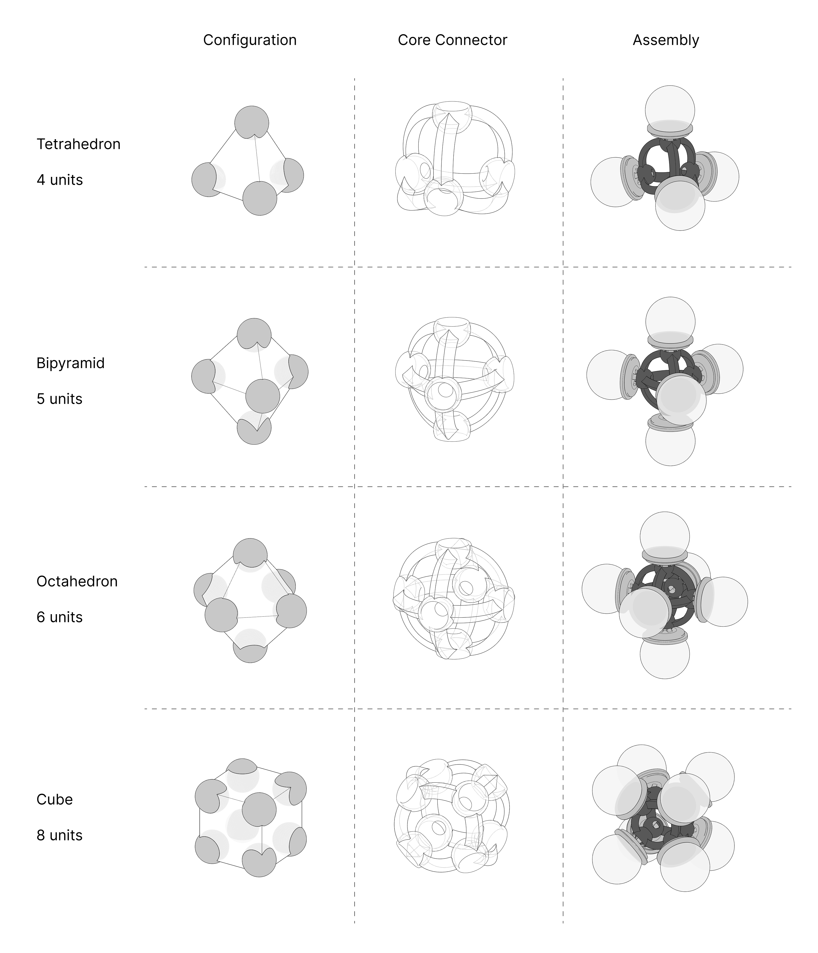
Pics/configuration_types.jpg
