Sheen-Cao/Ballooance/Pics/configuration_types.png

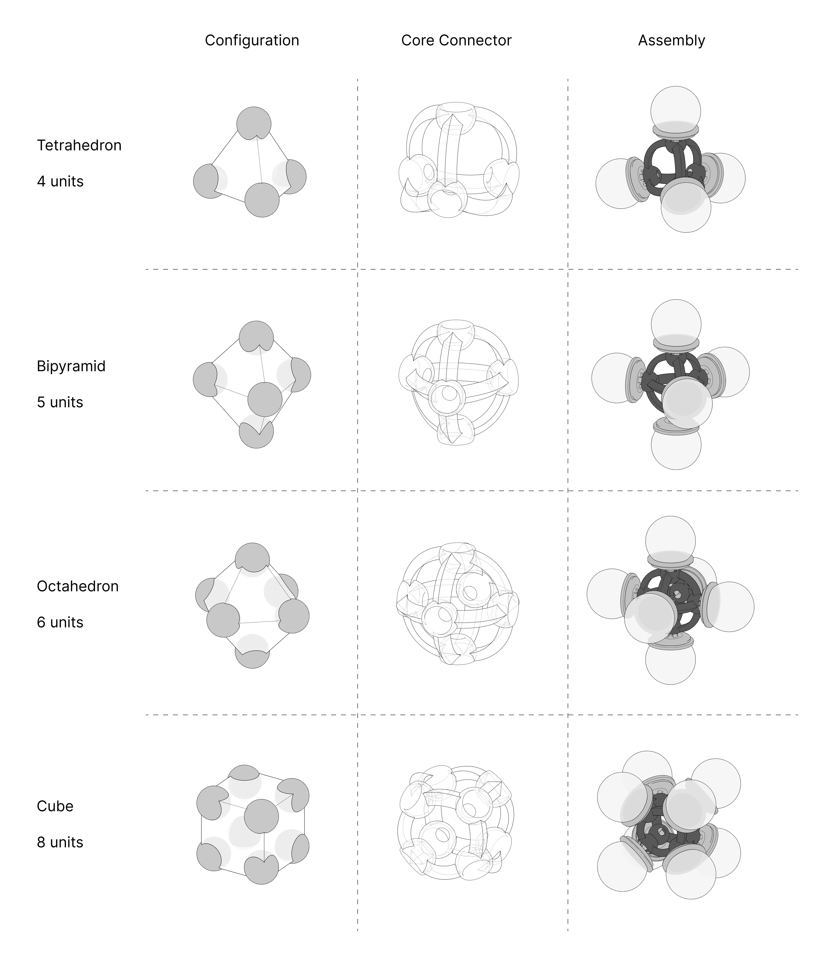
Pics/configuration_types.png
