Sheen-Cao/Ballooance/Pics/core-tetra.jpg

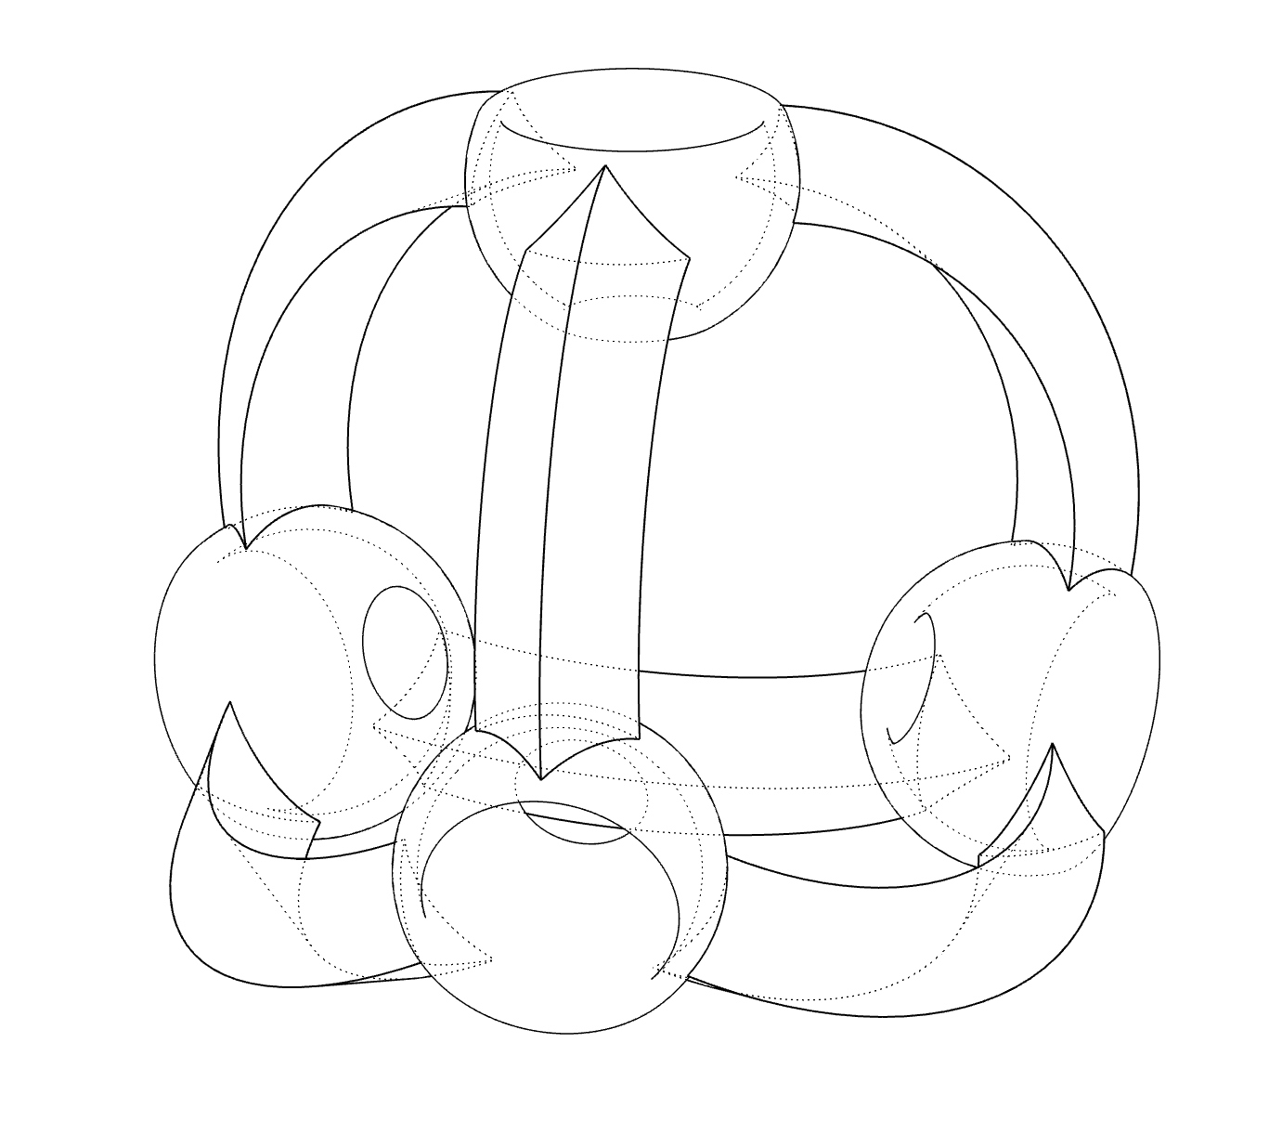
Pics/core-tetra.jpg
