Sheen-Cao/Ballooance/Pics/core_bipyra.jpg

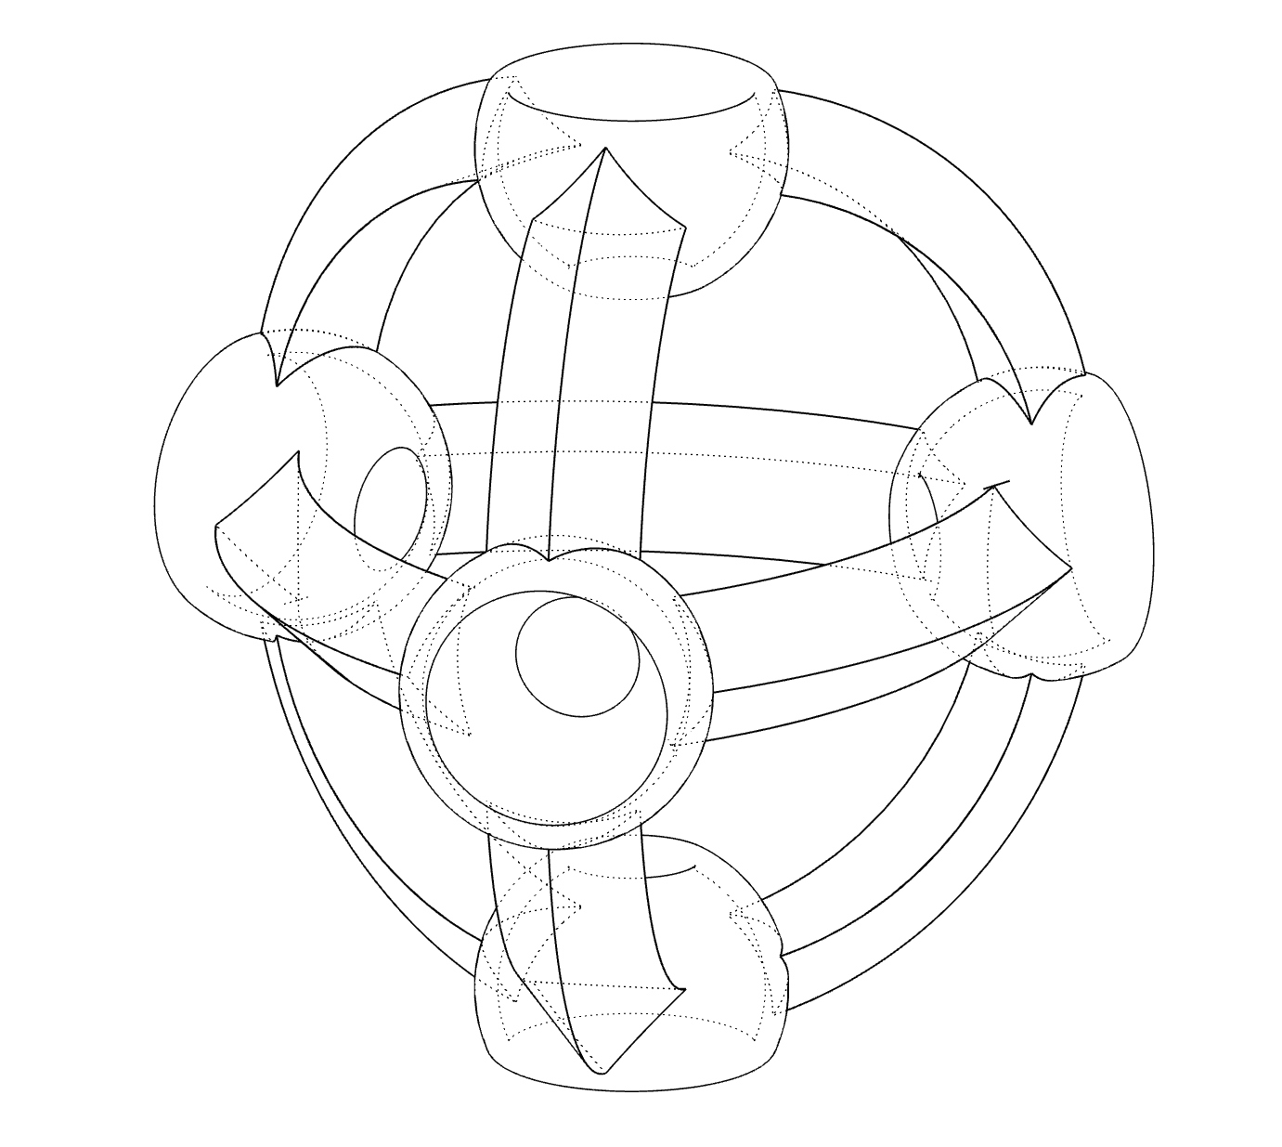
Pics/core_bipyra.jpg
