Sheen-Cao/Ballooance/Pics/core_cube.jpg

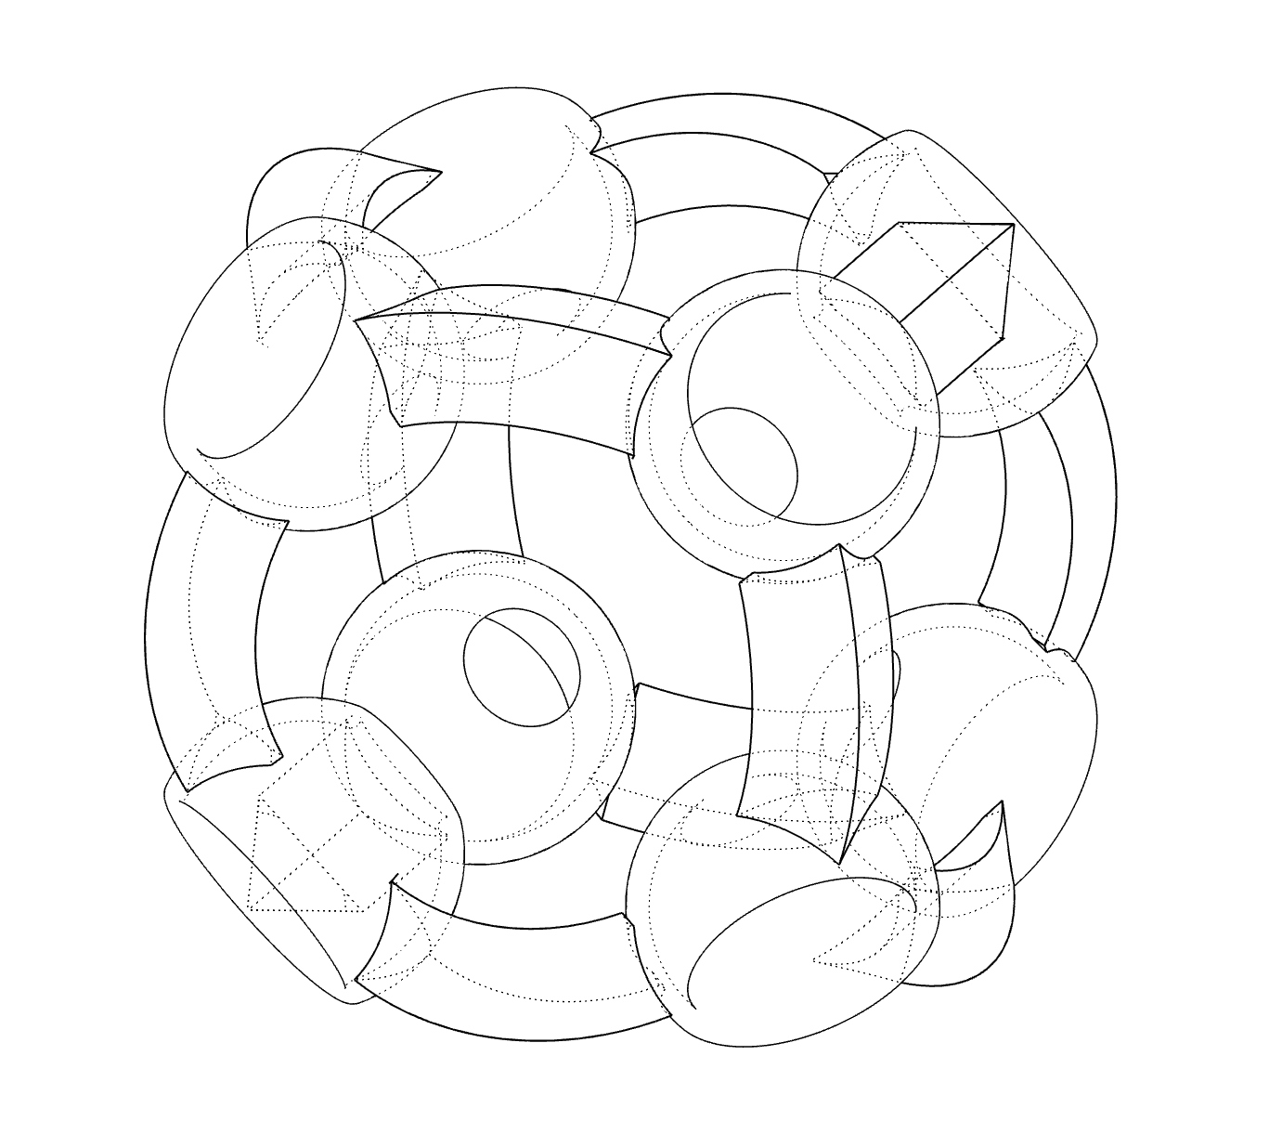
Pics/core_cube.jpg
