Sheen-Cao/Ballooance/Pics/core_octa.jpg

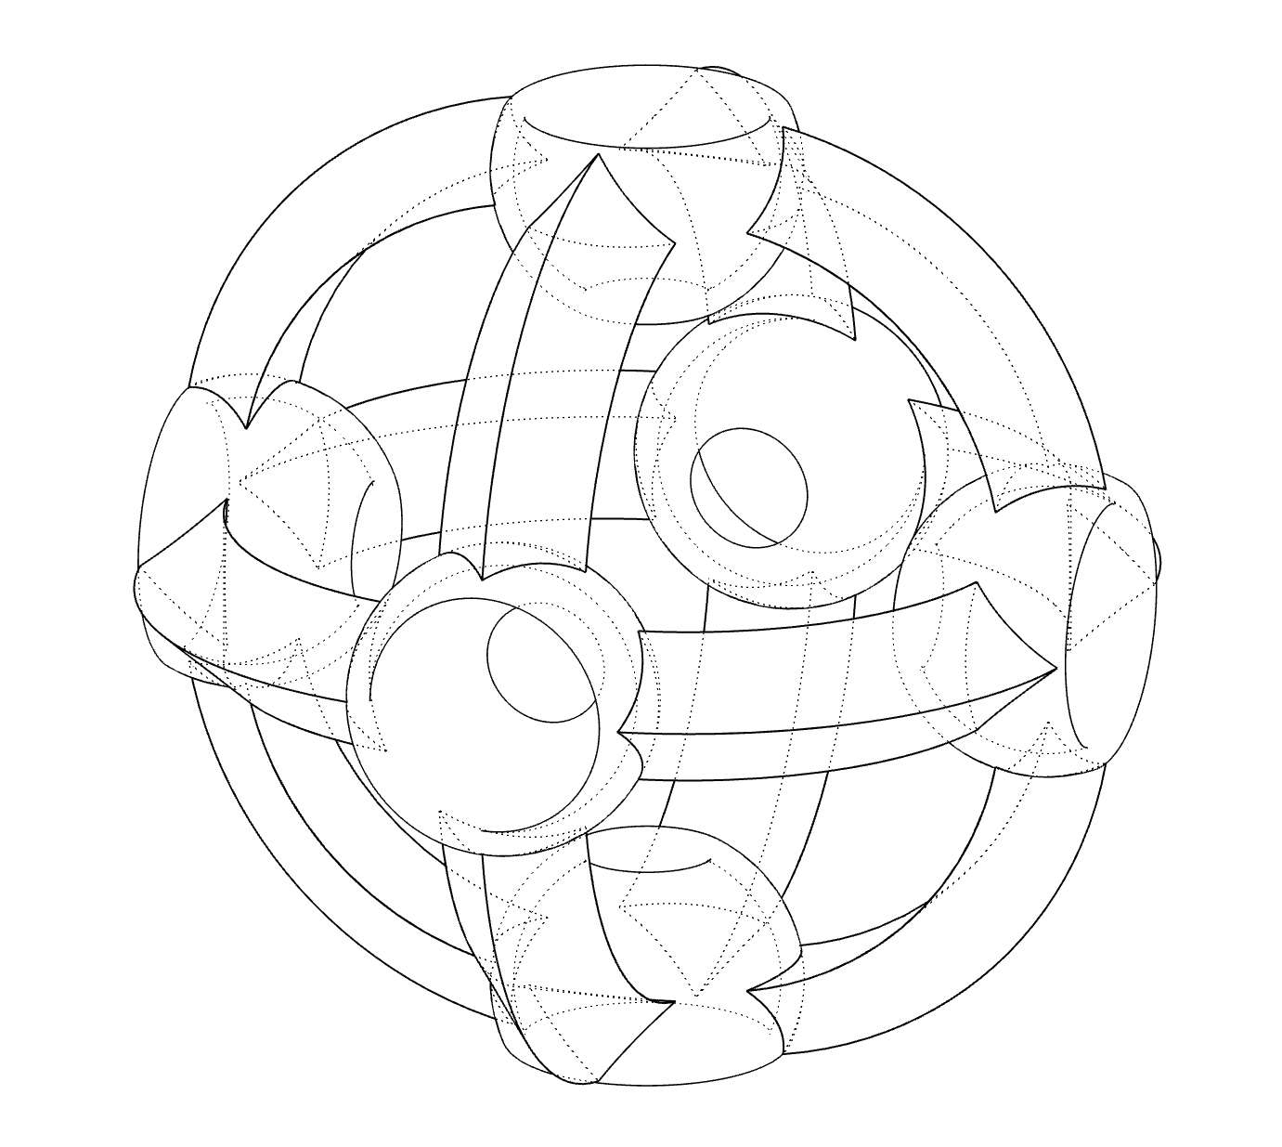
Pics/core_octa.jpg
