Sheen-Cao/Ballooance/Pics/exploded.jpg

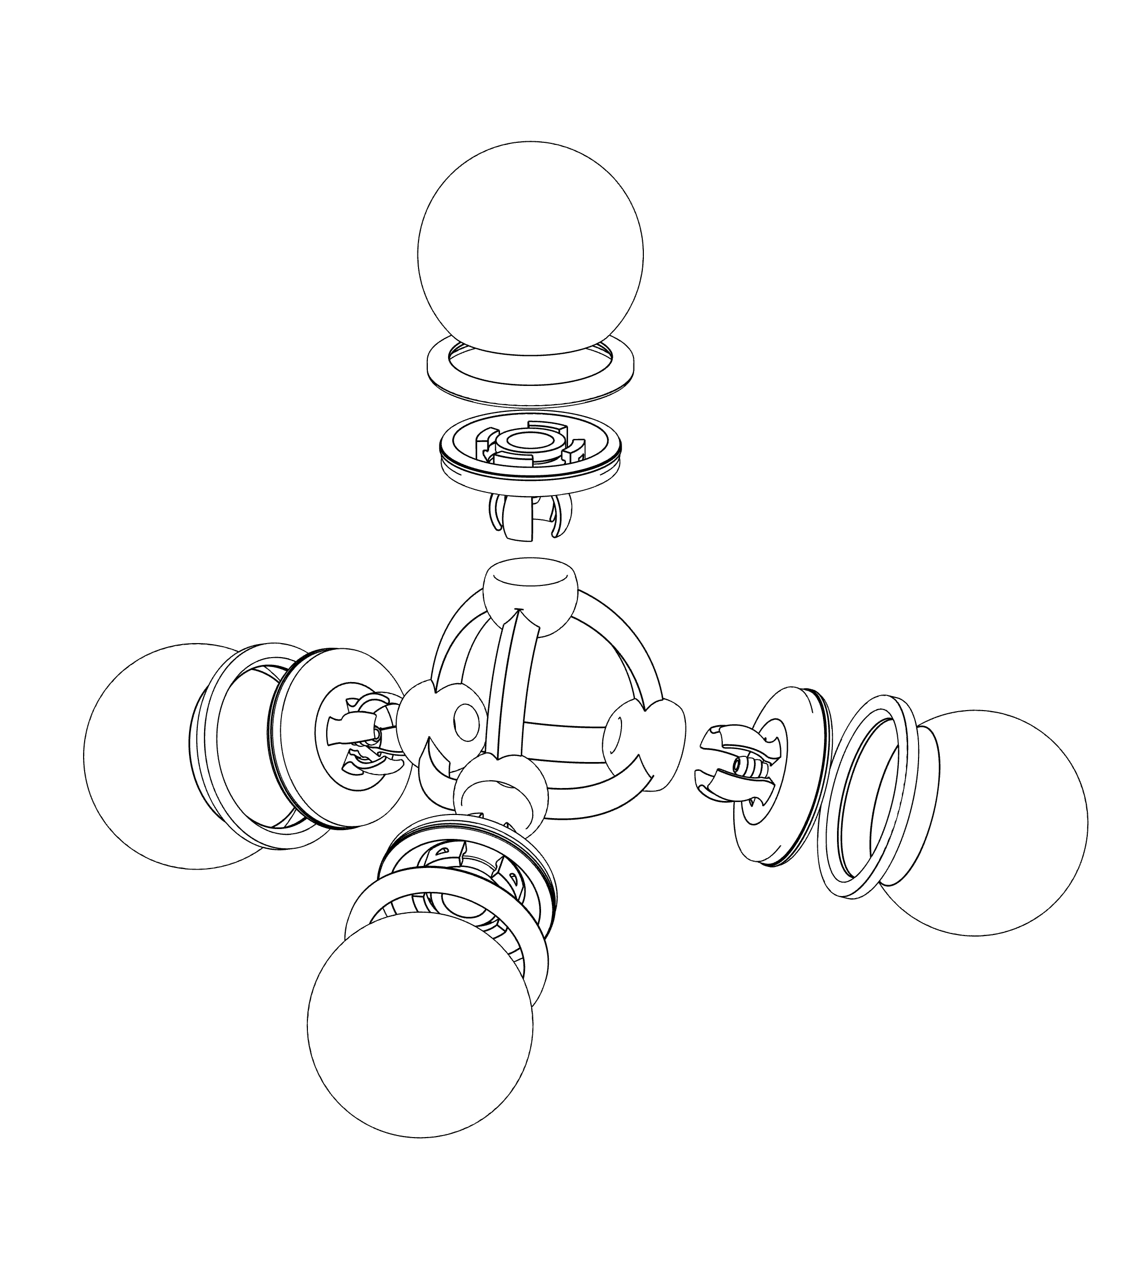
Pics/exploded.jpg
