Sheen-Cao/Ballooance/Pics/iteration_balloon.png

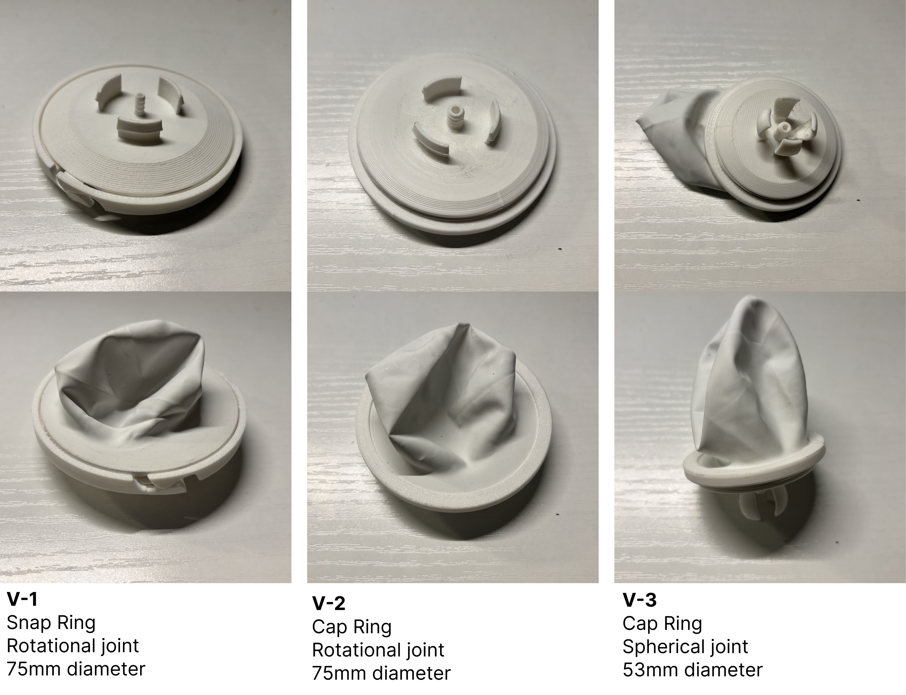
Pics/iteration_balloon.png
