Sheen-Cao/Ballooance/Pics/iteration_module.png

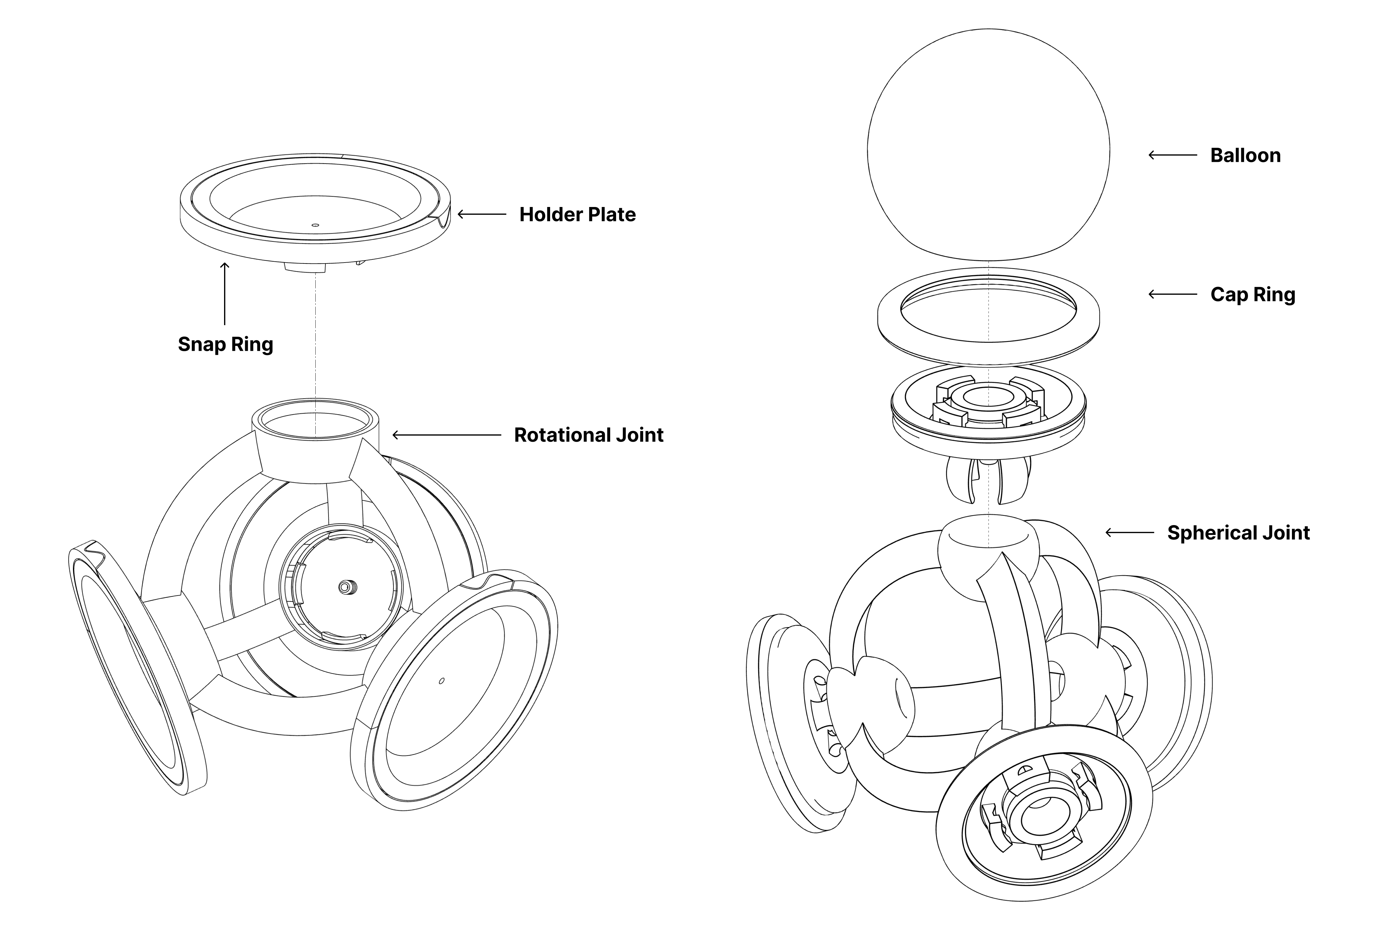
Pics/iteration_module.png
