Sheen-Cao/Ballooance/Pics/iteration_plate.png

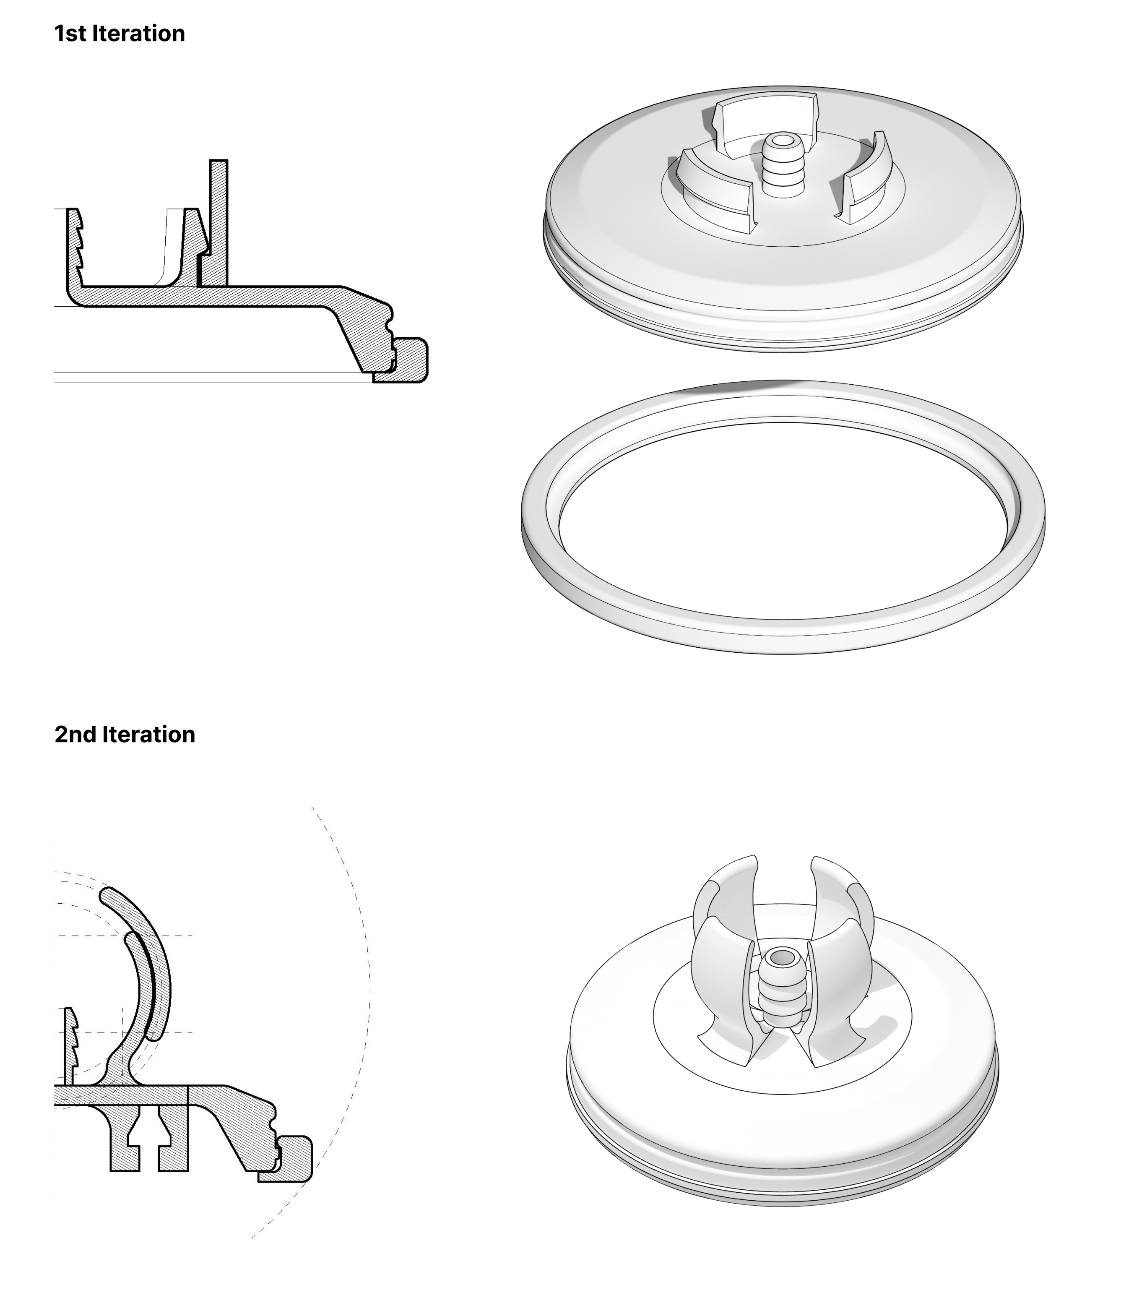
Pics/iteration_plate.png
