Sheen-Cao/Ballooance/Pics/motor_solenoids_driver.png

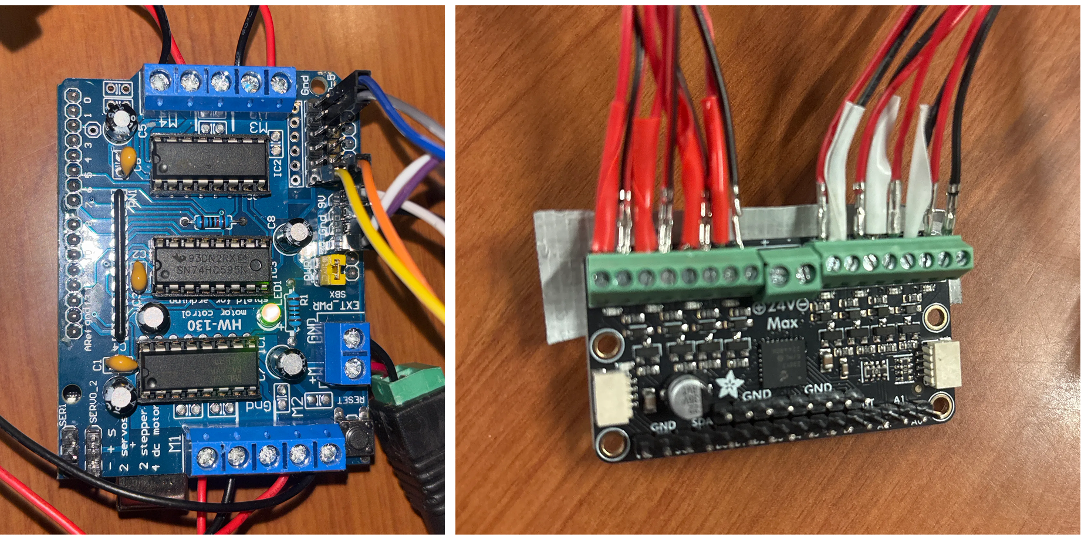
Pics/motor_solenoids_driver.png
