Sheen-Cao/Ballooance/Pics/mrr_five_levels.png

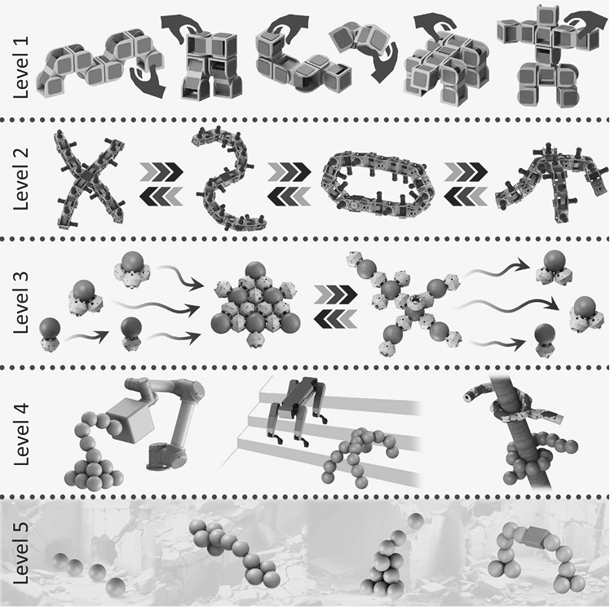
Pics/mrr_five_levels.png
