Sheen-Cao/Ballooance/Pics/mrr_five_levels_0.png

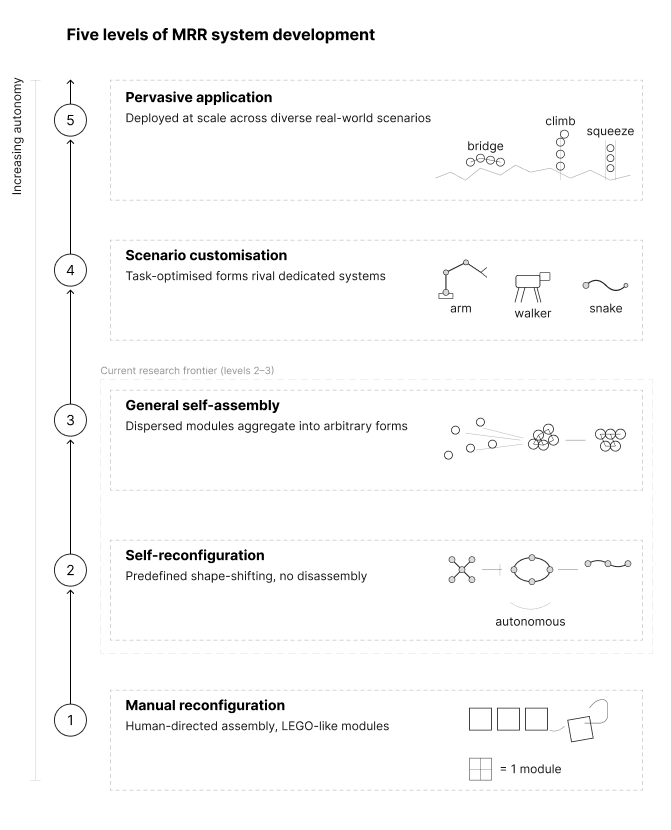
Pics/mrr_five_levels_0.png
