Sheen-Cao/Ballooance/Pics/parametric_workflow.png

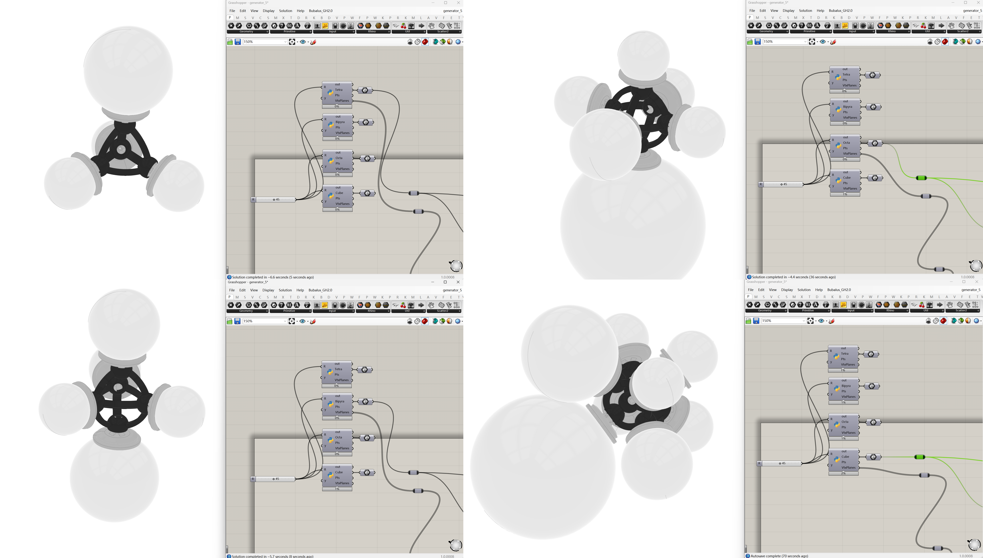
Pics/parametric_workflow.png
