Sheen-Cao/Ballooance/Pics/pneumatic_control.jpeg

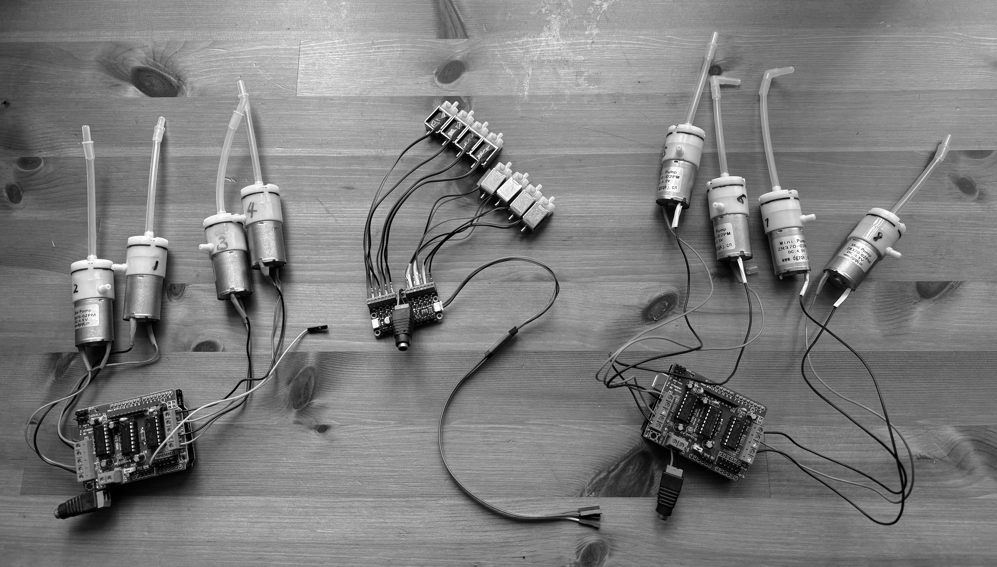
Pics/pneumatic_control.jpeg
