Sheen-Cao/Ballooance/Pics/recording_1.png

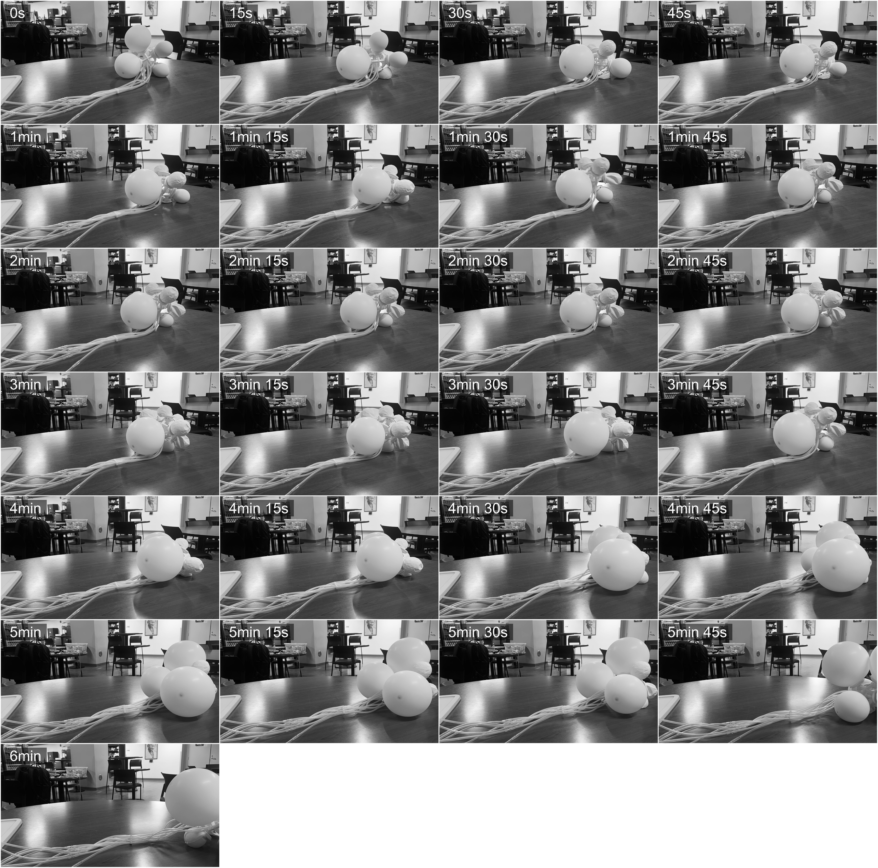
Pics/recording_1.png
