Sheen-Cao/Ballooance/Pics/recording_2_1.png

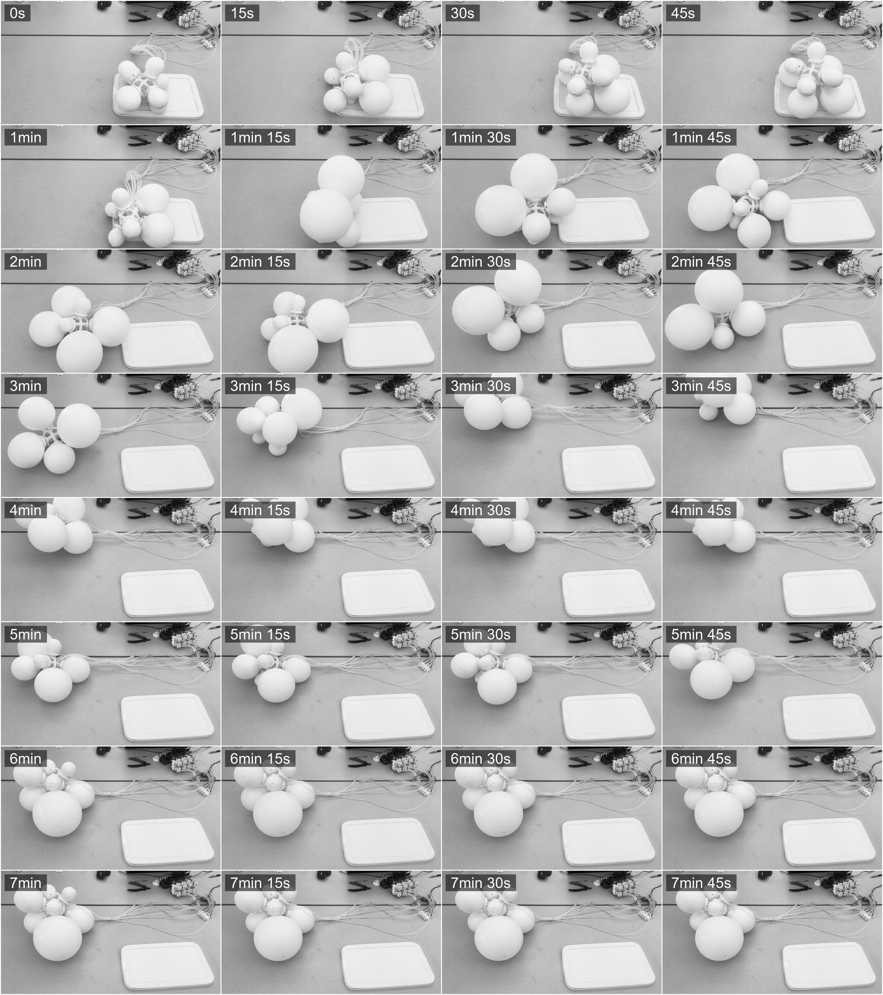
Pics/recording_2_1.png
