Sheen-Cao/Ballooance/Pics/section.jpg

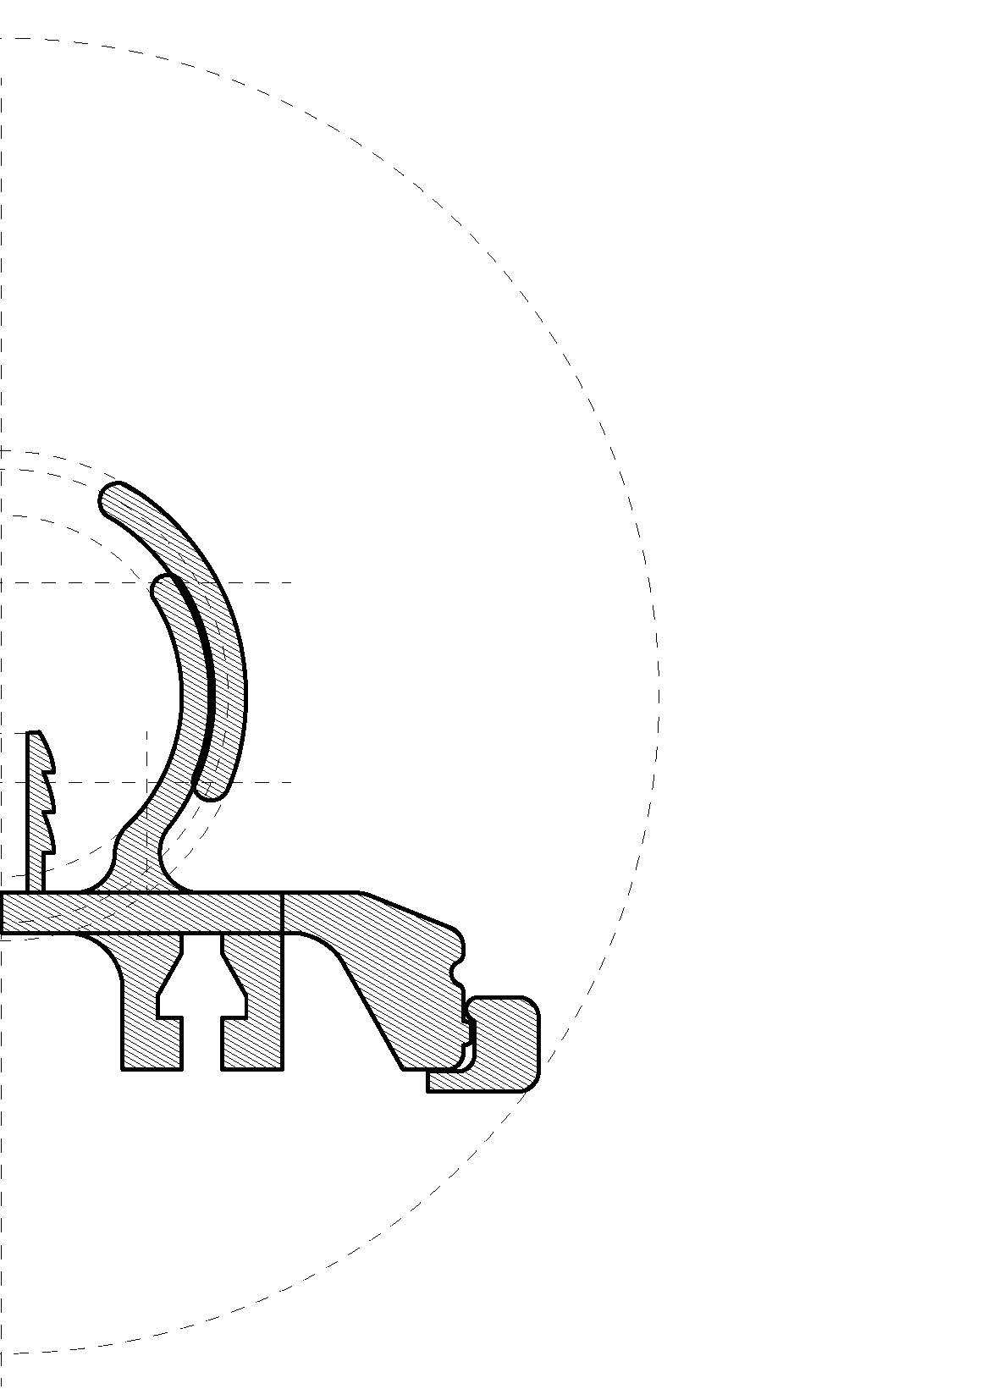
Pics/section.jpg
