Sheen-Cao/Ballooance/Pics/sim_mujoco.png

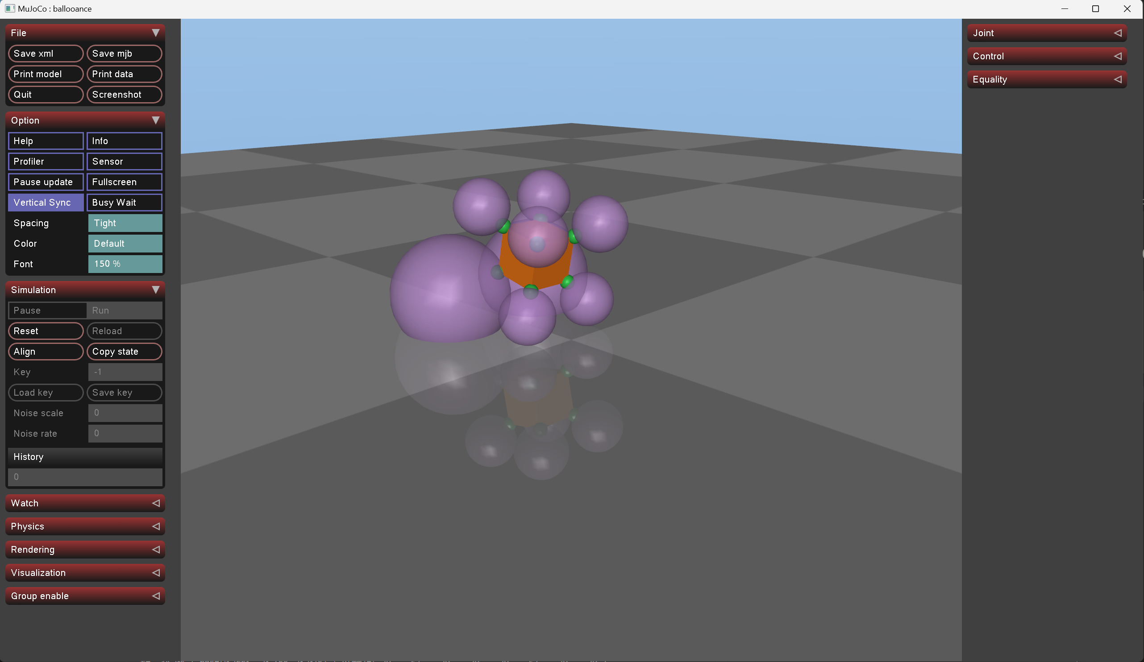
Pics/sim_mujoco.png
