Sheen-Cao/Ballooance/Pics/thesis_models.png

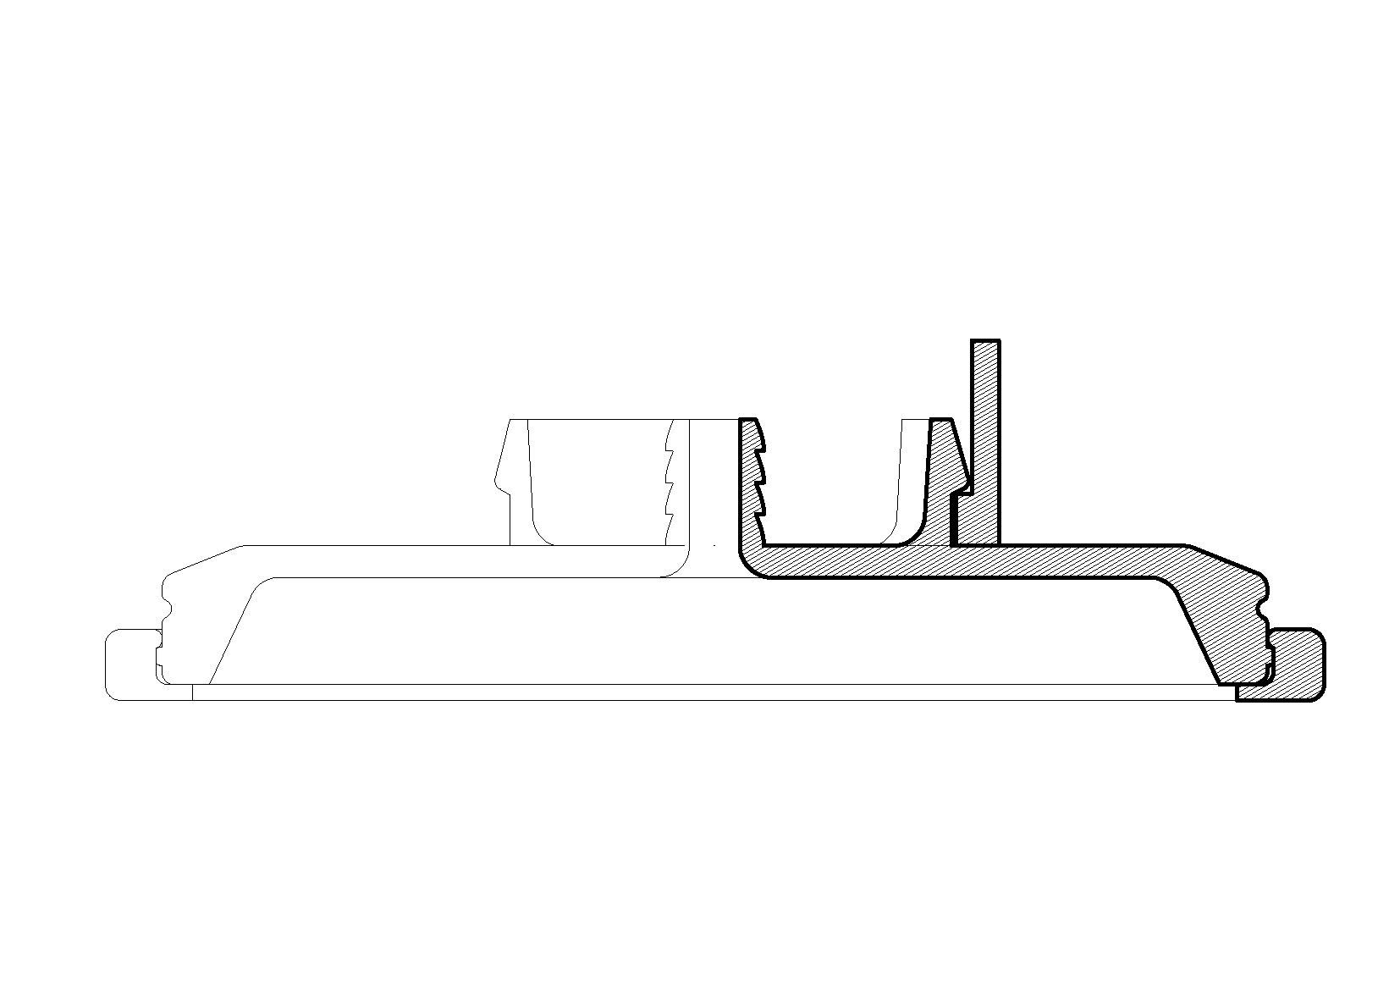
Pics/thesis_models.png
