Sheen-Cao/Ballooance/Pics/types-1.png

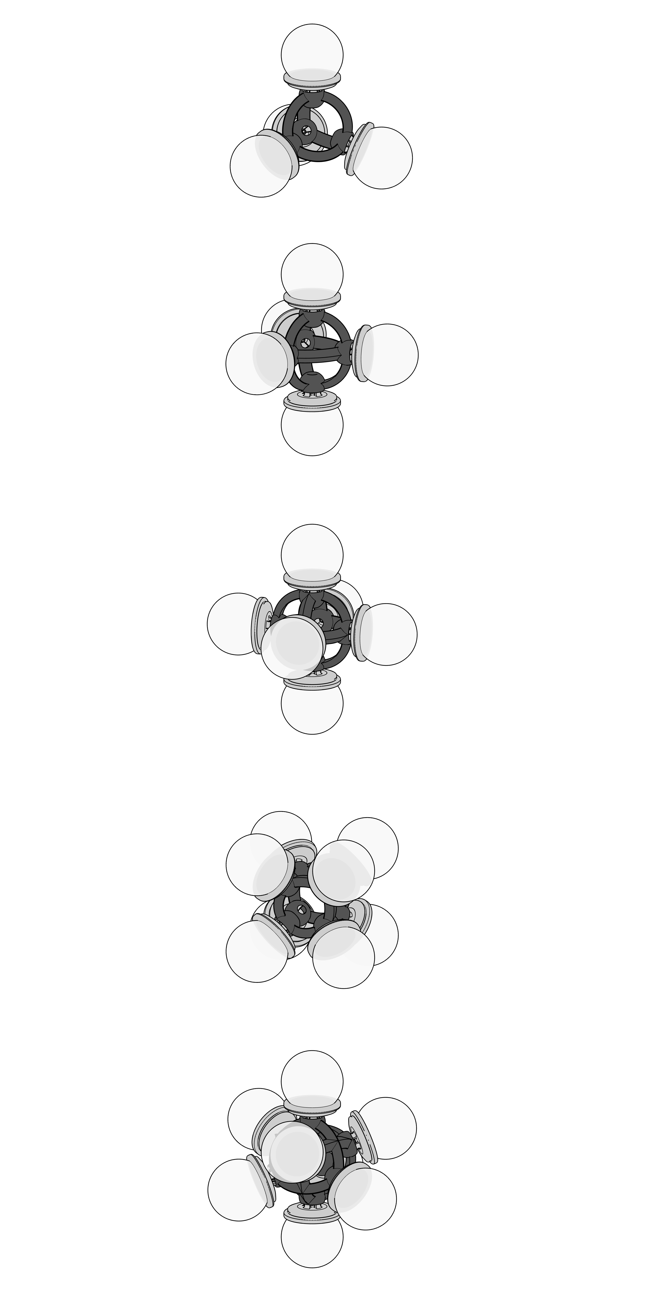
Pics/types-1.png
