Sheen-Cao/Ballooance/Pics/ViewCapture20260430_081822.png

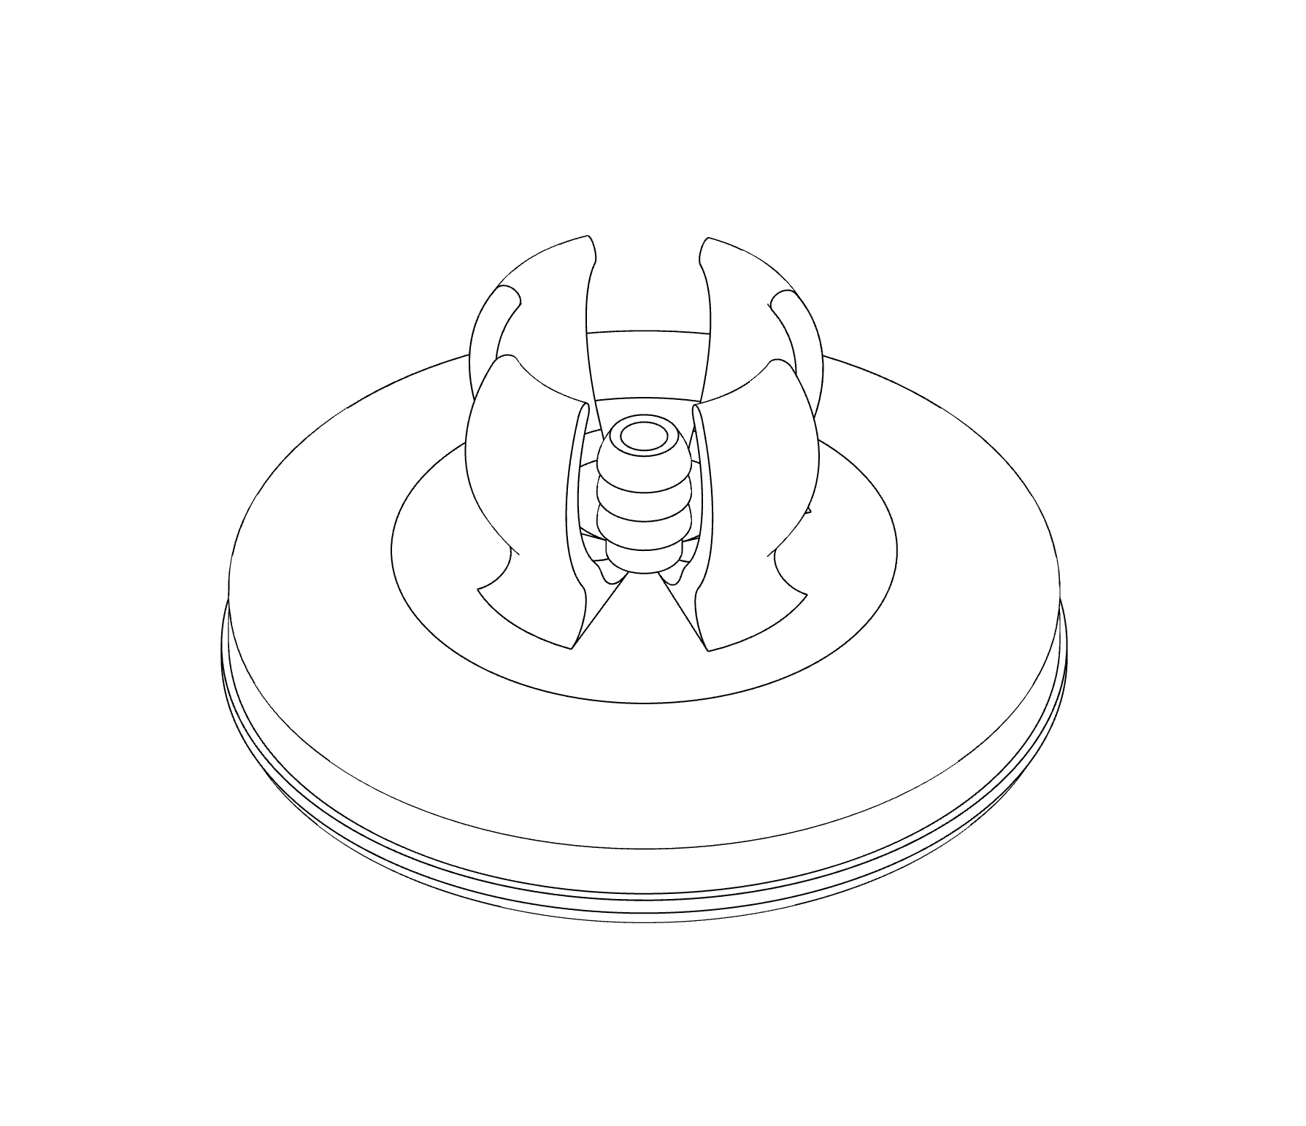
Pics/ViewCapture20260430_081822.png
