Sheen-Cao/Ballooance/Pics/ViewCapture20260430_082058.png

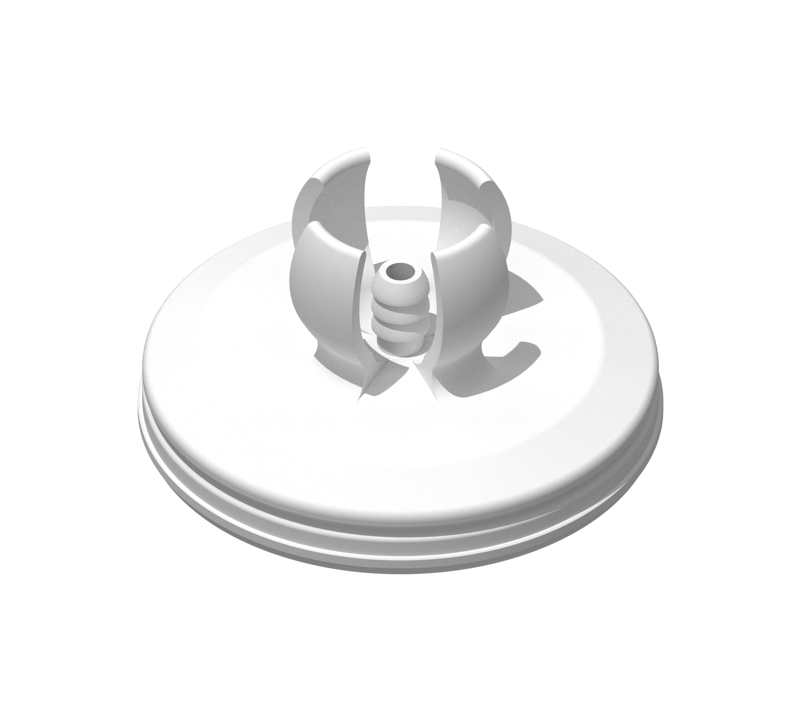
Pics/ViewCapture20260430_082058.png
