Sheen-Cao/Ballooance/Pics/ViewCapture20260430_094801.png

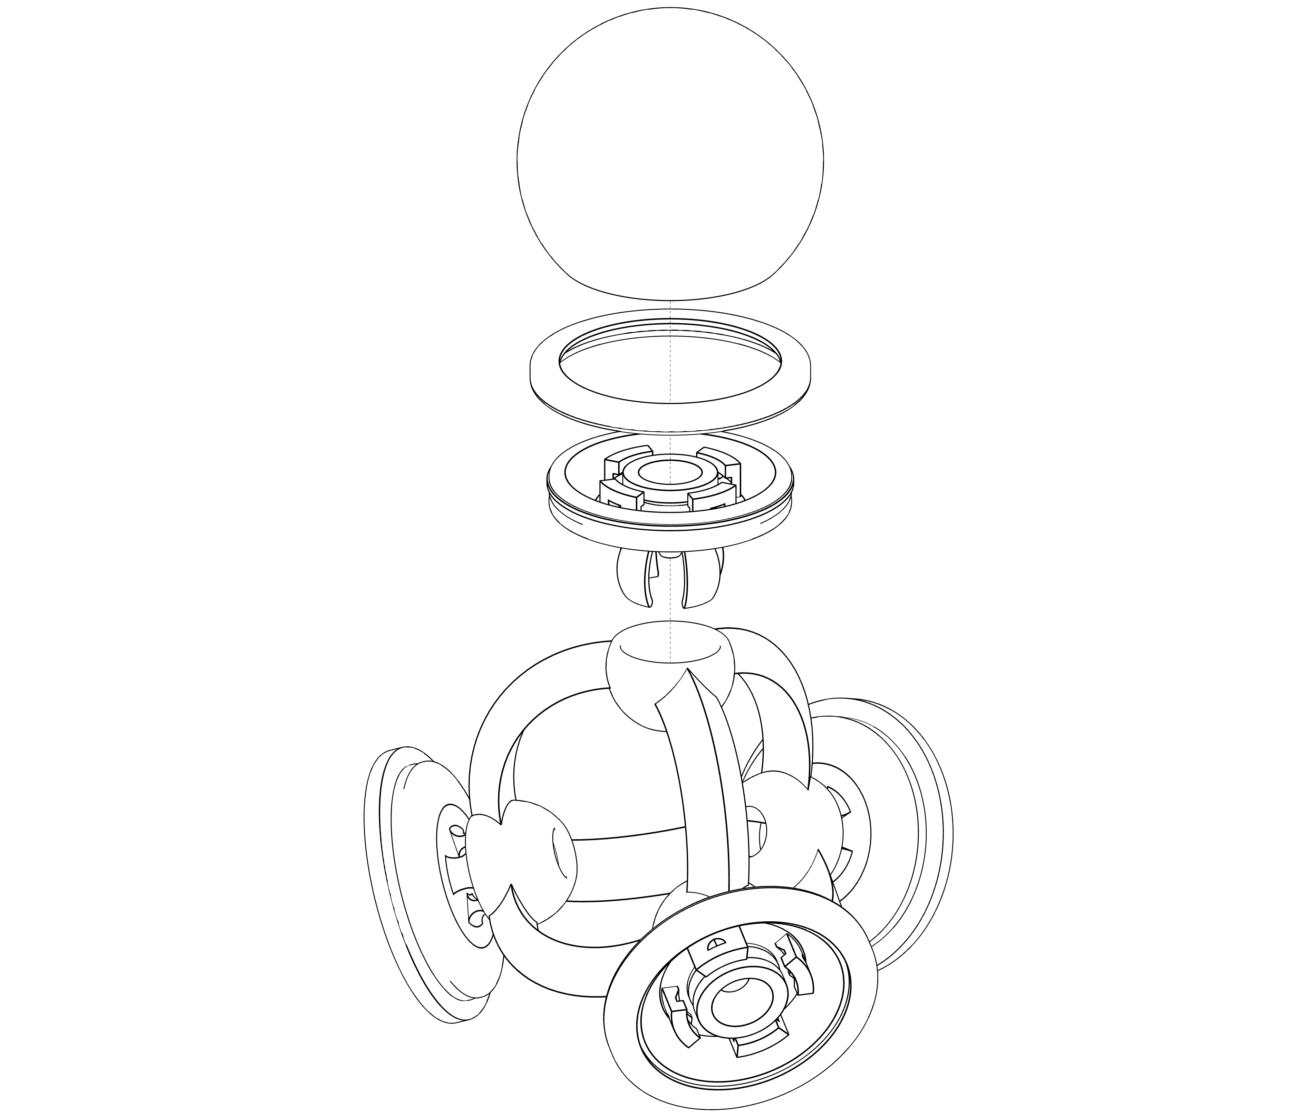
Pics/ViewCapture20260430_094801.png
