Sheen-Cao/Ballooance/(list of files, cad)

Other CAD files:
3d_models/thesis_models.3dm
