Sheen-Cao/Ballooance/doc/Pre-thesis I.pdf

# Synthesized Intelligence:

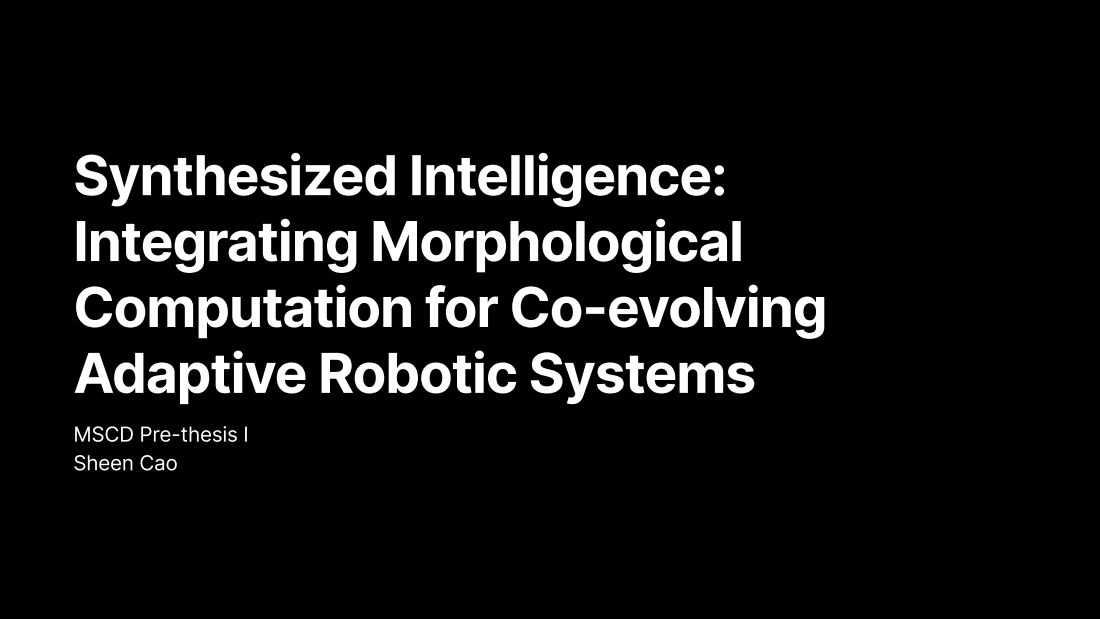
[picture p123: page 1]

Integrating Morphological
Computation for Co-evolving
Adaptive Robotic Systems

MSCD Pre-thesis I
Sheen Cao

Sheen Cao

## Research Question

## Problem Statement

Pre-thesis I

Synthesized Intelligence

How can embodied or ‘morphological’ computation—

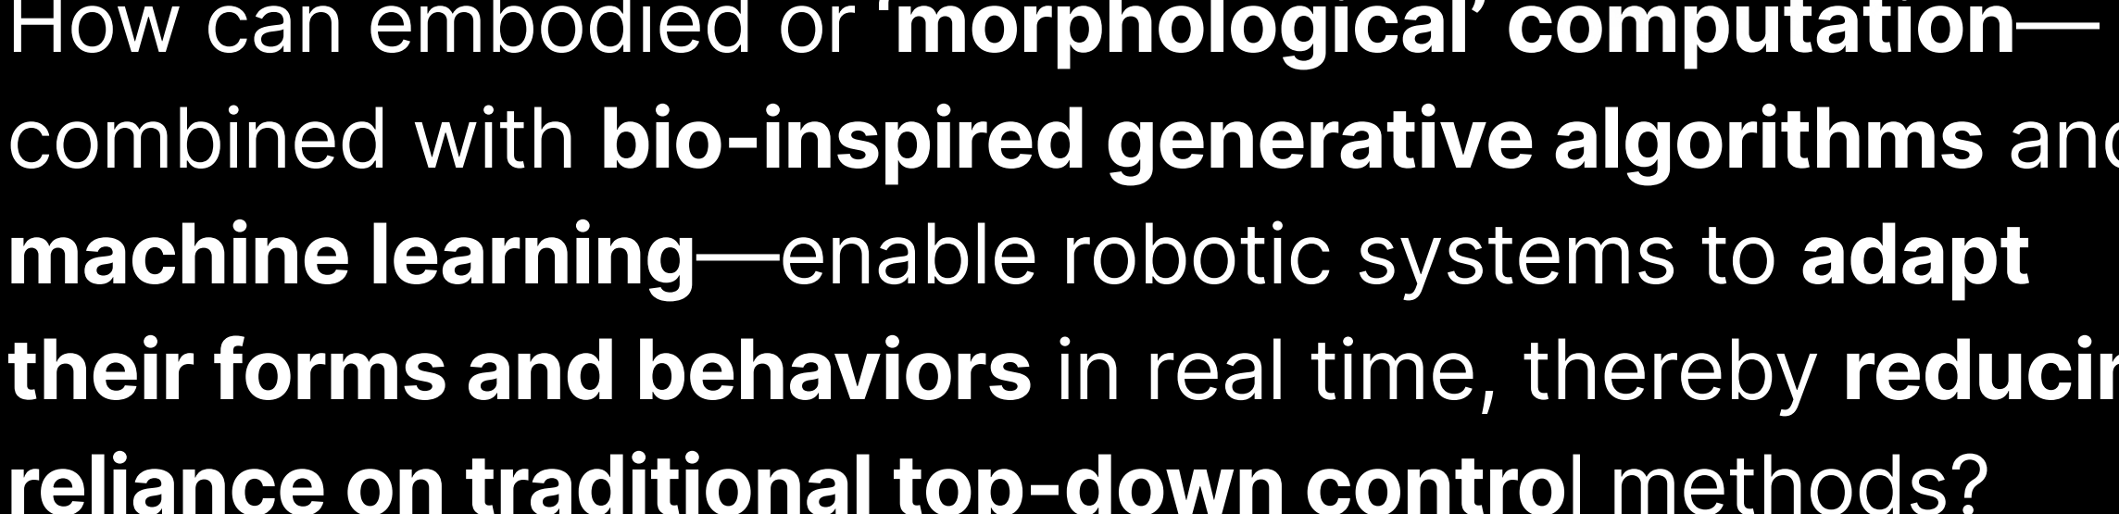
[picture p124: figure]

combined with bio-inspired generative algorithms and machine learning—enable robotic systems to adapt their forms and behaviors in real time, thereby reducing reliance on traditional top-down control methods?

Traditional robotic systems often separate physical design from control algorithms, leading to rigid structures that lack adaptability. This separation overlooks the potential of morphological computation, where physical structures contribute to computational processes. By integrating bio-inspired generative algorithms with machine learning, there's an opportunity to develop robotic systems that adapt both their form and function in response to environmental stimuli, enhancing resilience and efficiency.

Apr/29/2025

## Previous Work

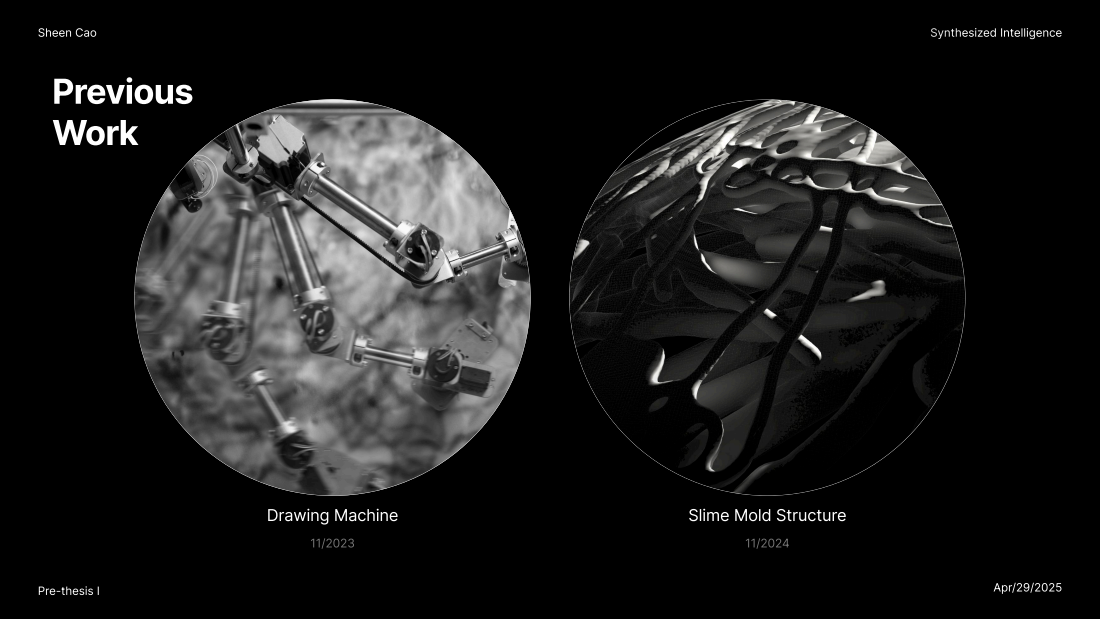
[picture p125: page 3]
Sheen Cao; Synthesized Intelligence; Drawing Machine; Slime Mold Structure; Pre-thesis I; Apr/29/2025

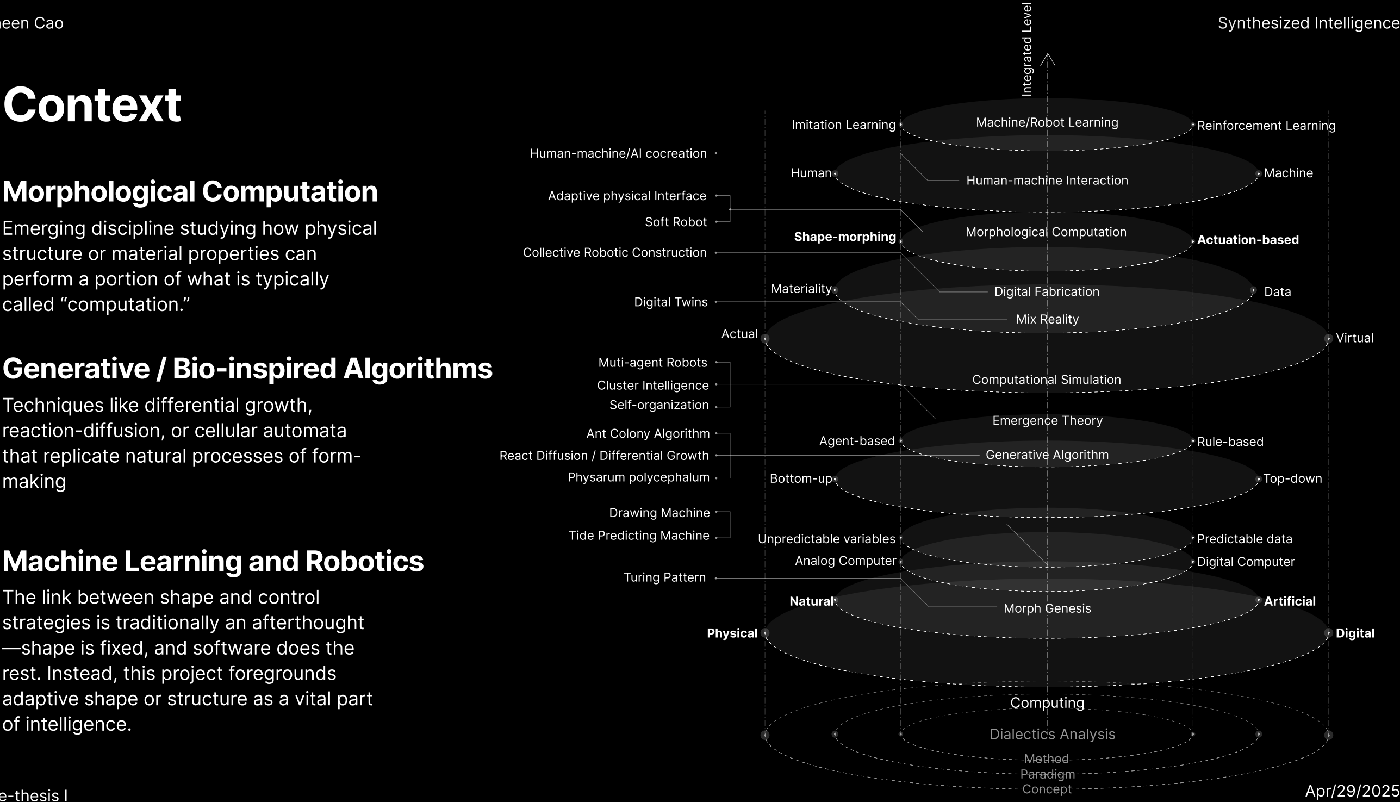
[picture p126: figure]
Context; Human-machine/AI cocreation; Adaptive physical Interface; Soft Robot; Collective Robotic Construction; Digital Twins; Muti-agent Robots; Cluster Intelligence; Self-organization; Ant Colony Algorithm; React Diffusion / Differential Growth; Physarum polycephalum; Drawing Machine; Tide Predicting Machine; Turing Pattern; Actual; Shape-morphing; Materiality; Imitation Learning; Human; Morphological Computation; Emerging discipline studying how physical structure or material properties can perform a portion of what is typically called “computation.”; Generative / Bio-inspired Algorithms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

that replicate natural processes of form-

adaptive shape or structure as a vital part

## Trinity of the Integration

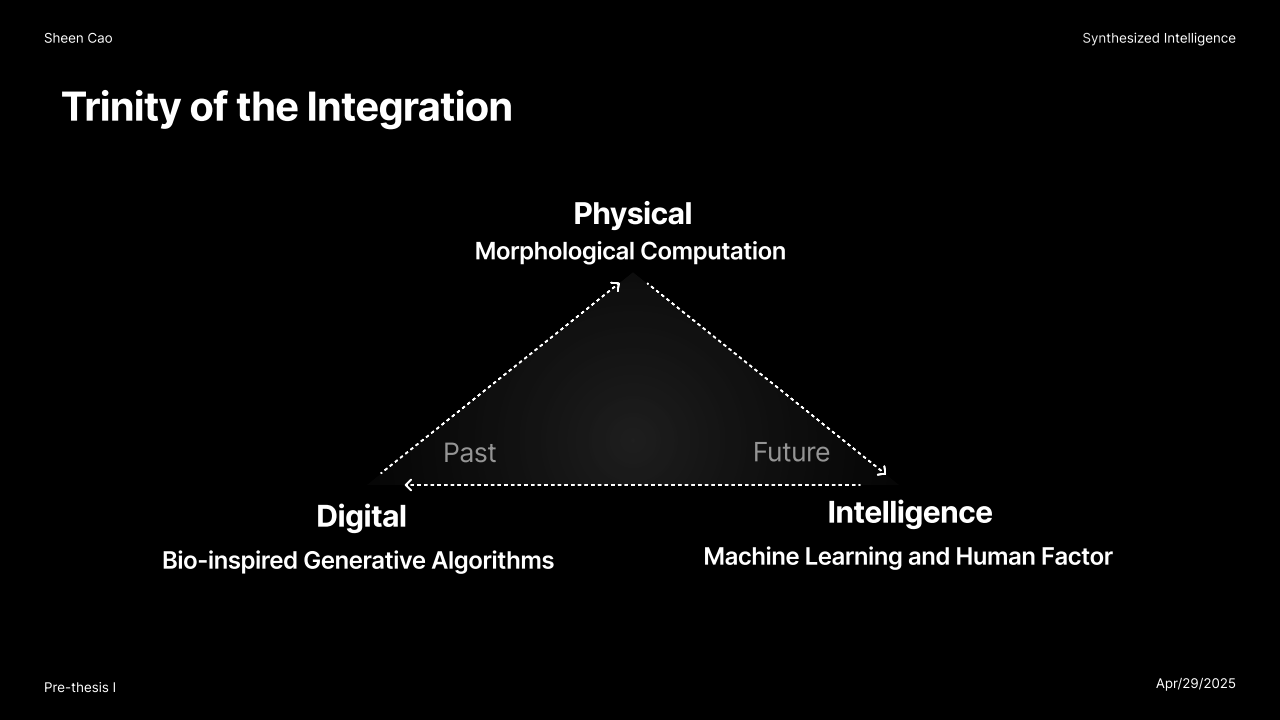
[picture p127: page 5]
Physical; Morphological Computation; Future; Intelligence; Past; Digital

Machine Learning and Human Factor

Bio-inspired Generative Algorithms

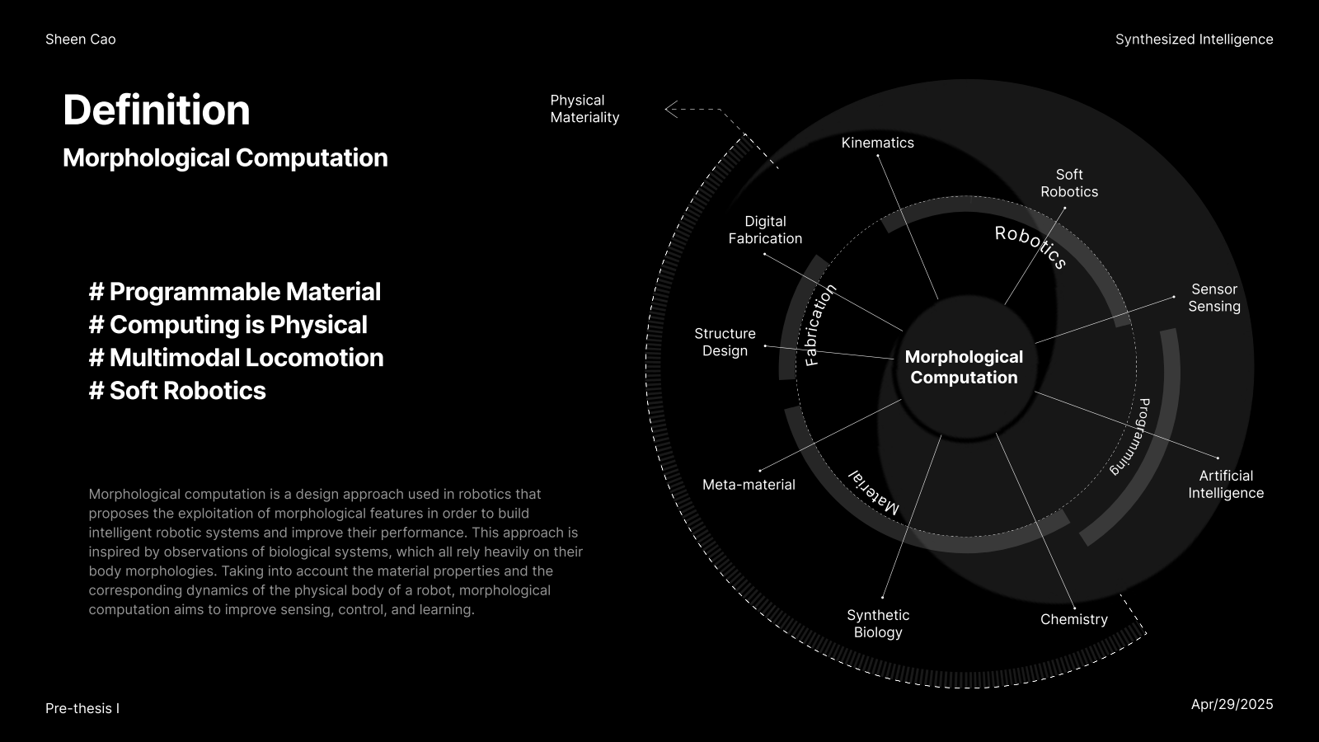
[picture p128: page 6]

Definition | Physical
| Materiality

Morphological Computation

# Programmable Material

# Computing is Physical

# Multimodal Locomotion

# Soft Robotics

Morphological computation is a design approach used in robotics that

proposes the exploitation of morphological features in order to build

intelligent robotic systems and improve their performance. This approach is

inspired by observations of biological systems, which all rely heavily on their

body morphologies. Taking into account the material properties and the

corresponding dynamics of the physical body of a robot, morphological

computation aims to improve sensing, control, and learning.

Digital

Fabrication

n
iot a

ic

r
b

Structure

Design | a
F

Meta-material

Kinematics

Soft

Robotics

Robotics

Morphological

Computation

l air et a M

Synthetic
Biology | Chemistry

Sensor

Sensing

P
r
o
gramm ni g

Artificial

Intelligence

Gap Analysis - Compared to the Conventional System

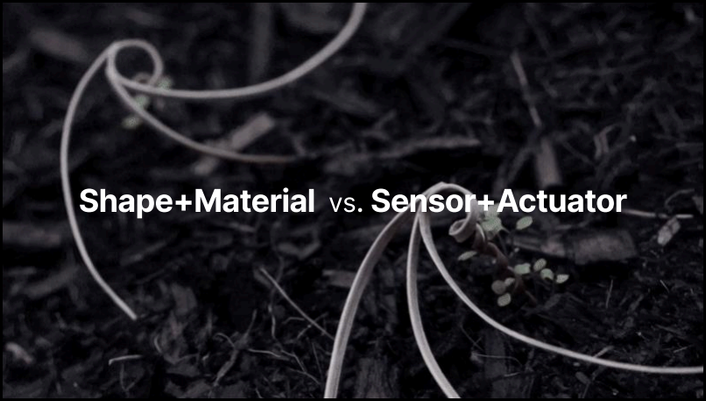
[picture p129: figure]
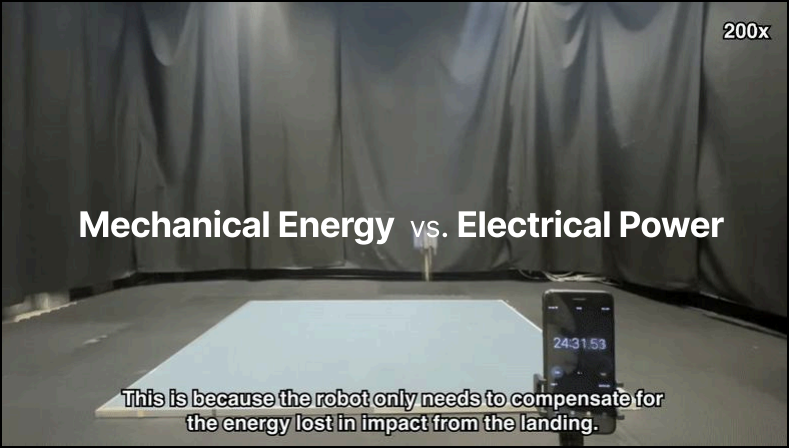
[picture p130: figure]

Shape+Material vs. Sensor+Actuator | Mechanical Energy vs. Electrical Power

Adaptability

Traditional systems need complex sensor+actuator stacks to conform to terrain; these seed carriers adapt “for free,” purely through their
shape. [1]
[1] Luo, D., Maheshwari, A., Danielescu, A. et al. Autonomous self-burying seed carriers for aerial seeding. Nature 614, 463–470 (2023). https://doi.org/10.1038/s41586-022-05656-3
[2] Bai, Songnan & Pan, Qiqi & Ding, Runze & Jia, Huaiyuan & Yang, Zhengbao & Chirarattananon, Pakpong. (2024). An agile monopedal hopping quadcopter with synergistic hybrid locomotion. Science robotics. 9. eadi8912. 10.1126/scirobotics.adi8912.

Efficiency

Conventional bipeds/quads burn kilowatts to hop or flap; the hybrid hopper re-uses mechanical energy. [2]

## Gap Analysis - Problem Space

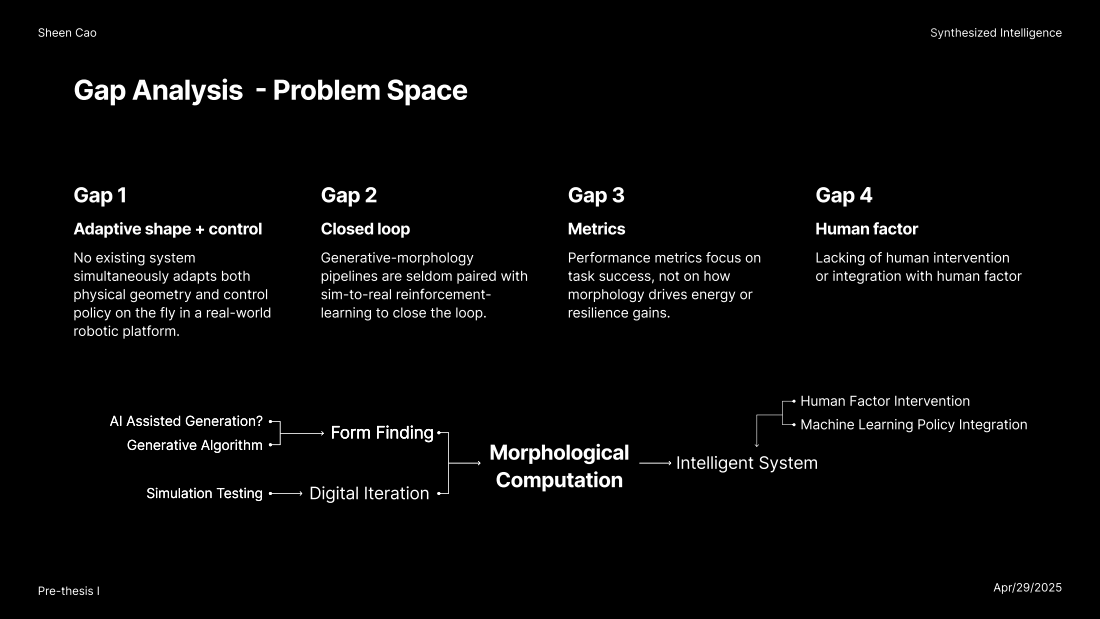
[picture p131: page 8]
Gap 1; Gap 2; Gap 3; Gap 4; Intelligent System; AI Assisted Generation?; Form Finding Generative Algorithm; Morphological; Computation Simulation Testing; Digital Iteration

Adaptive shape + control
No existing system
simultaneously adapts both
physical geometry and control
policy on the fly in a real-world
robotic platform.

Closed loop
Generative-morphology
pipelines are seldom paired with
sim-to-real reinforcement-
learning to close the loop.

Metrics
Performance metrics focus on
task success, not on how
morphology drives energy or
resilience gains.

Human factor
Lacking of human intervention
or integration with human factor

Human Factor Intervention
Machine Learning Policy Integration

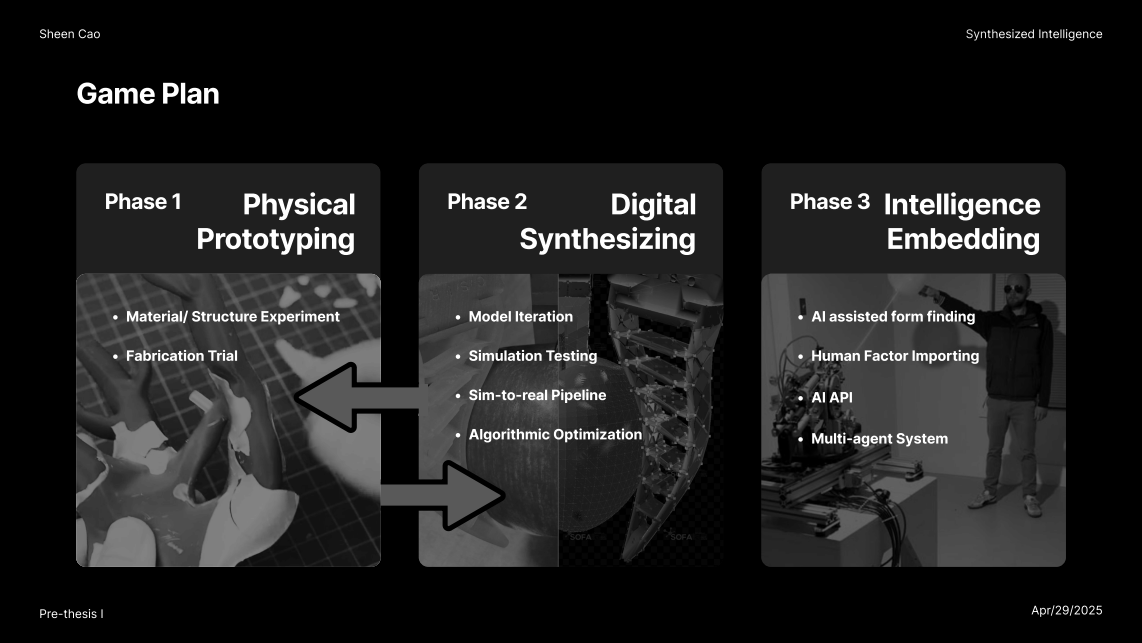
[picture p132: page 9]
Game Plan; Phase 1; Physical; Prototyping; Digital; Synthesizing; Phase 2; Phase 3 Intelligence; Embedding; Fabrication Trial; Model Iteration; Simulation Testing; Algorithmic Optimization; AI API

Material/ Structure Experiment

AI assisted form finding

Human Factor Importing

Sim-to-real Pipeline

Multi-agent System

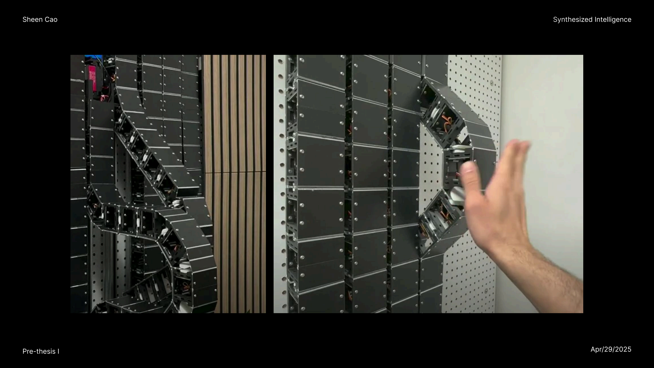
[picture p133: page 10]
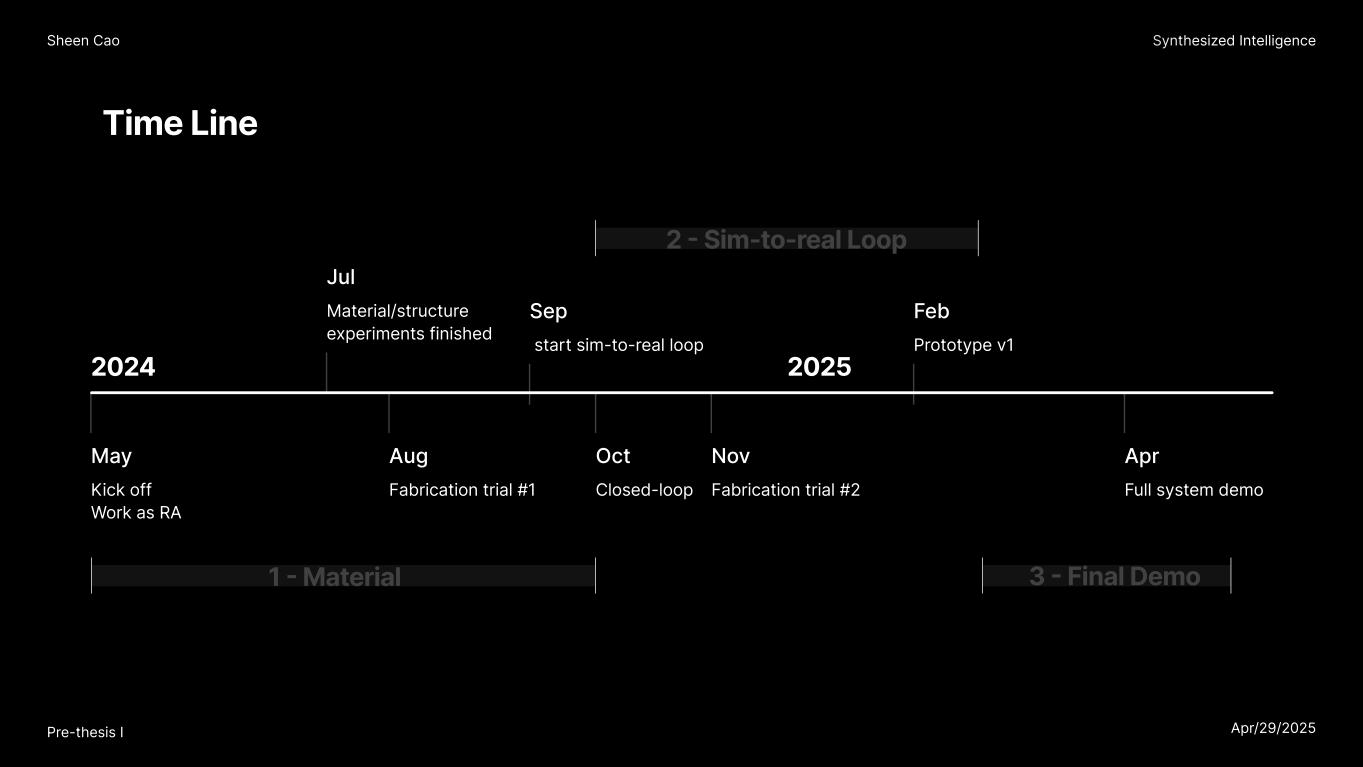
[picture p134: page 11]
Time Line; Jul; Material/structure; experiments finished; Sep; Feb; Prototype v1; May; Kick off; Aug; Oct; Nov; Apr; Fabrication trial #1; Closed-loop Fabrication trial #2; Full system demo; 1 - Material; 3 - Final Demo

2 - Sim-to-real Loop

start sim-to-real loop

Work as RA

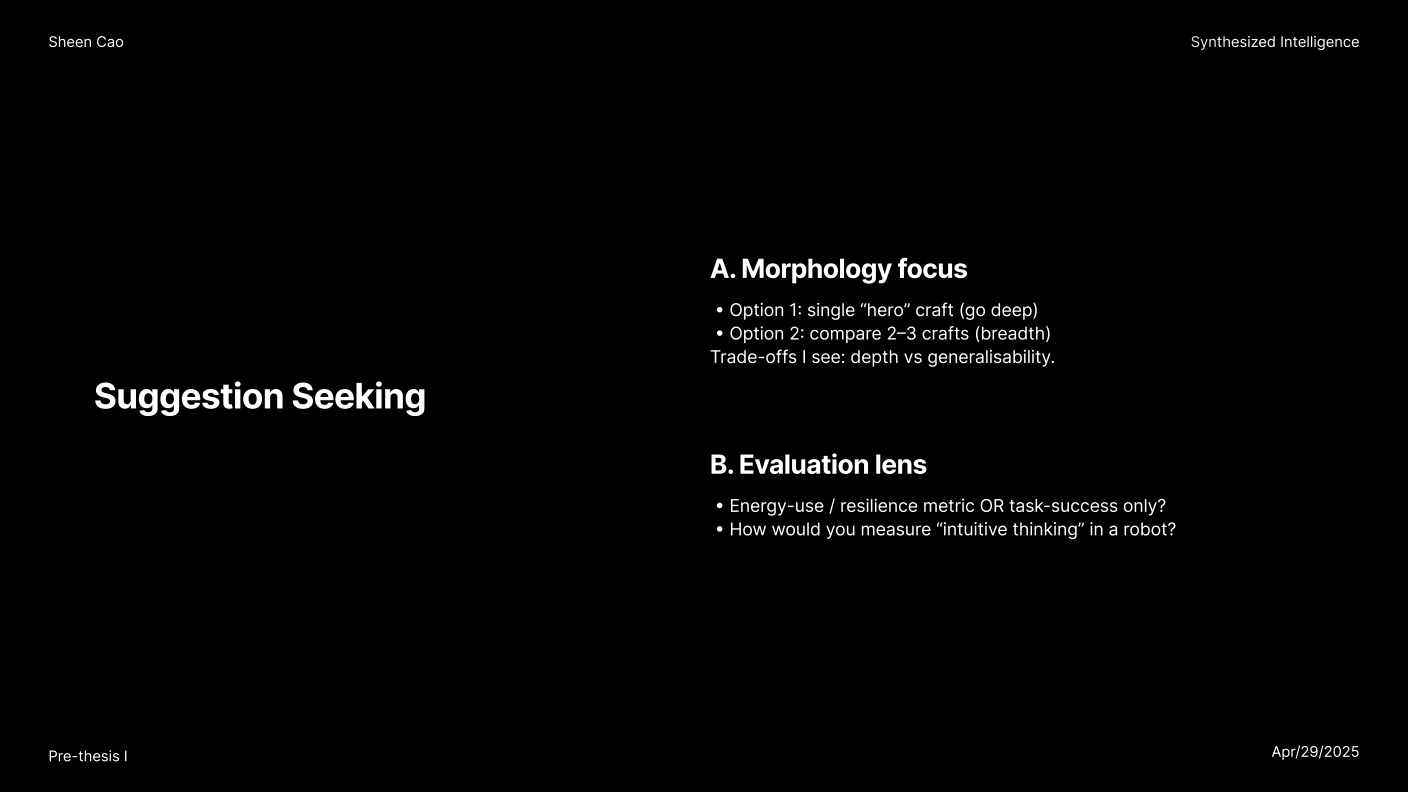
[picture p135: page 12]
Suggestion Seeking; A. Morphology focus; B. Evaluation lens

• Option 1: single “hero” craft (go deep)

• Option 2: compare 2–3 crafts (breadth)

Trade-offs I see: depth vs generalisability.

• Energy-use / resilience metric OR task-success only?

• How would you measure “intuitive thinking” in a robot?
