Sheen-Cao/Ballooance/3d_models/thesis_models.pdf

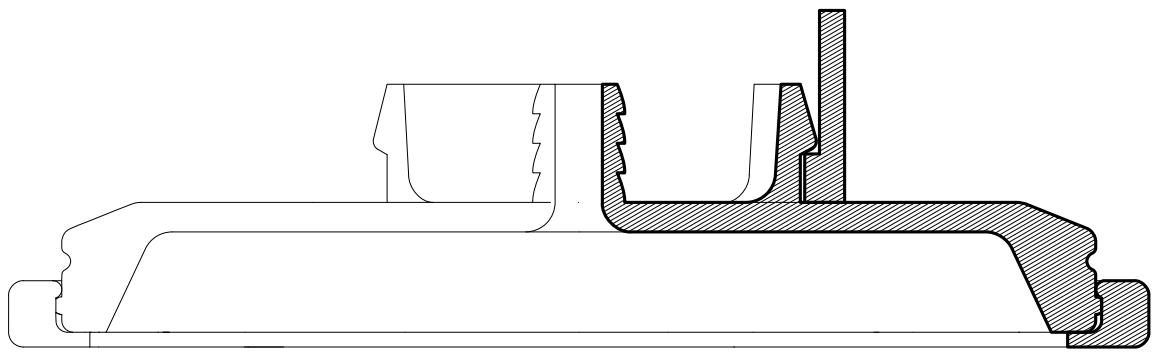
[picture p136: page 1]
