Sheen-Cao/Ballooance/Pics/section.pdf

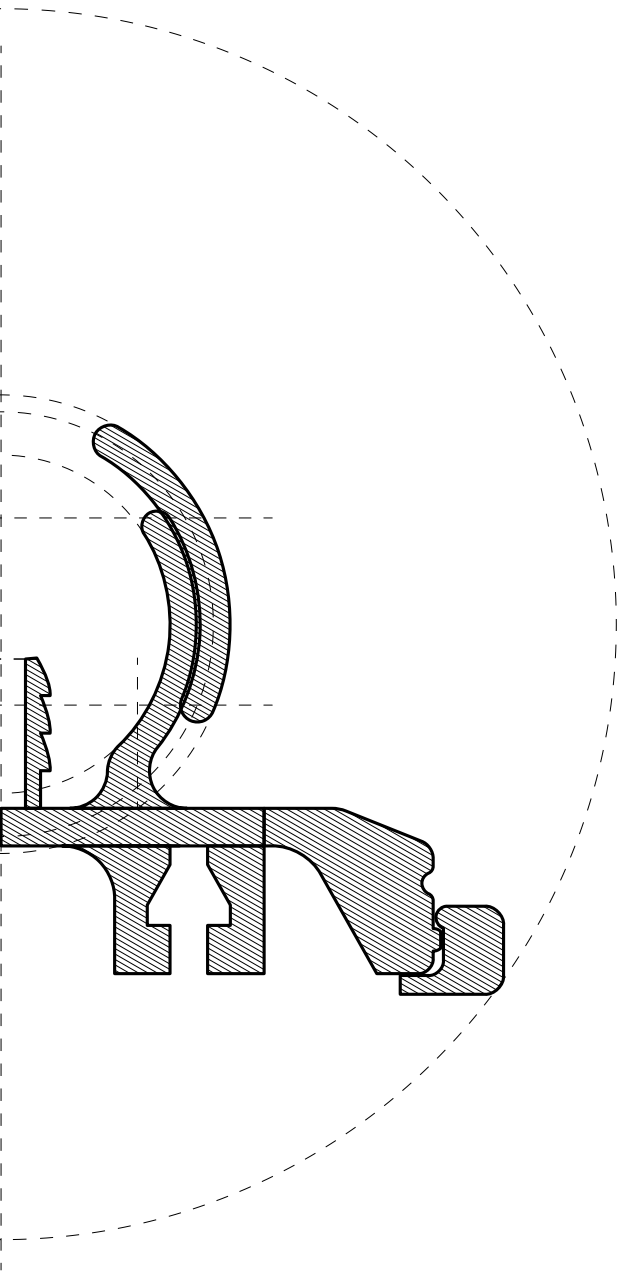
[picture p137: page 1]
