Sheen-Cao/Ballooance/(commit log)

2026-03-05 Added updated 3d model for the structure
    [thesis_model_test.3dm]
2026-03-09 Added gh file for model generation.
    [thesis_model_test.3dm]
2026-03-18 Finished the core piece gh components wiring.
    [thesis_model_test.3dm]
2026-04-03 upadeted the files first for later edition.
    [thesis_model_test.3dm]
2026-04-07 Updated the rhino model files. Finished new generator files.
    [thesis_model_test.3dm, thesis_models.3dm]
2026-04-14 ready to push
    [thesis_models.3dm]
2026-04-16 Added Mujoco simulation folder.
    [thesis_models.3dm]
2026-04-16 Updated 3d model file.
    [thesis_models.3dm]
2026-04-30 Added arduino control files.
2026-04-30 big commit.
    [thesis_models.3dm]
